otoone-dev/docs/afuue_project/pictures/printing.png

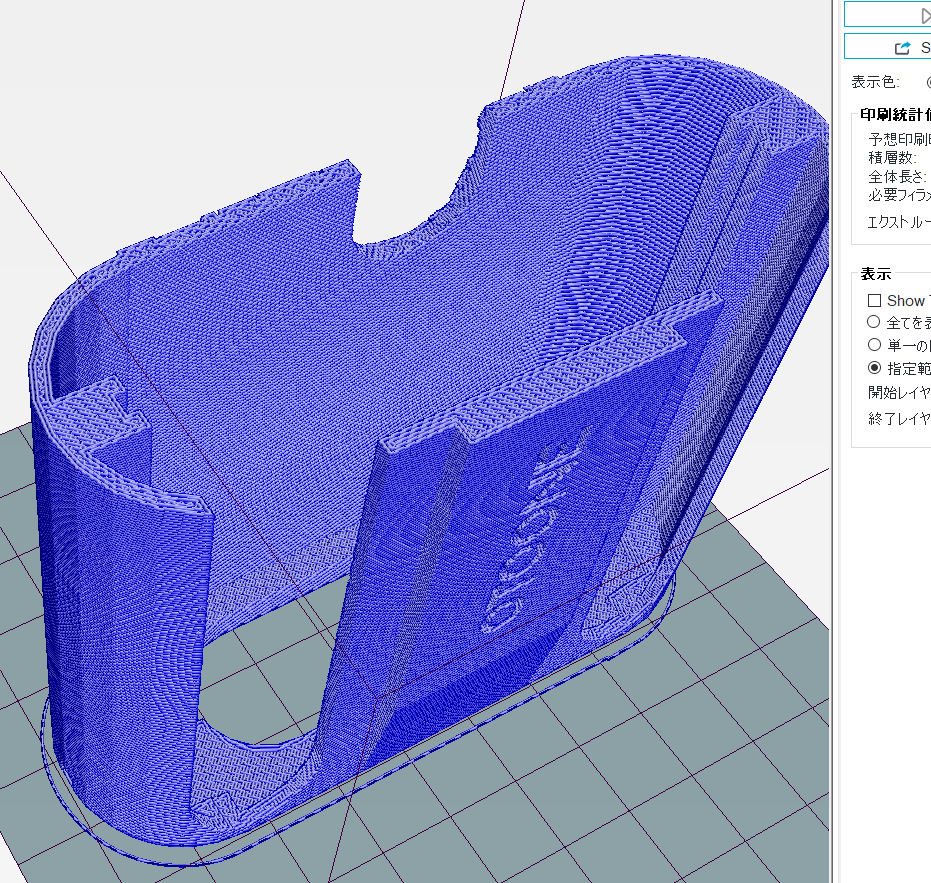
afuue_project/pictures/printing.png
