otoone-dev/docs/afuue_project/pictures/soldering.jpg

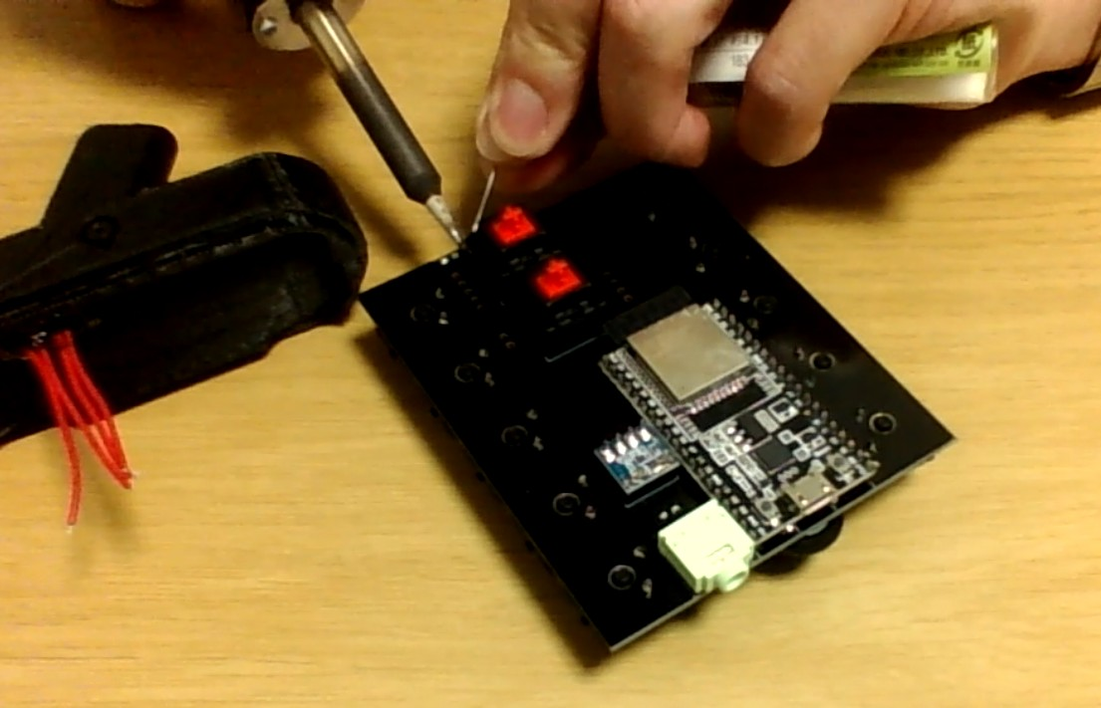
afuue_project/pictures/soldering.jpg
