otoone-dev/docs/afuue_project/pictures/afuue2.jpg

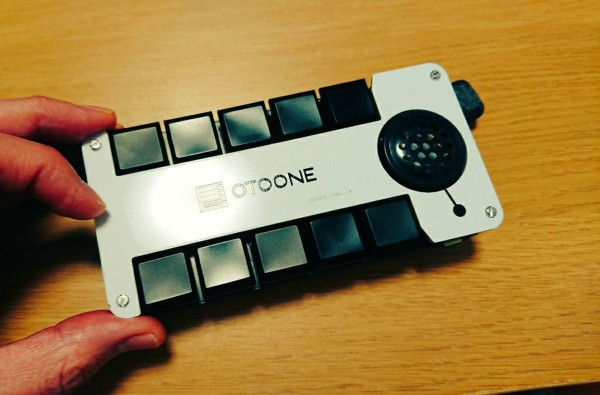
afuue_project/pictures/afuue2.jpg
