otoone-dev/docs/afuue_project/pictures/afuue2_back.jpg

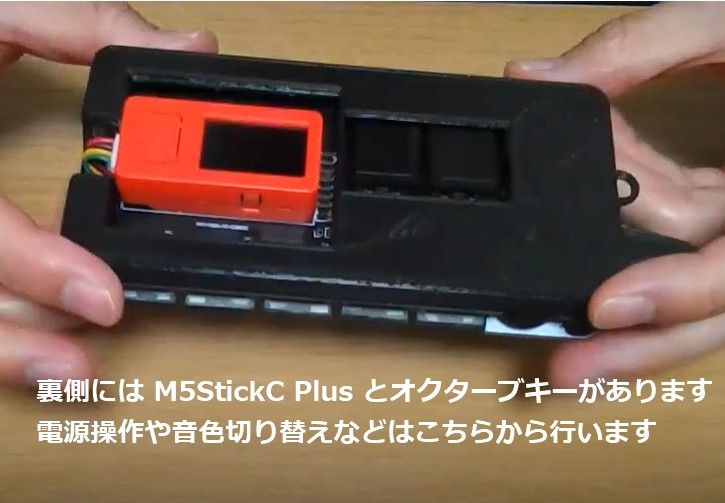
afuue_project/pictures/afuue2_back.jpg
