otoone-dev/docs/afuue_project/pictures/AFUUE2_FootController.JPG

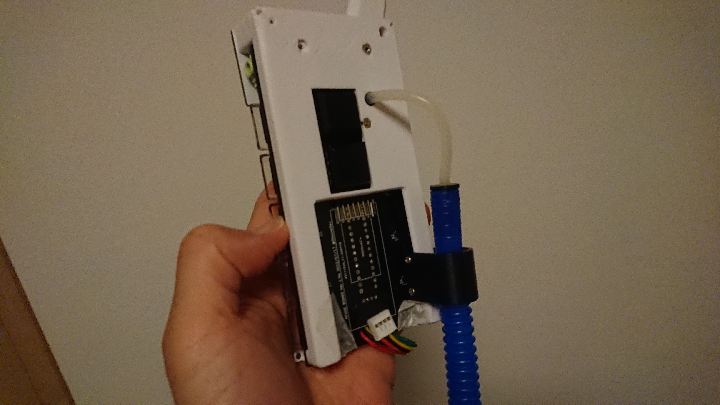
afuue_project/pictures/AFUUE2_FootController.JPG
