otoone-dev/docs/afuue_project/pictures/AFUUE2_PCB.JPG

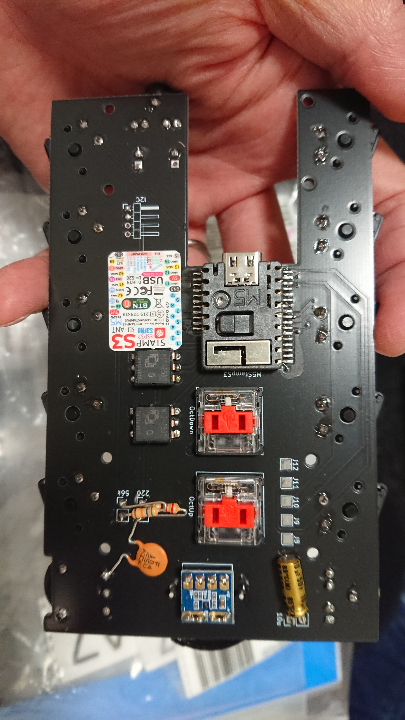
afuue_project/pictures/AFUUE2_PCB.JPG
