otoone-dev/docs/afuue_project/pictures/afuue2r.jpg

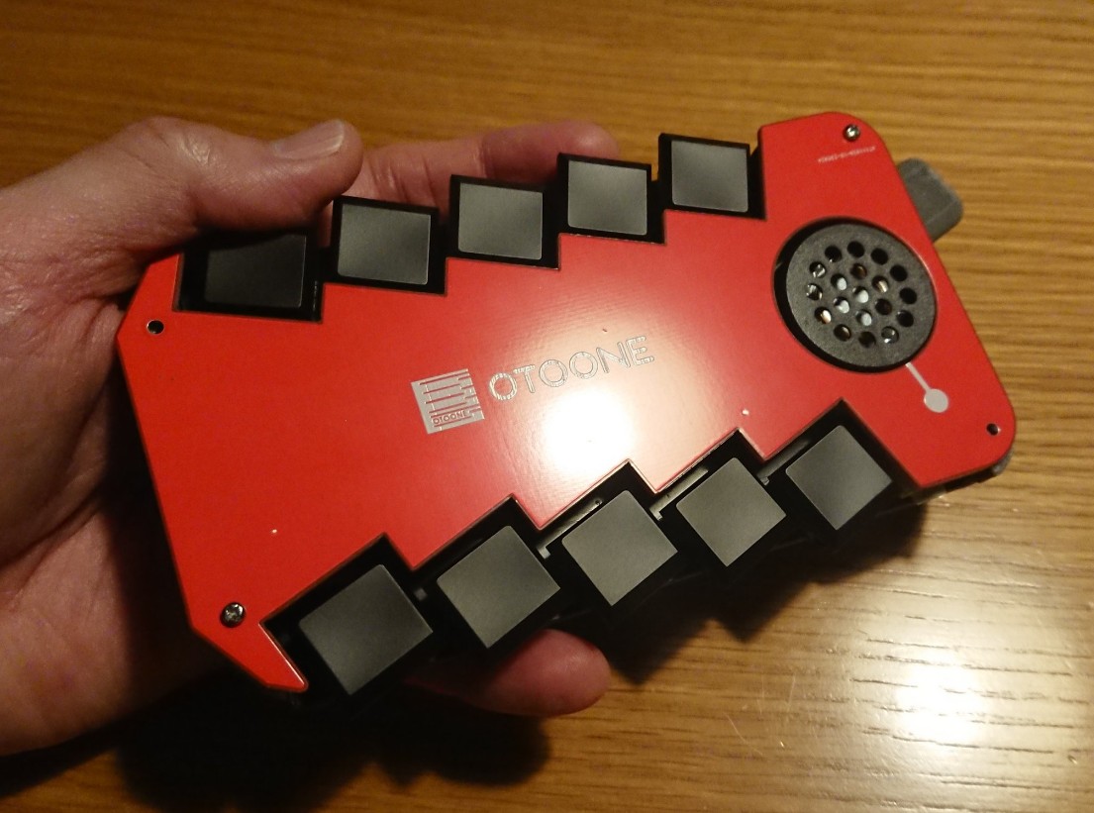
afuue_project/pictures/afuue2r.jpg
