otoone-dev/docs/afuue_project/pictures/afuue2r_cad.jpg

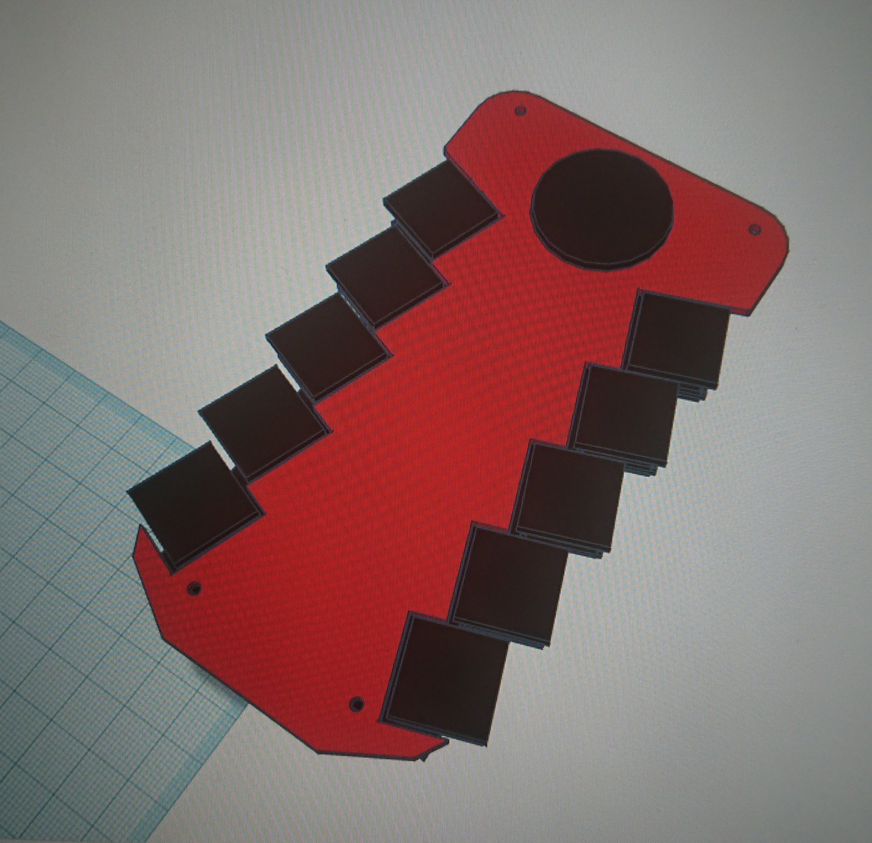
afuue_project/pictures/afuue2r_cad.jpg
