otoone-dev/docs/afuue_project/pictures/AFUUE2R_pict.jpg

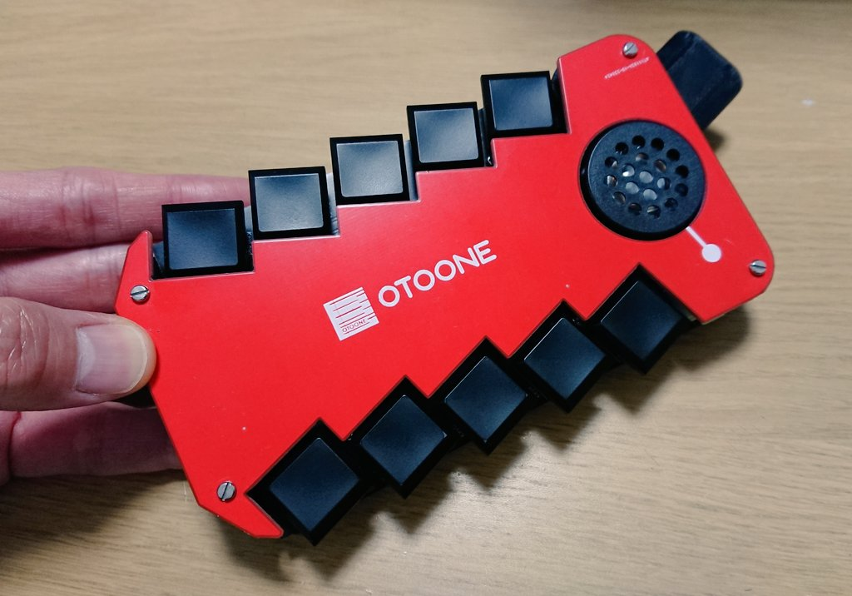
afuue_project/pictures/AFUUE2R_pict.jpg
