otoone-dev/docs/afuue_project/pictures/afuue9.jpg

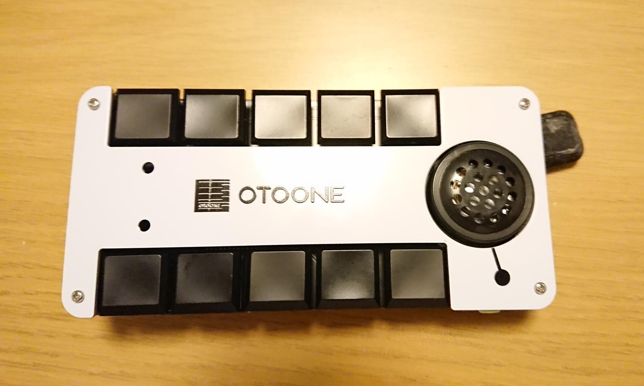
afuue_project/pictures/afuue9.jpg
