otoone-dev/docs/afuue_project/pictures/afuue9_overview.png

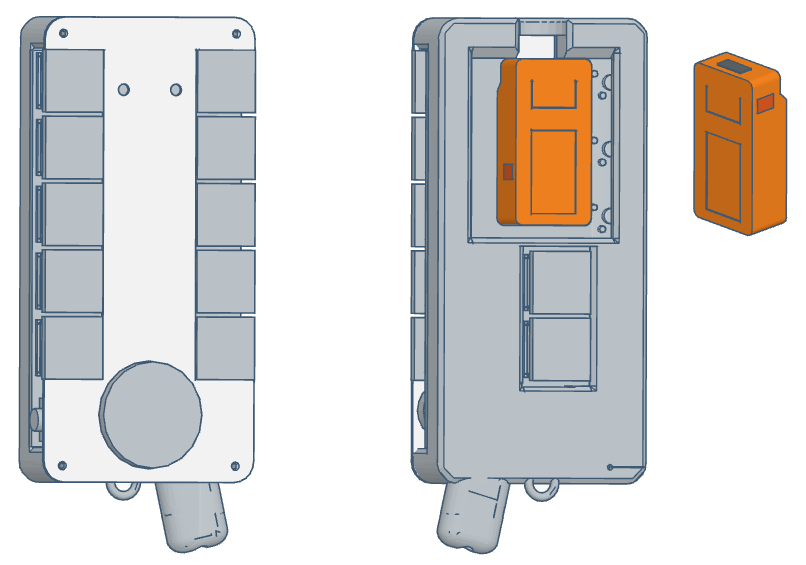
afuue_project/pictures/afuue9_overview.png
