otoone-dev/docs/afuue_project/pictures/afuue10.jpg

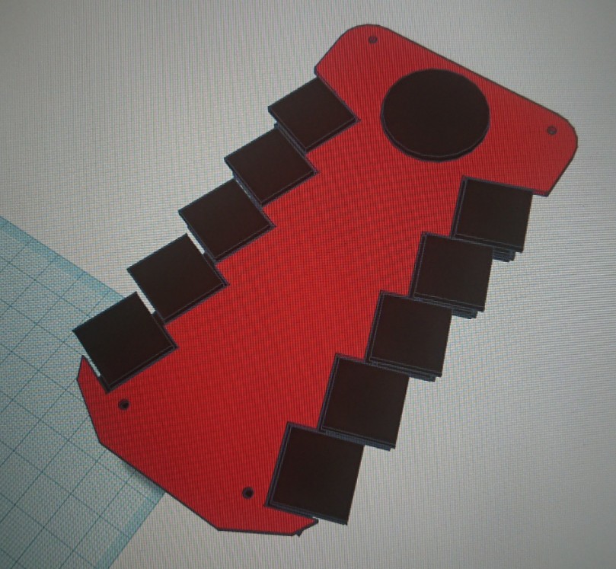
afuue_project/pictures/afuue10.jpg
