otoone-dev/docs/afuue_project/pictures/afuue.jpg

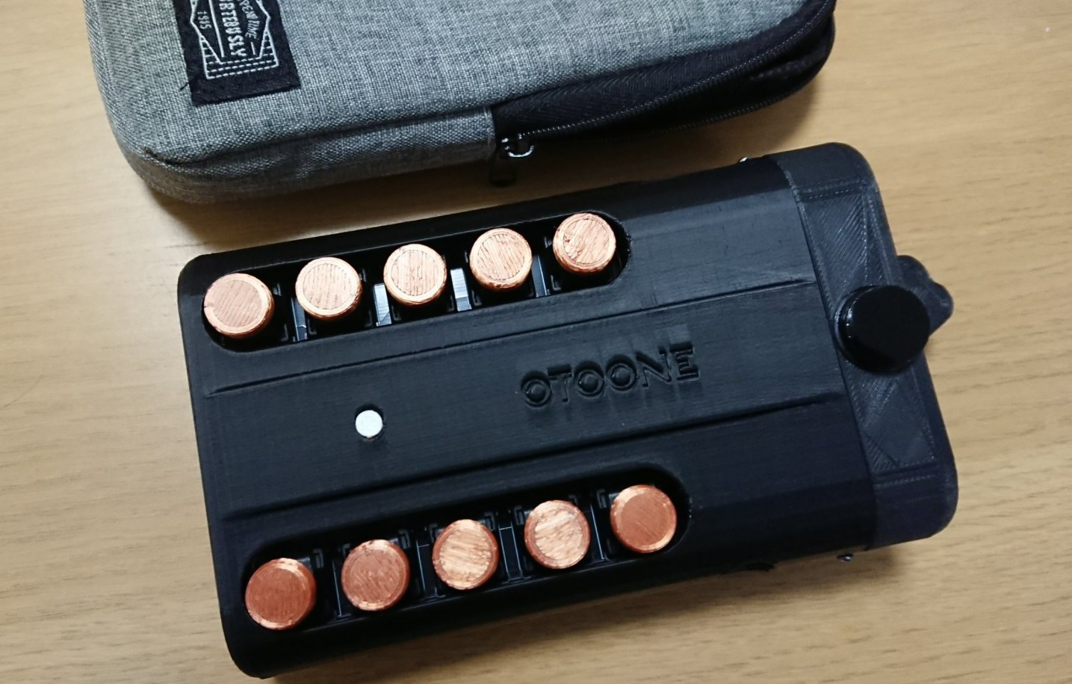
afuue_project/pictures/afuue.jpg
