otoone-dev/docs/afuue_project/pictures/arduino_ide.png

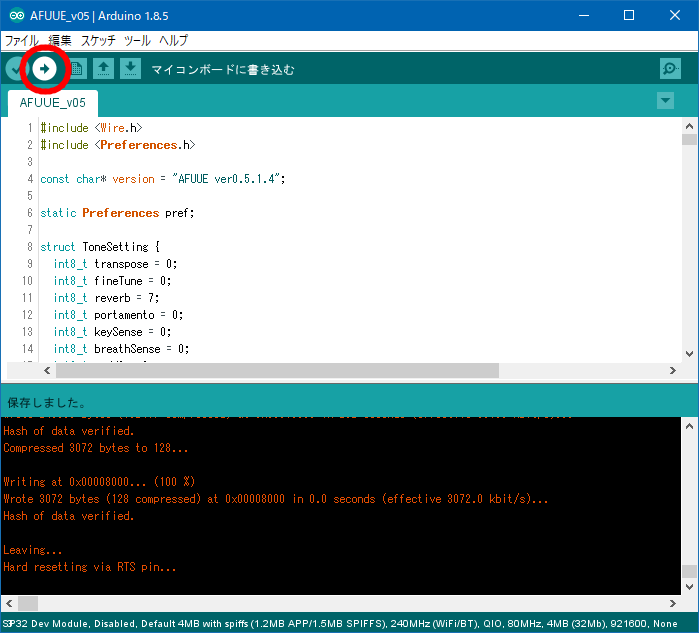
afuue_project/pictures/arduino_ide.png
