otoone-dev/docs/afuue_project/pictures/electrical_circuit.png

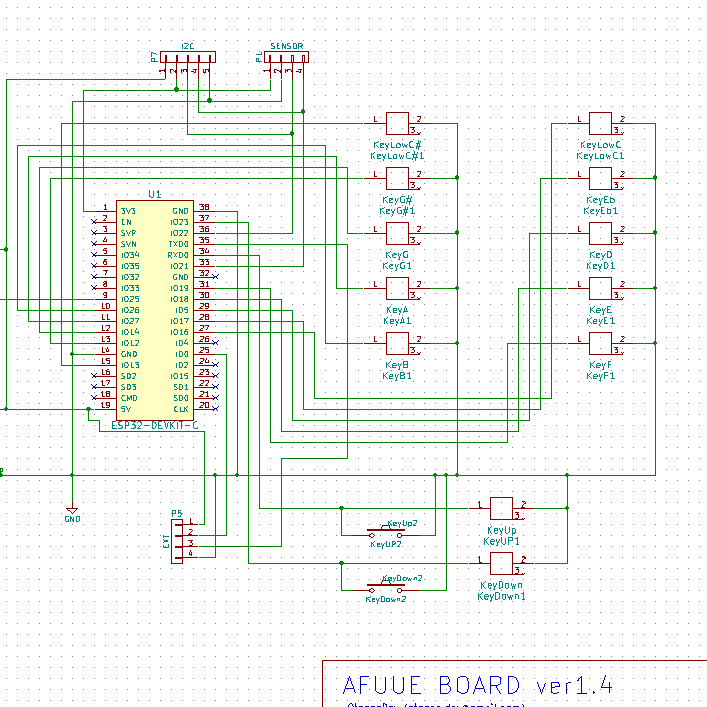
afuue_project/pictures/electrical_circuit.png
