otoone-dev/docs/afuue_project/pictures/modeling.png

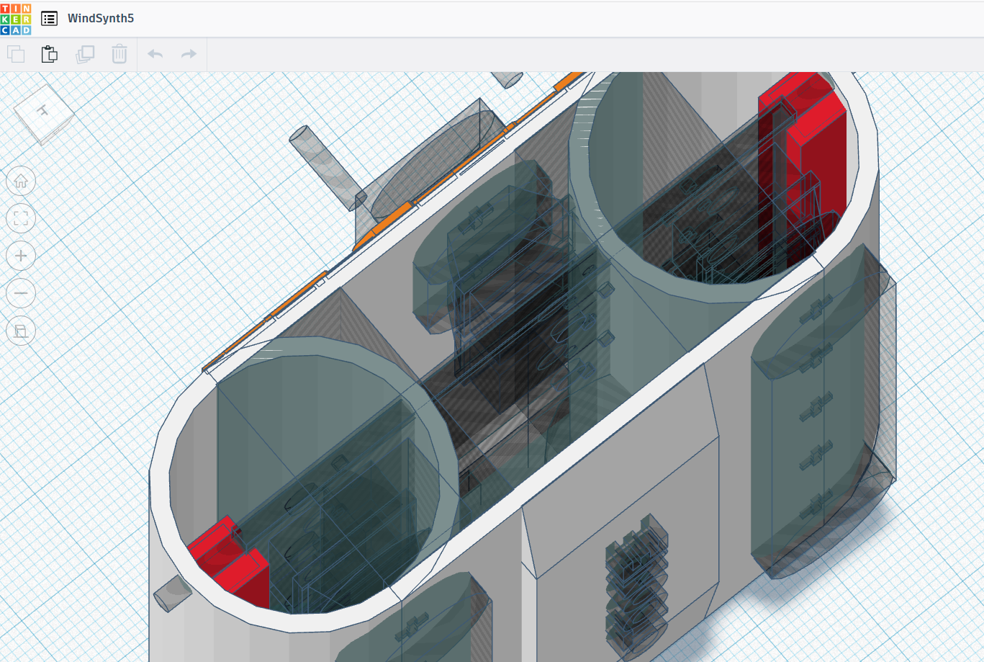
afuue_project/pictures/modeling.png
