otoone-dev/docs/afuue_project/pictures/my_afuue_creator.png

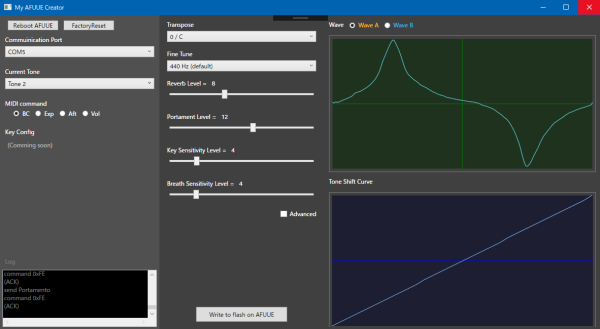
afuue_project/pictures/my_afuue_creator.png
