otoone-dev/docs/afuue_project/pictures/namecard/background2.png

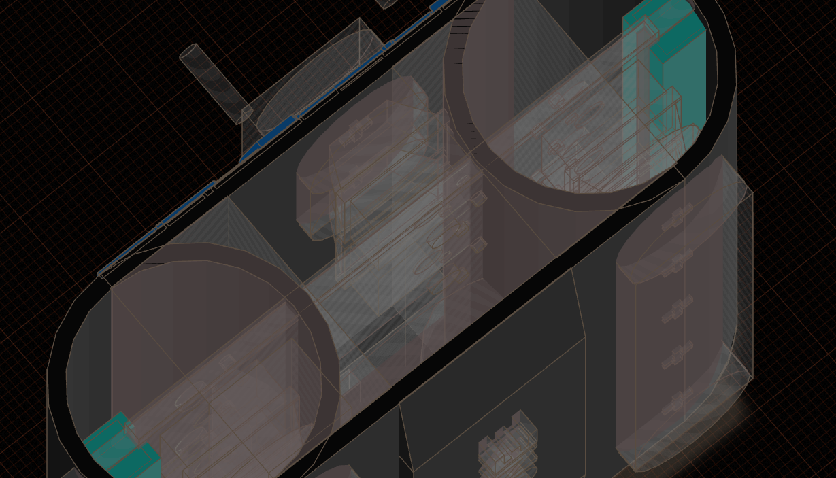
afuue_project/pictures/namecard/background2.png
