otoone-dev/docs/afuue_project/pictures/namecard/background.png

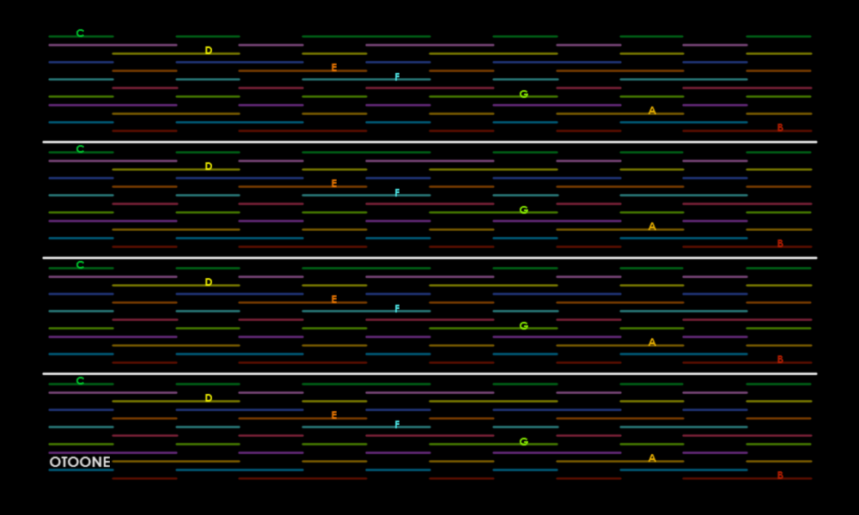
afuue_project/pictures/namecard/background.png
