otoone-dev/docs/afuue_project/pictures/programming_arduino.png

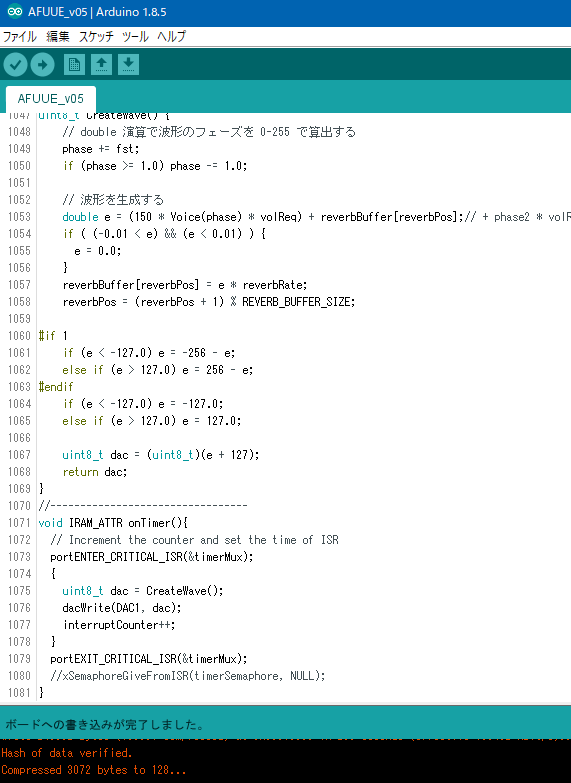
afuue_project/pictures/programming_arduino.png
