otoone-dev/docs/afuue_project/pictures/programming_windows.png

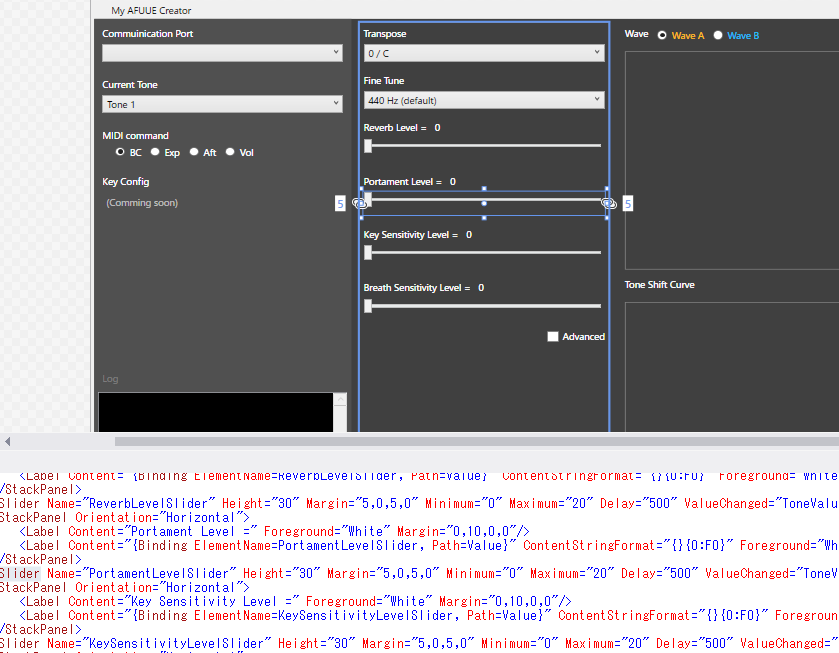
afuue_project/pictures/programming_windows.png
