otoone-dev/docs/afuue_project/pictures/shield_machine.jpg

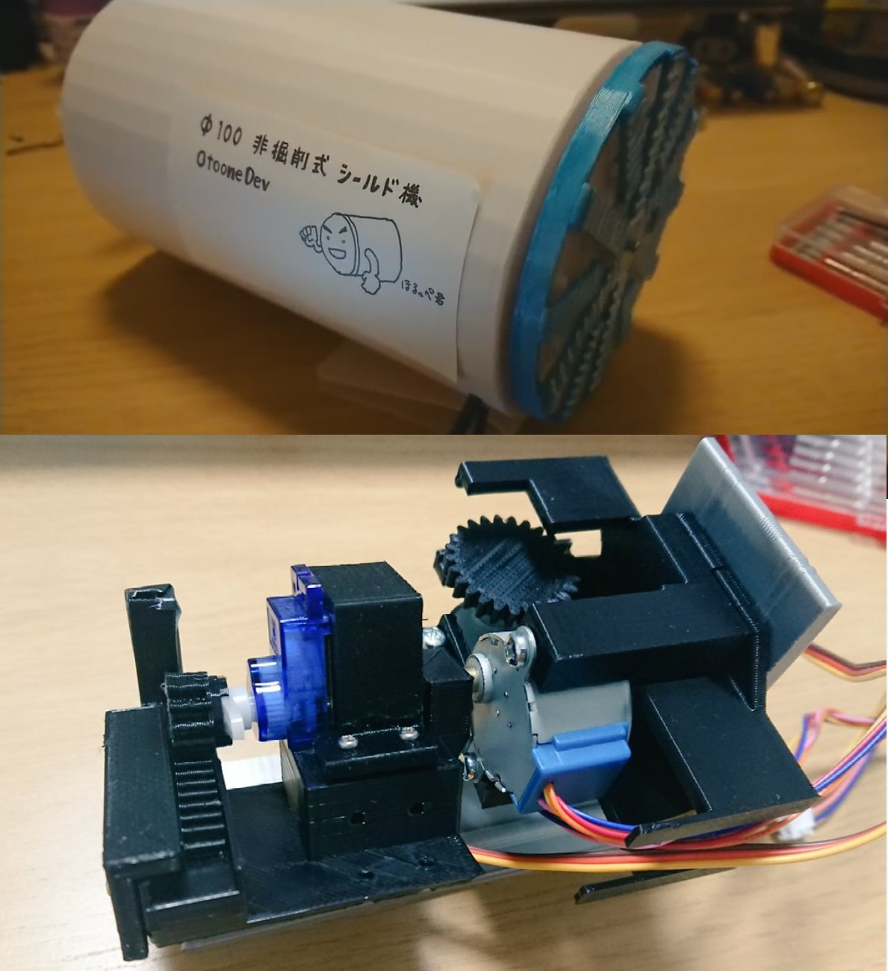
afuue_project/pictures/shield_machine.jpg
