otoone-dev/docs/afuue_project/pictures/twitter.png

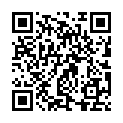
afuue_project/pictures/twitter.png
