otoone-dev/docs/afuue_project/pictures/webpage.png

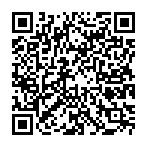
afuue_project/pictures/webpage.png
