otoone-dev/docs/afuue_project/pictures/white.png

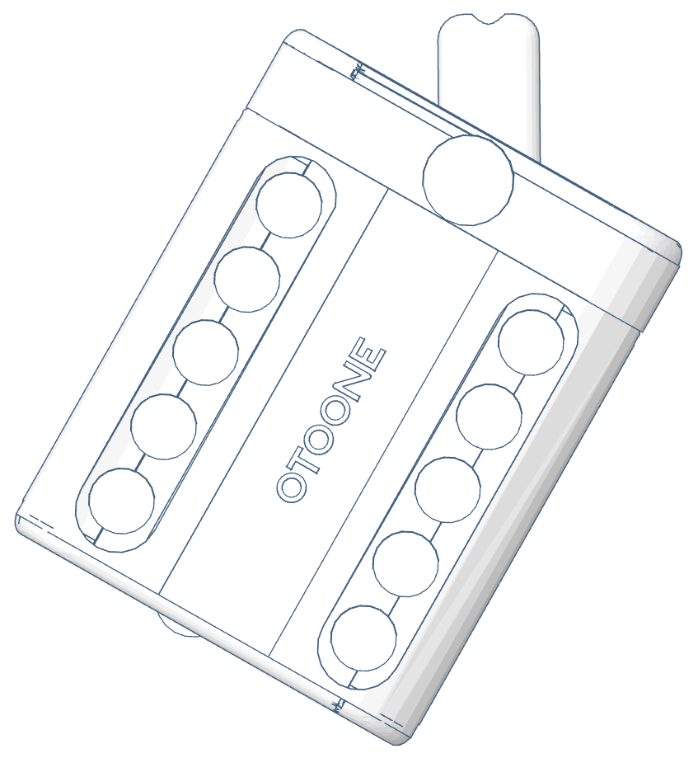
afuue_project/pictures/white.png
