otoone-dev/docs/afuue_project/Tool/MyAfuueCreator/MyAfuueCreator/Resources/FingeringChart.png

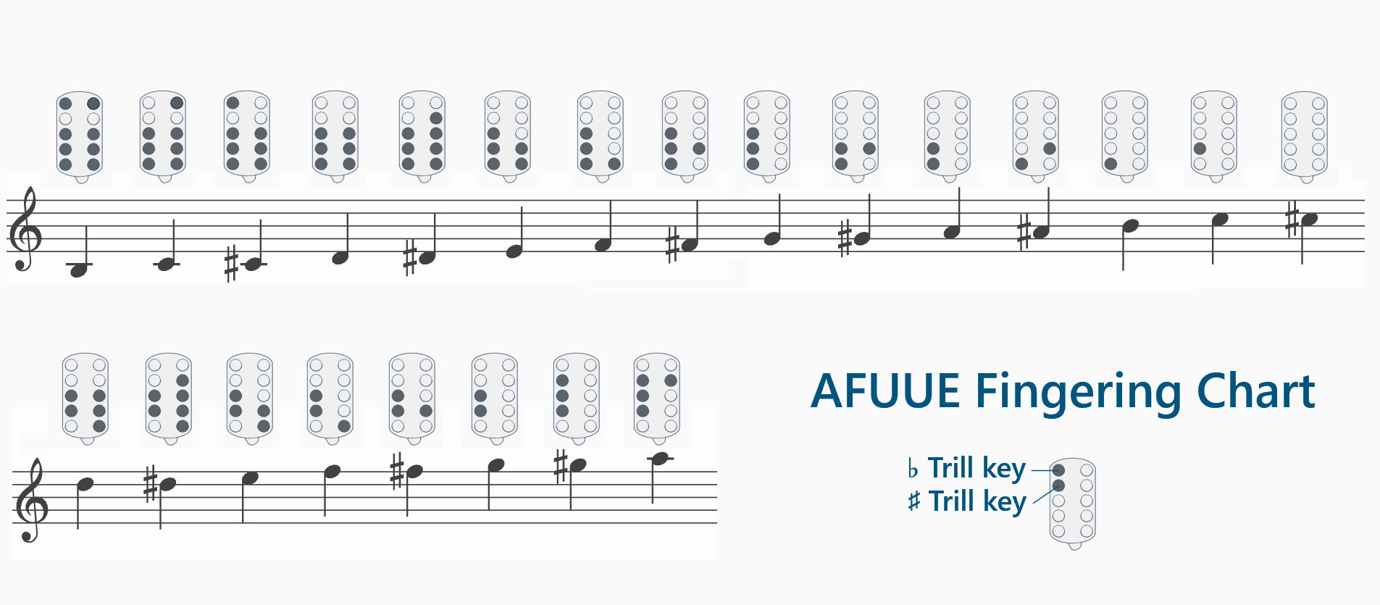
afuue_project/Tool/MyAfuueCreator/MyAfuueCreator/Resources/FingeringChart.png
