otoone-dev/docs/arduino/M5Stamp/PC1245/E500_font.png

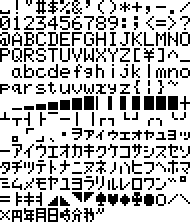
arduino/M5Stamp/PC1245/E500_font.png
