otoone-dev/docs/arduino/M5Stamp/PC1245/pc1245Revived.png

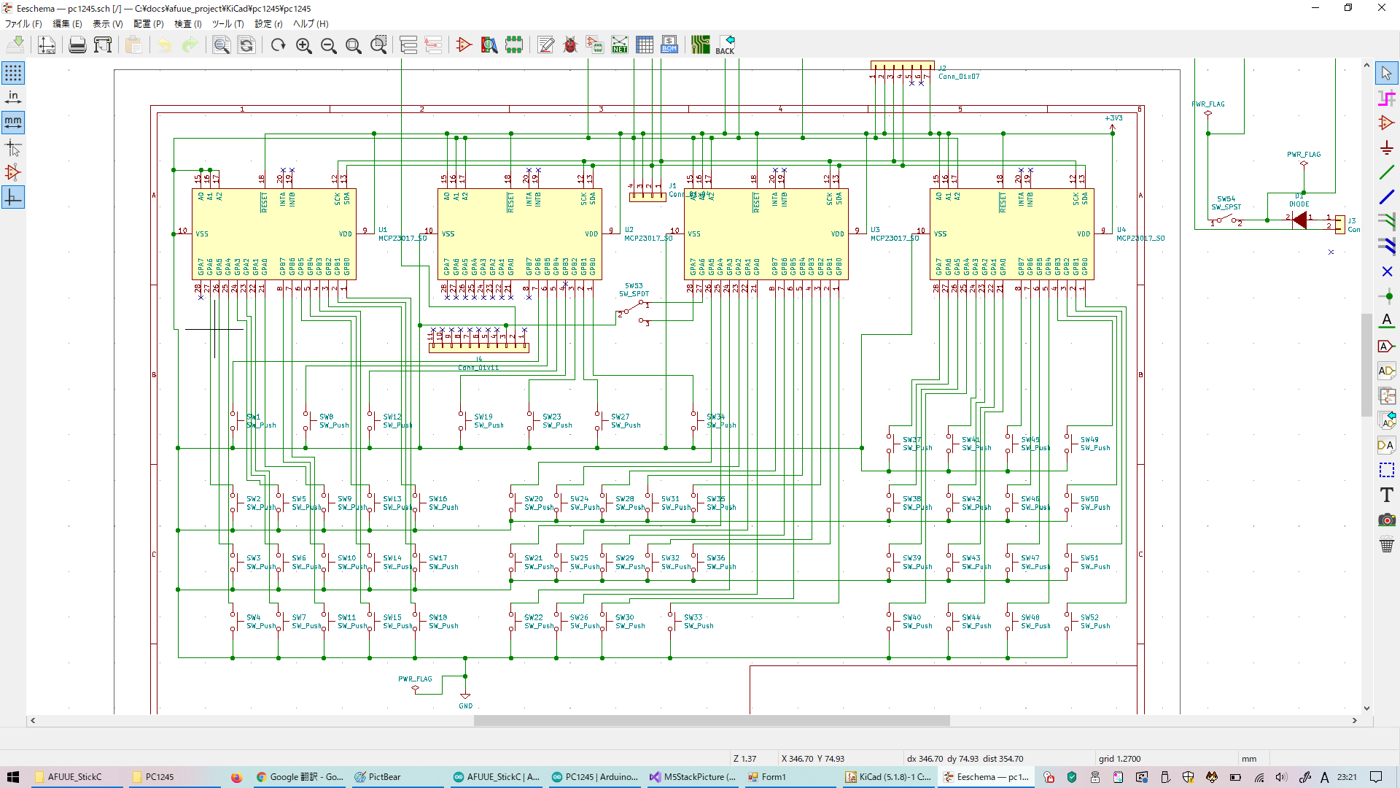
arduino/M5Stamp/PC1245/pc1245Revived.png
