otoone-dev/docs/images/afuue6.jpg

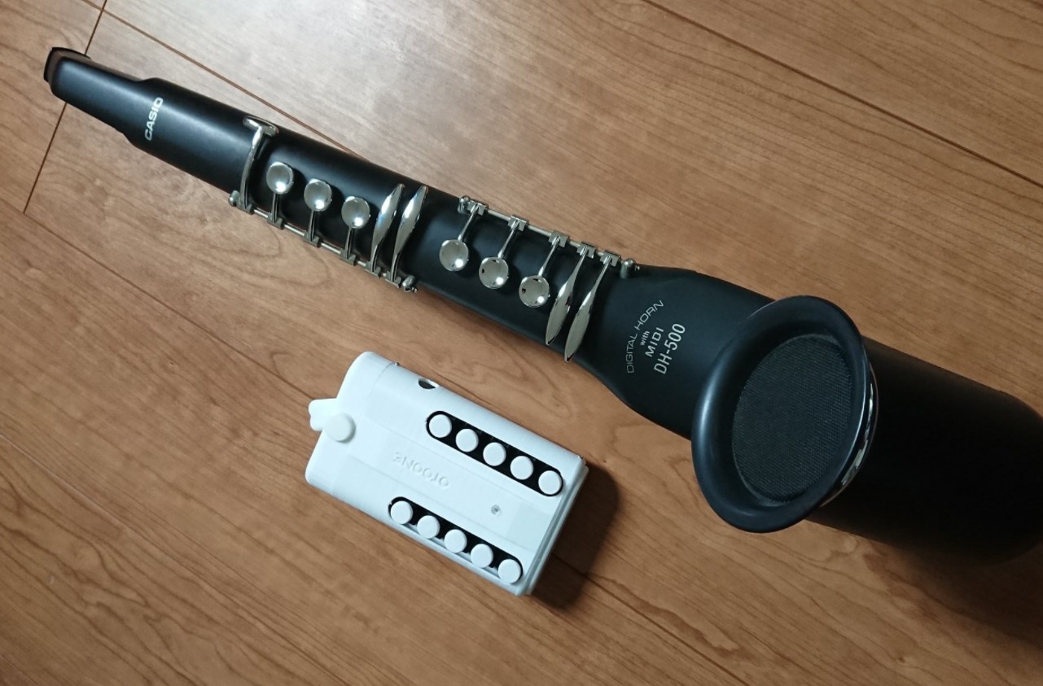
images/afuue6.jpg
