otoone-dev/docs/images/afuue_family.jpg

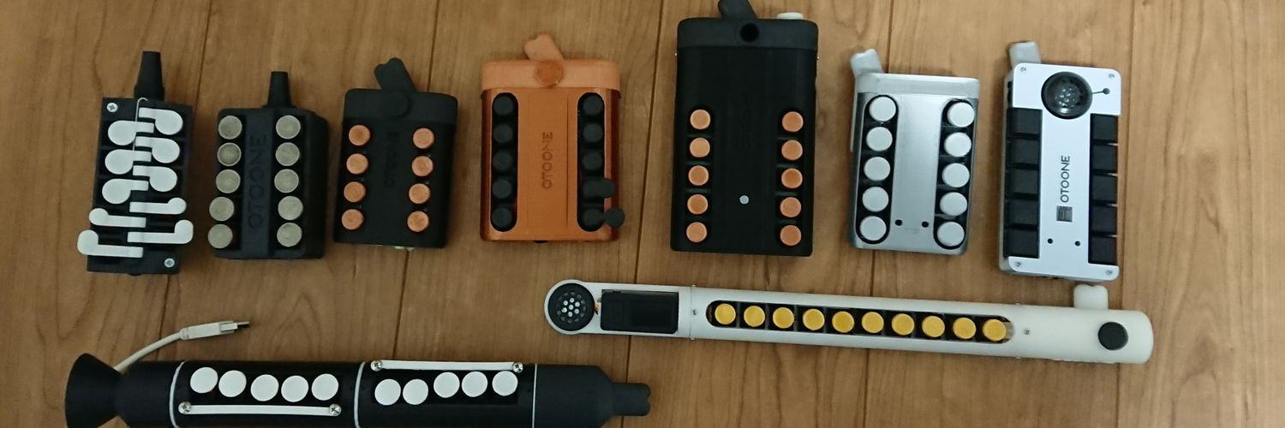
images/afuue_family.jpg
