otoone-dev/docs/images/afuue_prototypes.jpg

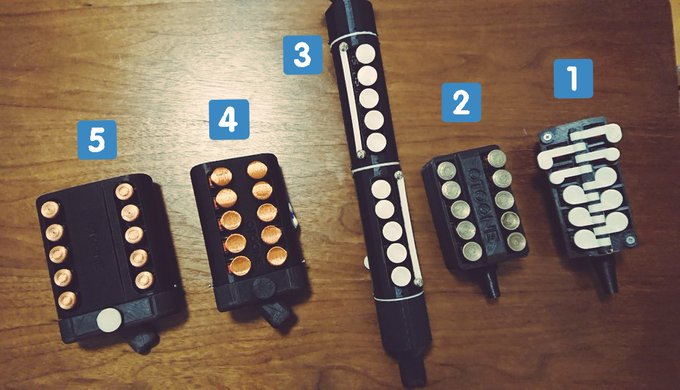
images/afuue_prototypes.jpg
