otoone-dev/docs/images/afuue_size.jpg

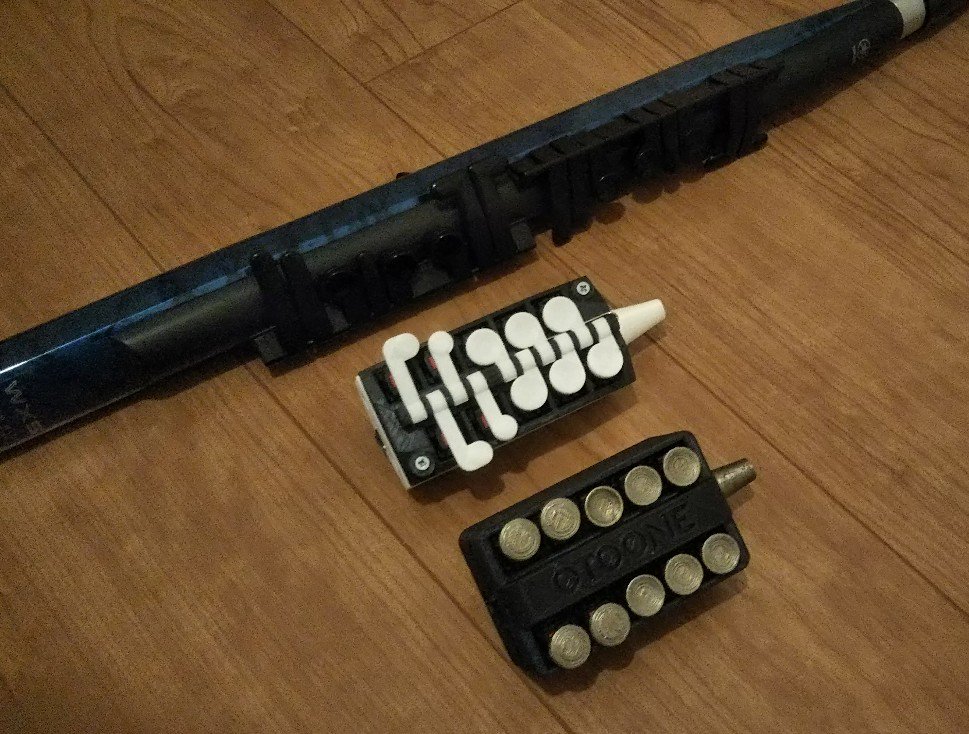
images/afuue_size.jpg
