otoone-dev/docs/images/inst_01.jpg

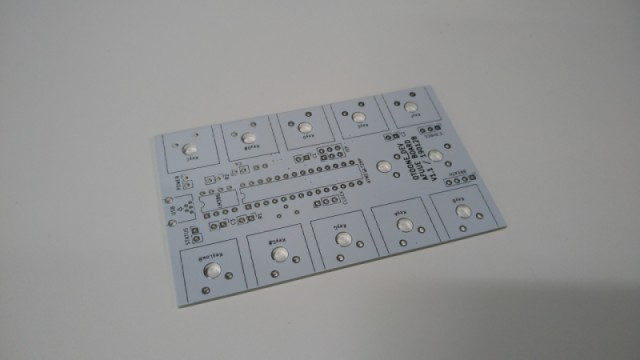
images/inst_01.jpg
