otoone-dev/docs/images/inst_02.jpg

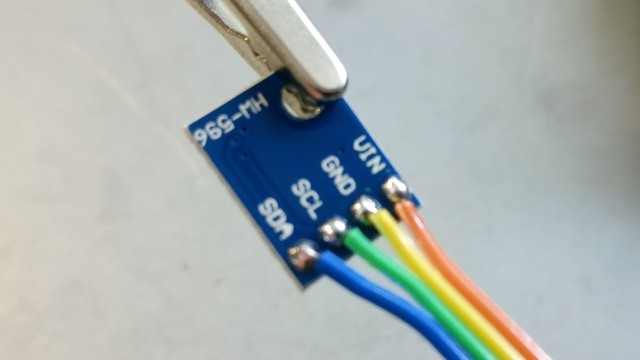
images/inst_02.jpg
