otoone-dev/docs/images/inst_03.jpg

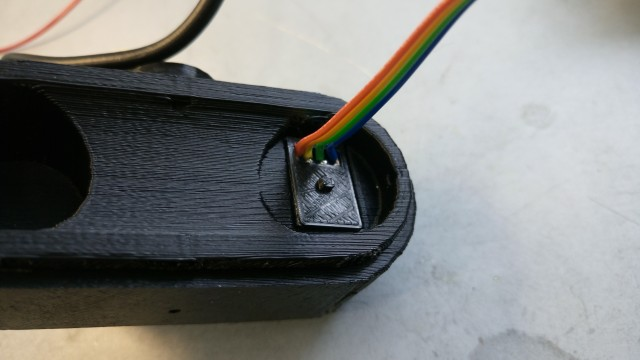
images/inst_03.jpg
