otoone-dev/docs/images/inst_04.jpg

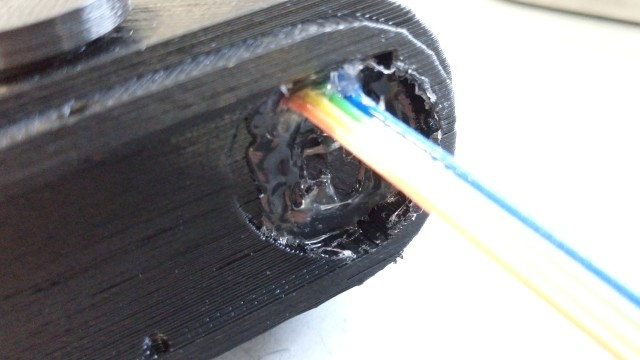
images/inst_04.jpg
