otoone-dev/docs/images/inst_06.jpg

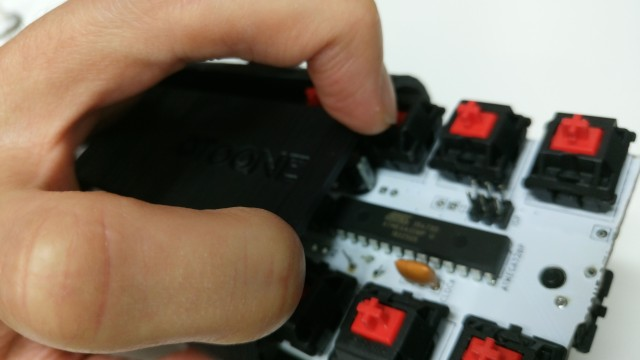
images/inst_06.jpg
