otoone-dev/docs/images/inst_07.jpg

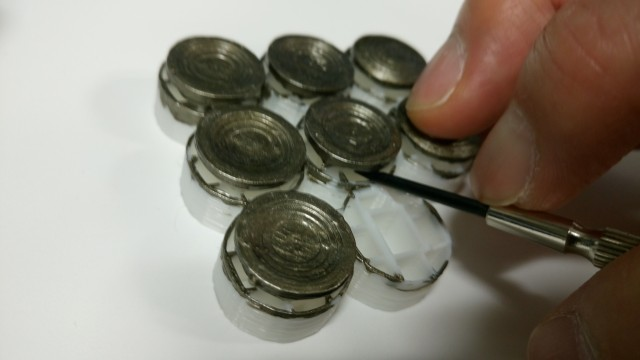
images/inst_07.jpg
