otoone-dev/docs/images/inst_08.jpg

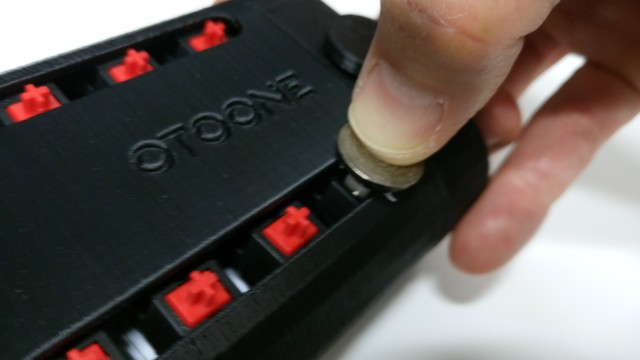
images/inst_08.jpg
