otoone-dev/docs/images/inst_09.jpg

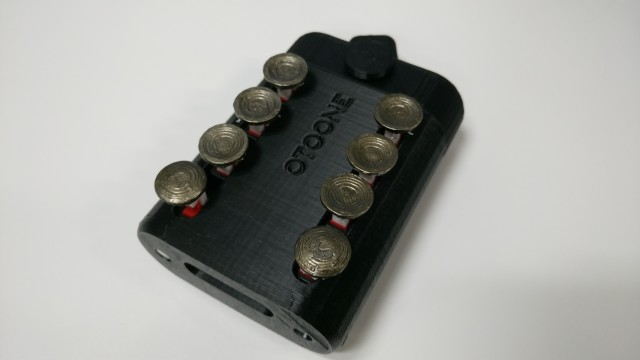
images/inst_09.jpg
