otoone-dev/docs/images/otoone_app.jpg

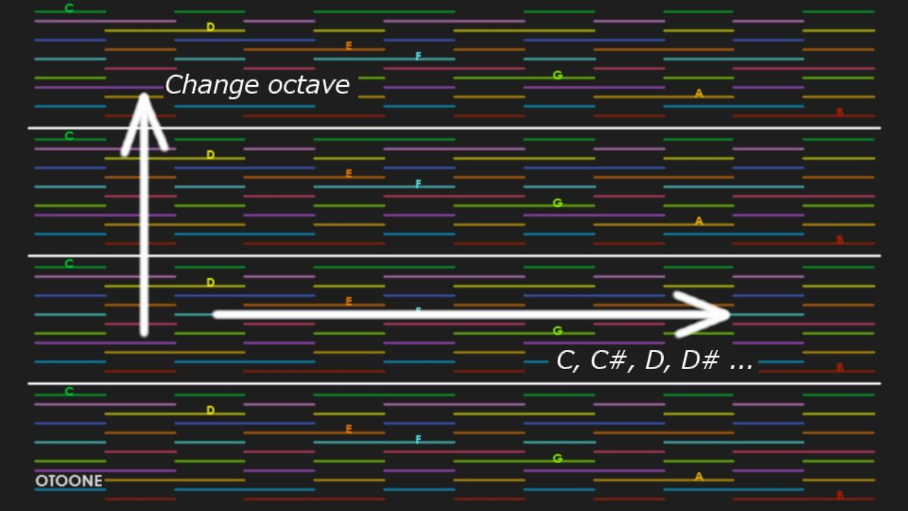
images/otoone_app.jpg
