otoone-dev/docs/images/pcb.jpg

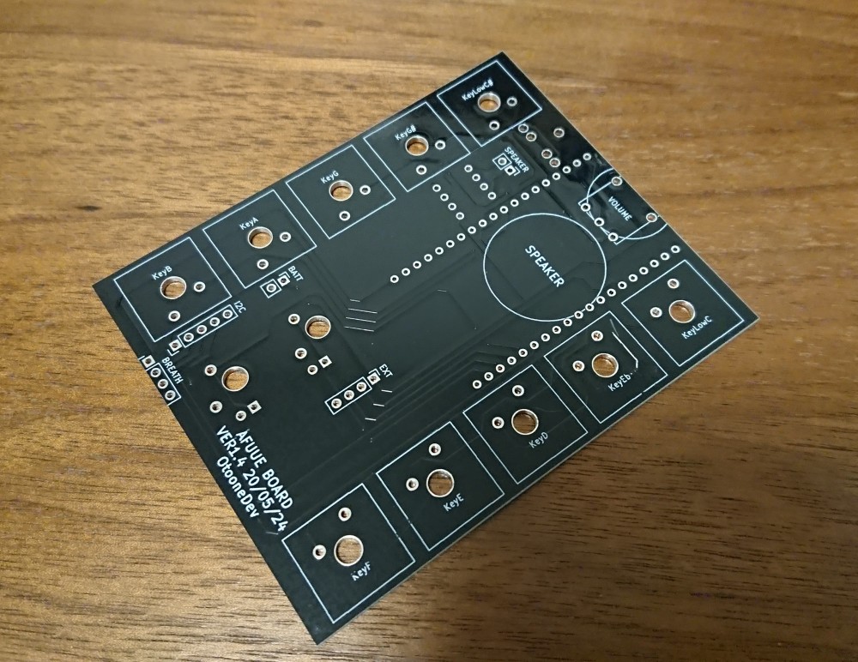
images/pcb.jpg
