otoone-dev/docs/watch_bg.png

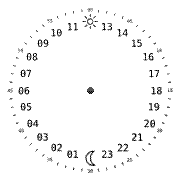
watch_bg.png
