otoone-dev/docs/afuue_project/KiCad/test/order.txt

お支払いいただき、ありがとうございました

お客さまのご注文番号P178677

取引参照番号9GE45182GT647472R

金額￥2,469  JPY

YASUHIRO OTOWA様、お支払いが完了しました。ご注文内容についてご質問がございましたら、以下の番号まで電話でお問い合わせください。
ショッピングサイトに戻る:   

連絡先sales@switch-science.com
362653615

注文の明細

    小計￥ 2,469

    合計 (JPY)￥ 2,469

-----------------------------------

お客さまのご注文番号P191622

取引参照番号79R70965E8740543H

金額￥2,469  JPY

YASUHIRO OTOWA様、お支払いが完了しました。ご注文内容についてご質問がございましたら、以下の番号まで電話でお問い合わせください。
ショッピングサイトに戻る:   

連絡先sales@switch-science.com
362653615

注文の明細

    小計￥ 2,469

    合計 (JPY)￥ 2,469
