otoone-dev/docs/afuue_project/パーツリスト.xls

Sheet: Sheet1
AFUUE ver1.6 部品表
品名 | 単価 | 数量 | 購入価格 | 在庫 | 対応台数 | 購入先
プリント基板 | 680 | 1 | 680 | 0 | 0 | Seeed Fusion PCB | 上がるかもしれない
ボディ (3Dプリンタ) | 600 | 1 | 600 | 5 | 5 |  | ３万円 / 50台 = 600円 くらい？
マウスピース (3Dプリンタ) | 300 | 1 | 300 | 5 | 5
キー (3Dプリンタ、レジン加工済) | 50 | 12 | 600 | 108 | 9
メンテナンスホールキャップ (3Dプリンタ) | 50 | 1 | 50 | 13 | 13
LEDベース (3Dプリンタ) | 30 | 1 | 30 | 10 | 10
LEDディフューザ (3Dプリンタ) | 30 | 1 | 30 | 10 | 10
Cherry MX 赤軸 | 77 | 12 | 924 | 106 | 8.833333333 | JWシステム | https://www.jw-shop.com/P-keyboard-mswitch10/page40/detail.htm
ESP32-DEVKIT-C V4 | 1480 | 1 | 1480 | 10 | 10 | 秋月電子 | http://akizukidenshi.com/catalog/g/gM-11819/ | Amazon Waves製品なら 1,000円くらい
AE-PAM8012 | 300 | 1 | 300 | 9 | 9 | 秋月電子 | http://akizukidenshi.com/catalog/g/gK-08217/
連結ソケット | 54 | 1 | 54 | 9 | 9 | 秋月電子 | http://akizukidenshi.com/catalog/g/gP-00264/
基板実装型スピーカー UGSM30B-8-01 | 100 | 1 | 100 | 9 | 9 | 秋月電子 | https://akizukidenshi.com/catalog/g/gP-09271/
006P バッテリーホルダー | 50 | 1 | 50 | 9 | 9 | 秋月電子 | https://akizukidenshi.com/catalog/g/gP-08160/
定電流発光ダイオード (φ3 白) OSM5DK5A31A? | 20 | 1 | 20 | 9 | 9 | 秋月電子 | https://akizukidenshi.com/catalog/g/gI-10739/
78L05 | 30 | 1 | 30 | 12 | 12 | aitendo | https://www.aitendo.com/product/3288
3.5 オーディオジャック PJ-307 (緑) | 30 | 1 | 30 | 11 | 11 | aitendo | https://www.aitendo.com/product/11073 (PJ-325)
3.5 オーディオジャック PJ-307 (黒) | 30 | 1 | 30 | 10 | 10 | aitendo | https://www.aitendo.com/product/4432 (PJ-307)
気圧センサ BMP180 モジュール | 495 | 1 | 495 | 11 | 11 | aitendo | https://www.aitendo.com/product/10760 | ディスコン？Amazon HiLetgo製品なら 200円
ダイヤル可変抵抗 (R1001-N16 B10KΩ-T1) | 50 | 1 | 50 | 11 | 11 | aitendo | https://www.aitendo.com/product/5202
抵抗 (47 Ω) | 5 | 2 | 10 | 多数 |  | aitendo | https://www.aitendo.com/product/14366
抵抗 (510 Ω) | 5 | 1 | 5 | 多数 |  | aitendo | https://www.aitendo.com/product/14366
HYコネクタ４ピンアングル | 10 | 1 | 10 | 17 | 17 | aitendo | https://www.aitendo.com/product/19473
HYコネクタ付ケーブル (CB-HY-200S) | 70 | 1 | 70 | 12 | 12 | aitendo | https://www.aitendo.com/product/18805
M2 ネジ | 5 | 2 | 10 | 多数
梱包用の小袋 |  |  | 0
発送用の緩衝材 |  |  | 0
発送用の箱？ |  |  | 0
手数料 |  |  | 500
合計 (送料、消費税除く) |  |  | 6458
送料 (秋月電子) | 500 |  | 100 |  |  |  | ５台まとめて買ったとして。
送料 (aitendo) | 490 |  | 100
送料 (JWシステム) | 800 |  | 160
合計 (消費税除く) |  |  | 6818
 |  |  | 11363

Sheet: Sheet2
AFUUE 組み立て手順（簡易版） 詳しい組み立て方は https://otoonedev.wixsite.com/afuue から「組み立て手順」を参照してください。 右下の QR コードからでも組み立て手順ページにジャンプできます。
キーを接着剤で接合します | LEDはLEDベースに差し、 黒いコネクタ側が長い足に なるような向きで取付けます | 最初に表面でキースイッチを除く (*) のついてない部品のみを実装 します。Ver1.6B 基板では回路にミスがあるため、右下写真のように 47Ω抵抗を、クロスして取り付けてください。 | つづいて裏面を実装します。 | 表面の残りの部品を実装します。
マウスピースに BMP180 センサーを写真の向きで 挿入します。 | グルーガンなどで隙間を 埋めます。 | 基板をボディに挿入します。 | 途中でマウスピースのコネクタを 接続します。余ったケーブルは曲げたり 巻いたりして、うまく収めます。 | M2ネジでボディとマウスピースを 固定します。
 |  |  |  | 詳しい組み立て手順は↓から
LEDカバーをボディに入れ ます。固い場合は削って ください。緩い場合は接着剤 などを使ってください。 | キー（厚みのない方）を 10 個 表面側にはめ込みます。 やや固いですが、グッと押し 込んでください。 | キー（厚みのある方）を 2 個、 裏面側にはめ込みます。 | マウスピースのホールキャップを 写真の位置に取り付ければ完成です。 電池を入れて電源スイッチを ON に して吹いてください。

Sheet: Sheet4
詳しい取り扱い説明は https://otoonedev.wixsite.com/afuue の取扱説明書のページを参照ください。
下の QR コードからもジャンプできます。

Sheet: Sheet3
基板 | ボディ | マウスピース(黒) ホールキャップ(白) | キー組み立てセット x12 | キースイッチ x 12 | ESP32-DevKit-C | スピーカー
□梱包時 □お客様 | □梱包時 □お客様 | □梱包時 □お客様 | □梱包時 □お客様 | □梱包時 □お客様 | □梱包時 □お客様 | □梱包時 □お客様
バッテリーホルダー | BMP180 ケーブル付 | PAM8012 | L7805 | オーディオジャック x 2 | 定電流発光ダイオード | 連結ソケット
□梱包時 □お客様 | □梱包時 □お客様 | □梱包時 □お客様 | □梱包時 □お客様 | □梱包時 □お客様 | □梱包時 □お客様 | □梱包時 □お客様
ダイヤル可変抵抗 | 抵抗 (47Ω) x 2 | 抵抗 (510Ω) | HYコネクタ4pアングル | LEDベース(左) LEDカバー(右) | スイッチ | M2ネジ x 2
□梱包時 □お客様 | □梱包時 □お客様 | □梱包時 □お客様 | □梱包時 □お客様 | □梱包時 □お客様 | □梱包時 □お客様 | □梱包時 □お客様
梱包時にチェックマークを入れながら漏れがない事を確認しておりますが、お客様にて部品を再度確認いただき、チェックマークをつけてくださると幸いです。
不足している部品がありましたら otoone.dev@gmail.com までご連絡ください。
キースイッチの足は曲がりやすいものなので、そっと伸ばして使用してください。
ESP32-DevKit-C はソフトウェア書き込みのために開封しております。ご了承ください。
ESP32-DevKit-C の足は傾いてハンダ付けされているものがあります。入りにくい場合はペンチ等で足の傾きを矯正して使用ください。
部品が壊れている、取付けできない、等ありましたら otoone.dev@gmail.com まで連絡ください。見てわかる不具合の場合は写真を添えていただけると助かります。
