otoone-dev/docs/afuue_project/Manual/Parts_of_AFUUE.png

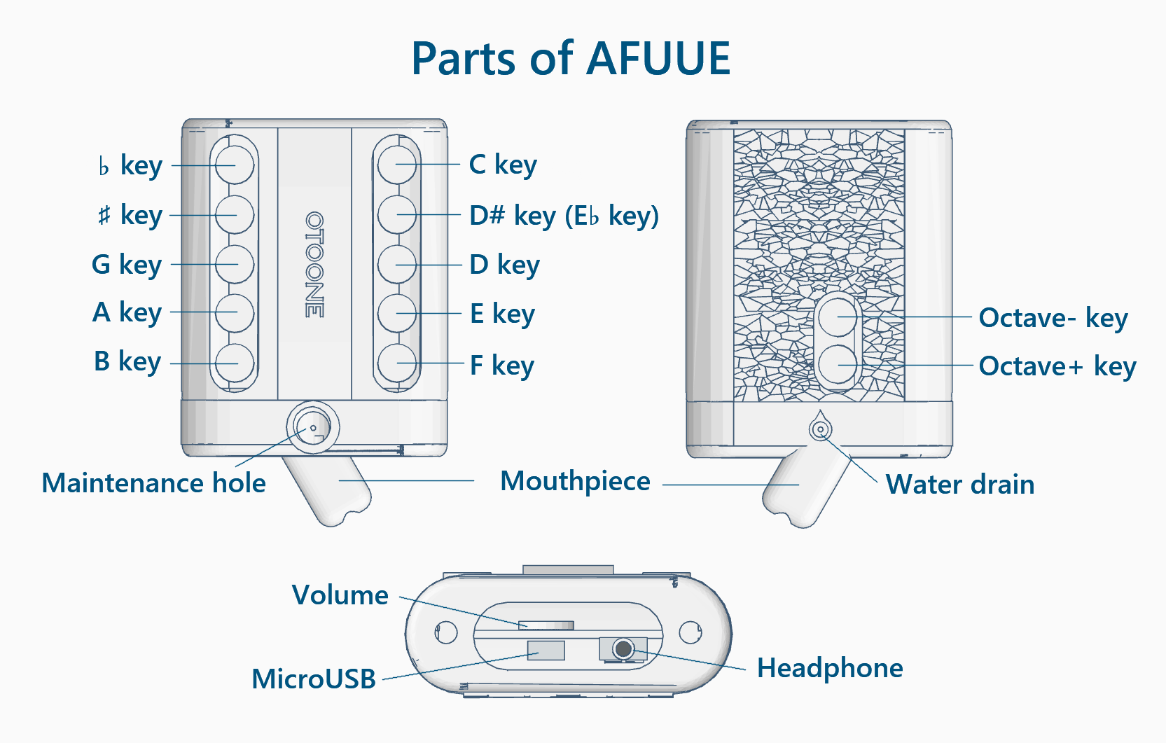
afuue_project/Manual/Parts_of_AFUUE.png
