otoone-dev/docs/afuue_project/KiCad/windsynth10/face/face/face.step

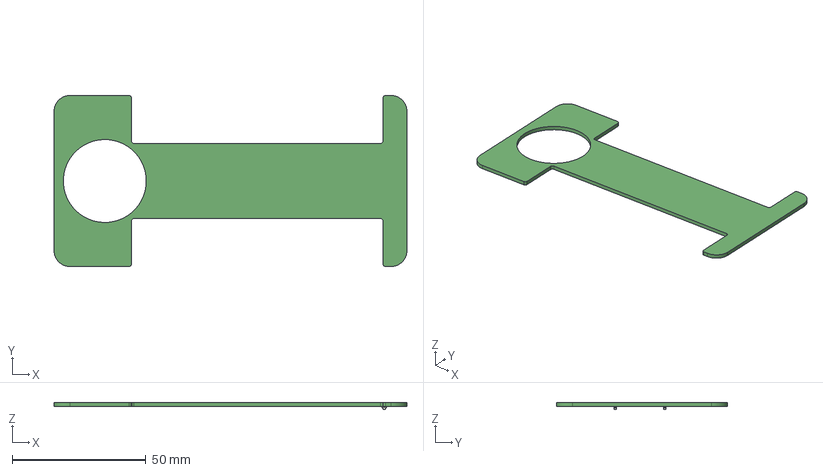
[picture p45: CAD file, 2022-12-07]
afuue_project/KiCad/windsynth10/face/face/face.step
132.0 x 64.0 x 2.75 mm
