otoone-dev/docs/afuue_project/Model3D/Logo.stl

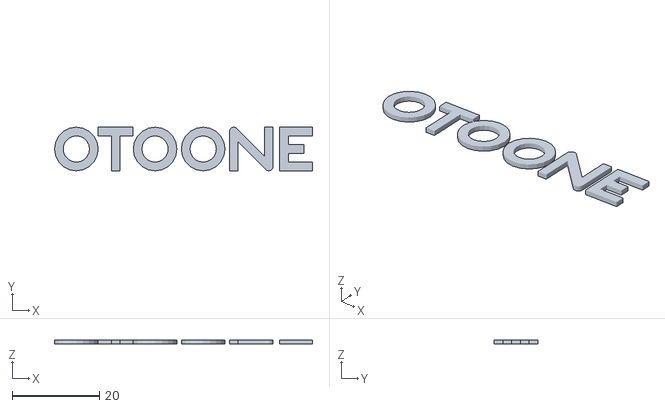
[picture p46: CAD file, 2021-12-04]
afuue_project/Model3D/Logo.stl
59.0 x 10.0 x 1.00
