otoone-dev/docs/afuue_project/Model3D/WindSynth4/WindSynth4Mini.stl

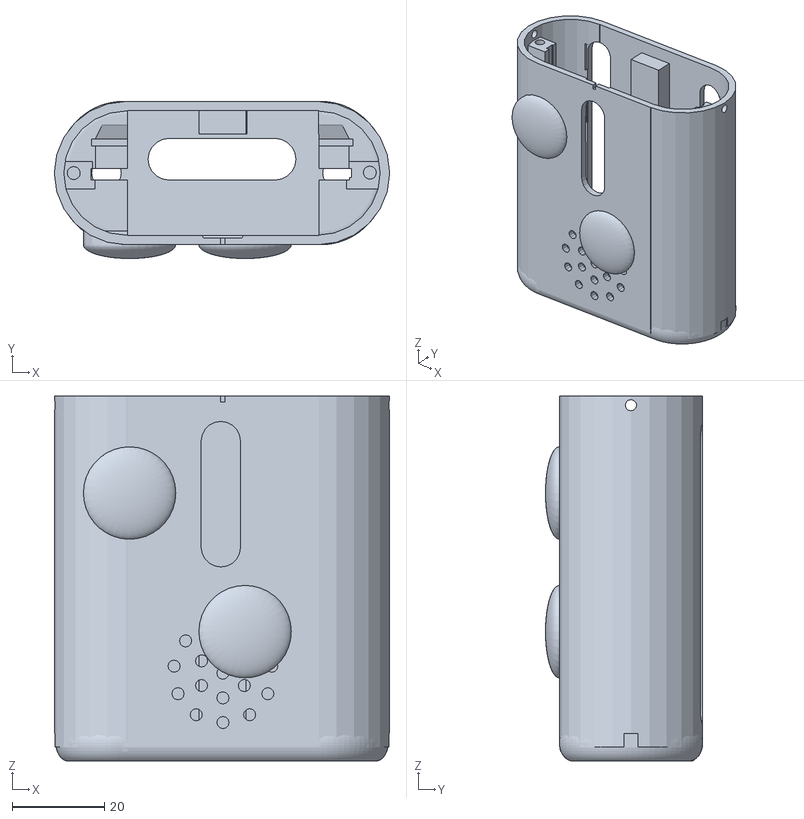
[picture p47: CAD file, 2019-05-09]
afuue_project/Model3D/WindSynth4/WindSynth4Mini.stl
72.6 x 34.0 x 79.0
