otoone-dev/docs/afuue_project/Model3D/WindSynth5/mouthpiece.stl

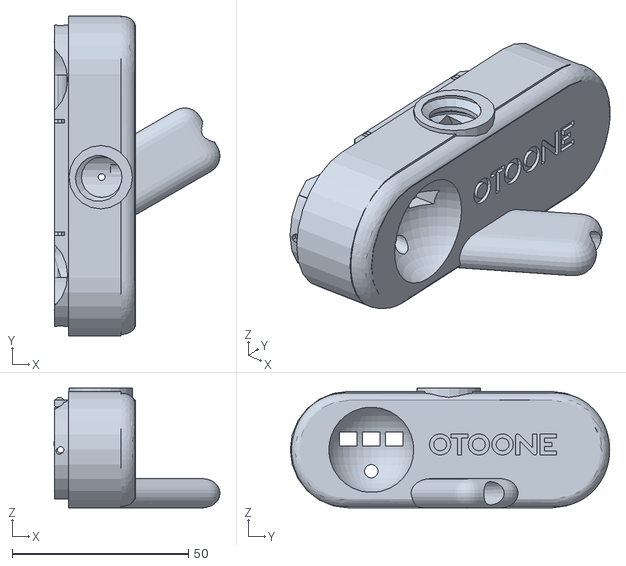
[picture p48: CAD file, 2021-03-27]
afuue_project/Model3D/WindSynth5/mouthpiece.stl
47.1 x 90.7 x 34.0
