otoone-dev/docs/afuue_project/Model3D/windsynth5_ver1.3/WindSynth5_bd.stl

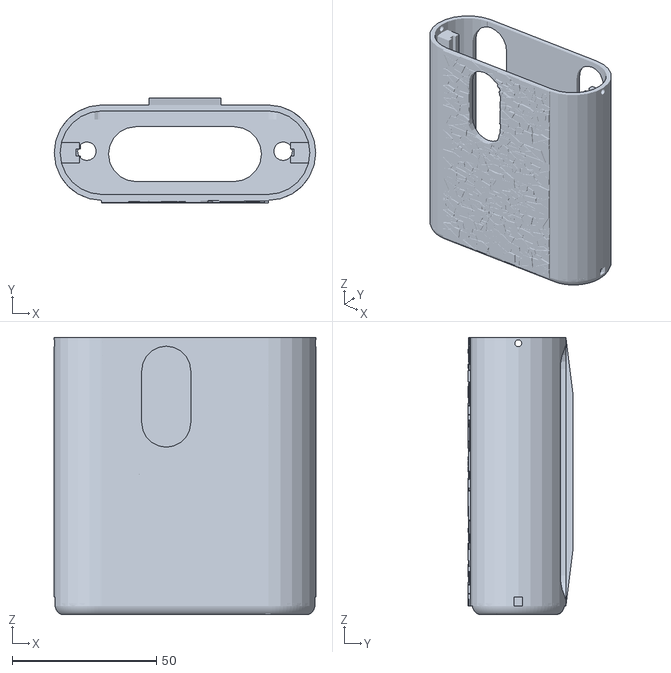
[picture p49: CAD file, 2021-03-27]
afuue_project/Model3D/windsynth5_ver1.3/WindSynth5_bd.stl
90.7 x 36.5 x 96.0
