otoone-dev/docs/afuue_project/Model3D/WindSynth6/front_face.stl

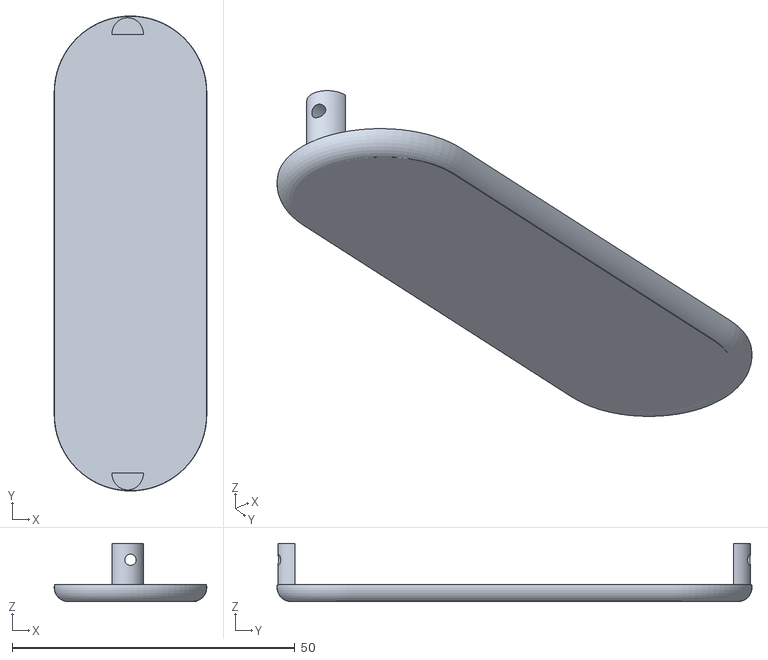
[picture p50: CAD file, 2021-05-11]
afuue_project/Model3D/WindSynth6/front_face.stl
27.0 x 84.0 x 10.3
