otoone-dev/docs/afuue_project/Model3D/WindSynth9/Afuue9_face.stl

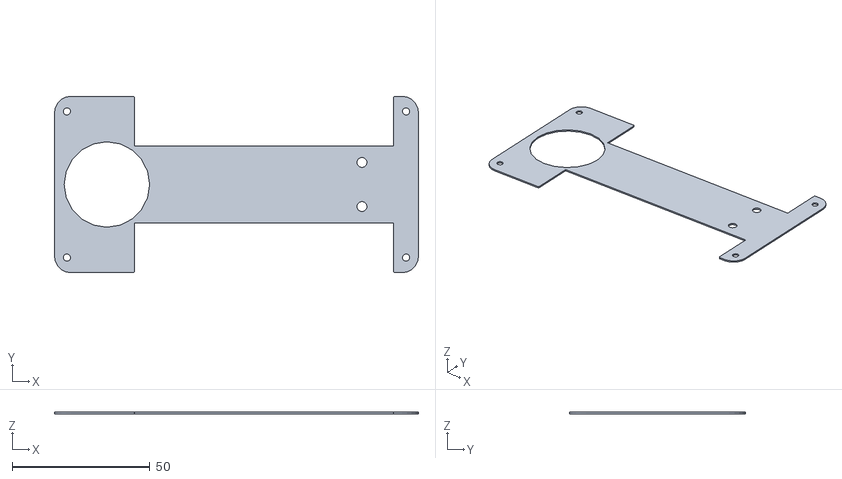
[picture p51: CAD file, 2022-12-07]
afuue_project/Model3D/WindSynth9/Afuue9_face.stl
132.0 x 64.0 x 0.597
