otoone-dev/docs/afuue_project/Model3D/WindSynth4/WindSynth4_Opt1.stl

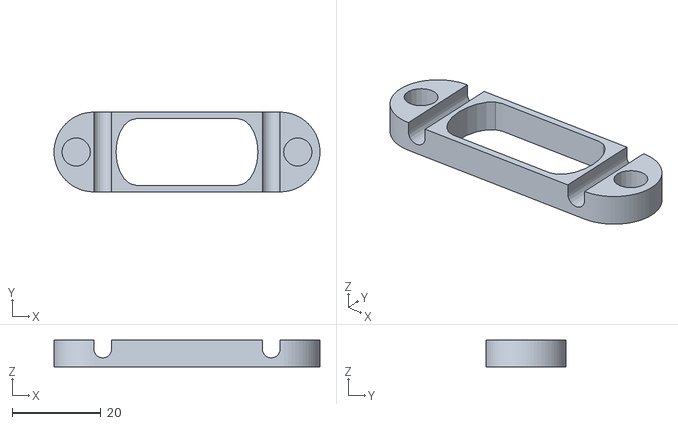
[picture p52: CAD file, 2019-05-09]
afuue_project/Model3D/WindSynth4/WindSynth4_Opt1.stl
60.0 x 18.0 x 6.00
