otoone-dev/docs/afuue_project/Model3D/WindSynth4Body.stl

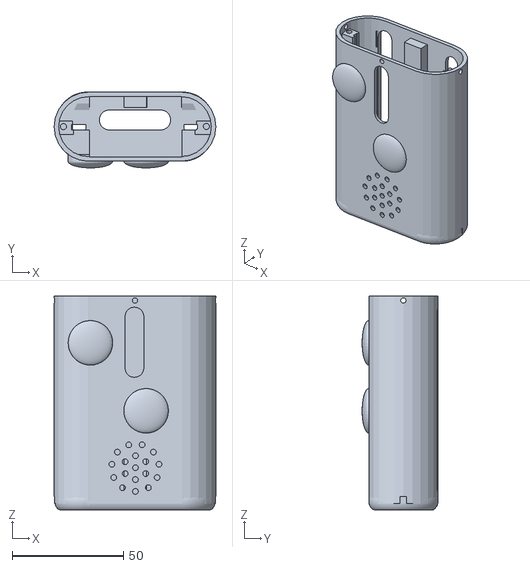
[picture p53: CAD file, 2019-05-09]
afuue_project/Model3D/WindSynth4Body.stl
72.6 x 34.0 x 96.0
