otoone-dev/docs/afuue_project/Model3D/WindSynth5/keys_silencer.stl

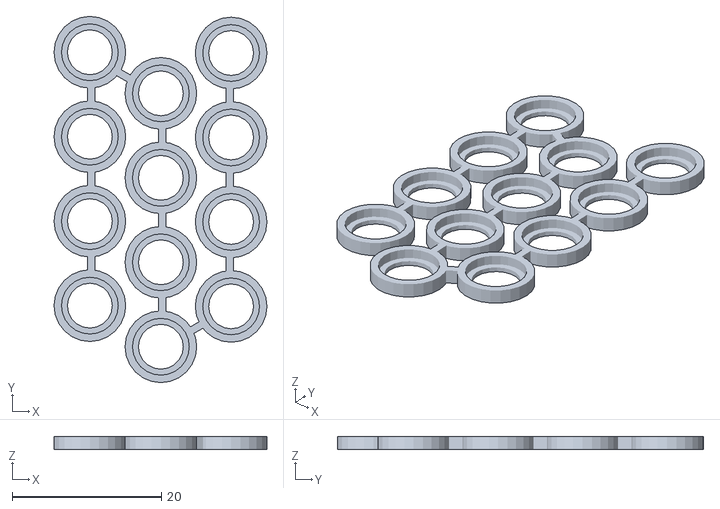
[picture p54: CAD file, 2020-10-23]
afuue_project/Model3D/WindSynth5/keys_silencer.stl
28.5 x 49.0 x 1.80
