otoone-dev/docs/afuue_project/Model3D/windsynth5_ver1.3/WindSynth5Keys.stl

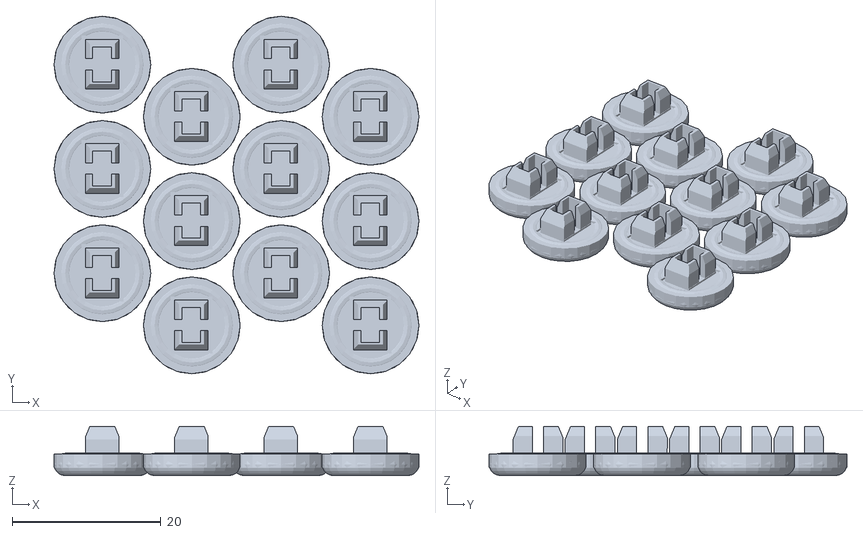
[picture p55: CAD file, 2021-03-27]
afuue_project/Model3D/windsynth5_ver1.3/WindSynth5Keys.stl
49.0 x 48.0 x 6.60
