otoone-dev/docs/afuue_project/Model3D/WindSynth6/board.stl

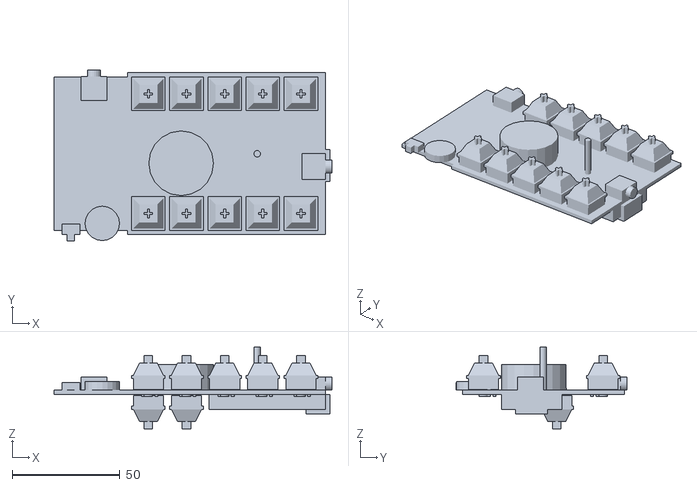
[picture p56: CAD file, 2021-03-27]
afuue_project/Model3D/WindSynth6/board.stl
129.0 x 79.2 x 38.0
