otoone-dev/docs/afuue_project/Model3D/WindSynth9/Afuue9_tubecover.stl

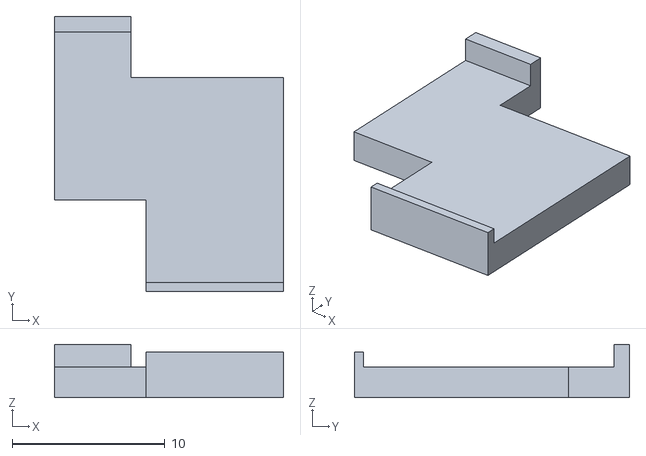
[picture p57: CAD file, 2022-12-07]
afuue_project/Model3D/WindSynth9/Afuue9_tubecover.stl
15.0 x 18.0 x 3.50
