otoone-dev/docs/afuue_project/Model3D/WindSynth4/WindSynth4Mouth.stl

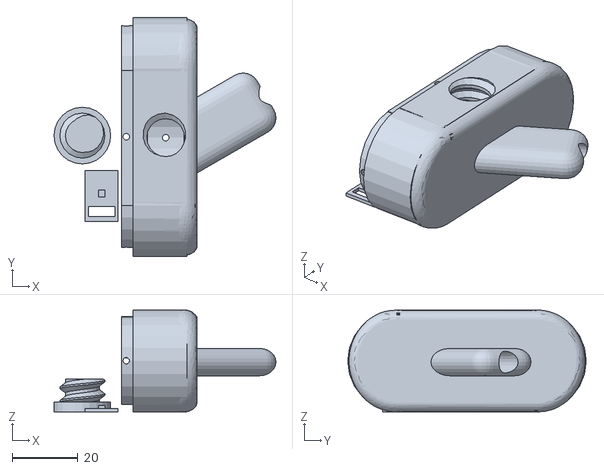
[picture p58: CAD file, 2019-05-09]
afuue_project/Model3D/WindSynth4/WindSynth4Mouth.stl
67.6 x 72.6 x 31.0
