otoone-dev/docs/afuue_project/Model3D/WindSynth4Keys.stl

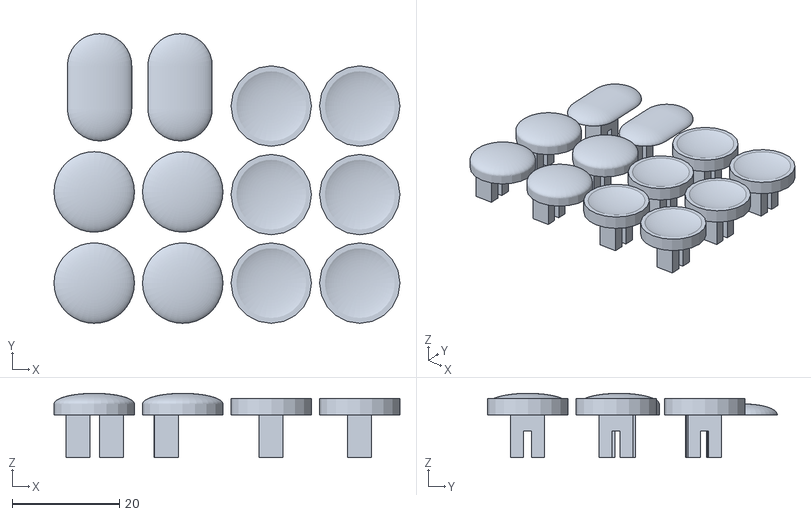
[picture p59: CAD file, 2019-05-09]
afuue_project/Model3D/WindSynth4Keys.stl
64.5 x 54.0 x 12.0
