otoone-dev/docs/afuue_project/Model3D/WindSynth5/mouthpiece_w.stl

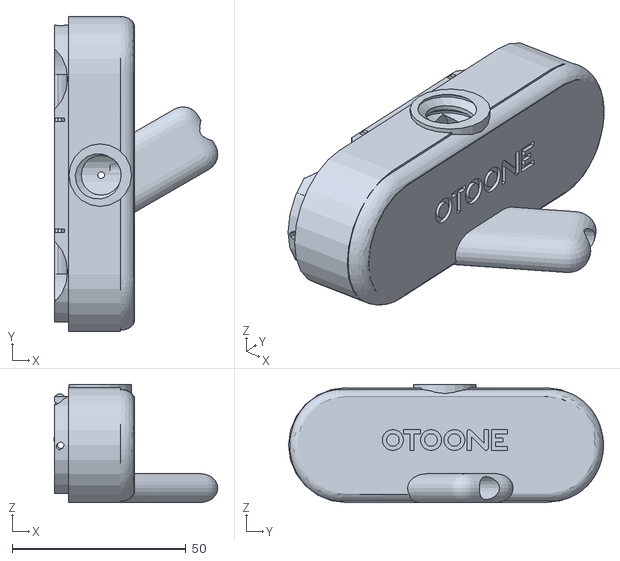
[picture p60: CAD file, 2020-10-08]
afuue_project/Model3D/WindSynth5/mouthpiece_w.stl
47.1 x 90.7 x 34.0
