otoone-dev/docs/afuue_project/Model3D/windsynth5_ver1.3/WindSynth5_mp.stl

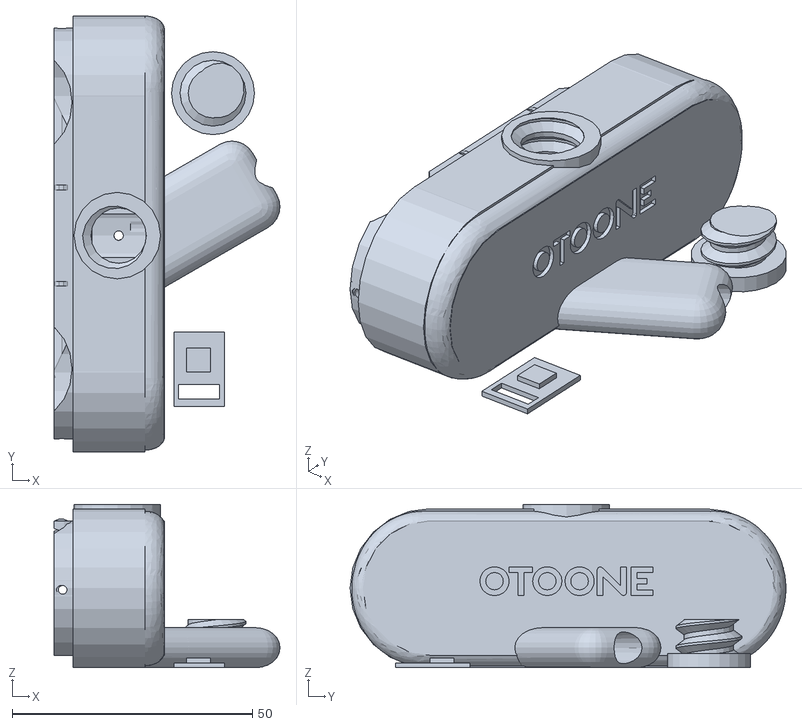
[picture p61: CAD file, 2021-03-27]
afuue_project/Model3D/windsynth5_ver1.3/WindSynth5_mp.stl
47.0 x 90.7 x 34.0
