otoone-dev/docs/afuue_project/Model3D/WindSynth6/body.stl

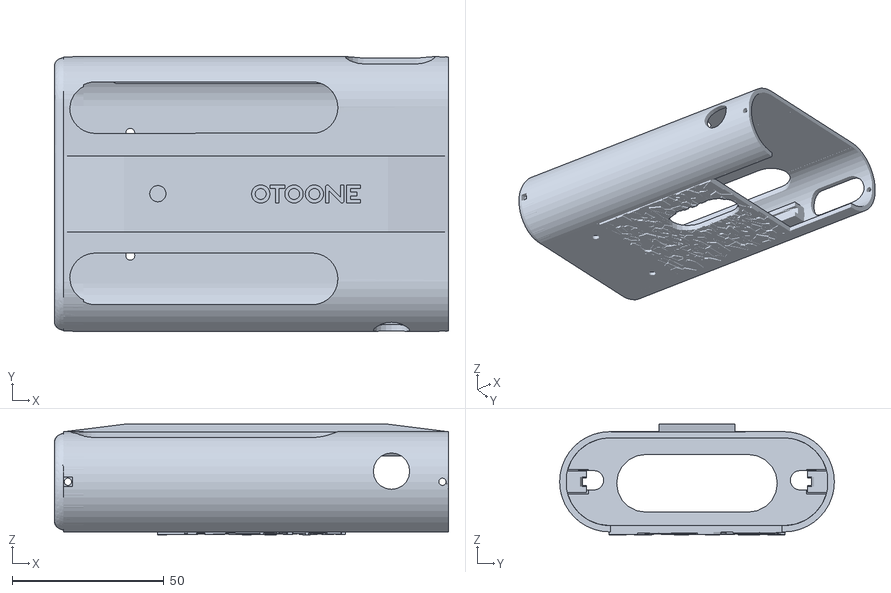
[picture p62: CAD file, 2021-03-27]
afuue_project/Model3D/WindSynth6/body.stl
130.0 x 90.7 x 36.5
