otoone-dev/docs/afuue_project/Model3D/WindSynth9/Afuue9_body.stl

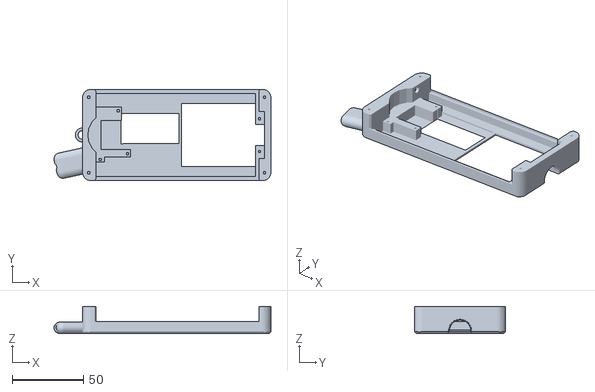
[picture p63: CAD file, 2022-12-07]
afuue_project/Model3D/WindSynth9/Afuue9_body.stl
151.9 x 64.0 x 19.0
