otoone-dev/docs/afuue_project/Model3D/WindSynth5/DisplayBase.stl

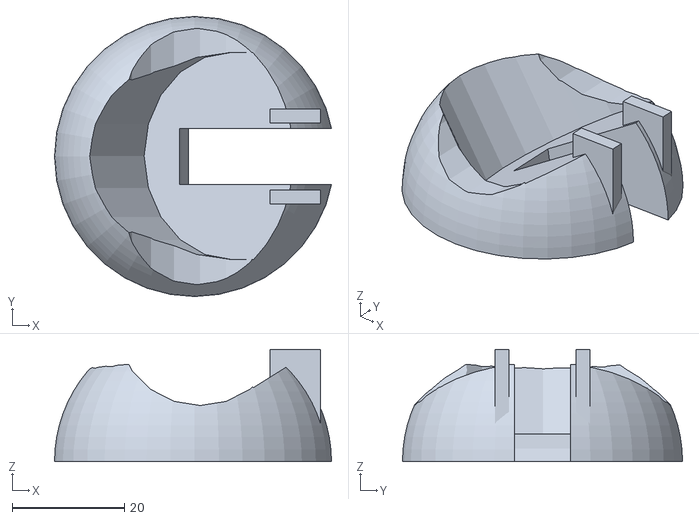
[picture p64: CAD file, 2020-10-08]
afuue_project/Model3D/WindSynth5/DisplayBase.stl
49.4 x 50.0 x 20.0
