otoone-dev/docs/afuue_project/Model3D/windsynth5_ver1.3/WindSynth5.stl

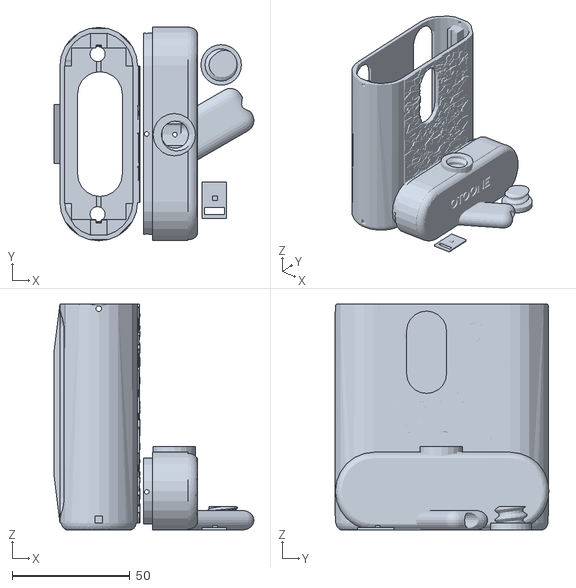
[picture p65: CAD file, 2020-06-01]
afuue_project/Model3D/windsynth5_ver1.3/WindSynth5.stl
84.9 x 90.8 x 96.0
