otoone-dev/docs/afuue_project/Model3D/WindSynth6/led_base.stl

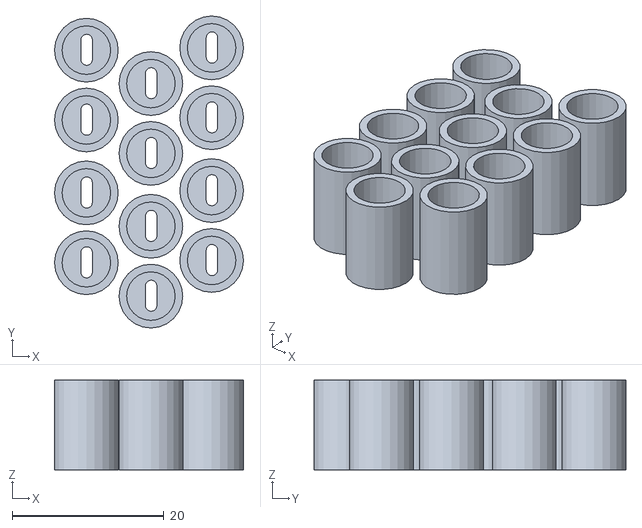
[picture p66: CAD file, 2021-03-27]
afuue_project/Model3D/WindSynth6/led_base.stl
24.9 x 41.1 x 11.8
