otoone-dev/docs/afuue_project/Model3D/WindSynth5/key_tpu_1.stl

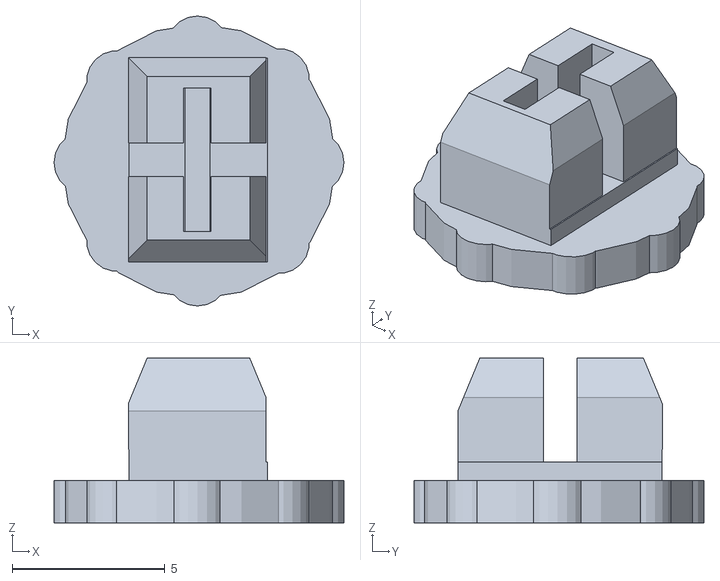
[picture p67: CAD file, 2020-09-05]
afuue_project/Model3D/WindSynth5/key_tpu_1.stl
9.50 x 9.50 x 5.40
