otoone-dev/docs/afuue_project/Model3D/WindSynth6/led_cover.stl

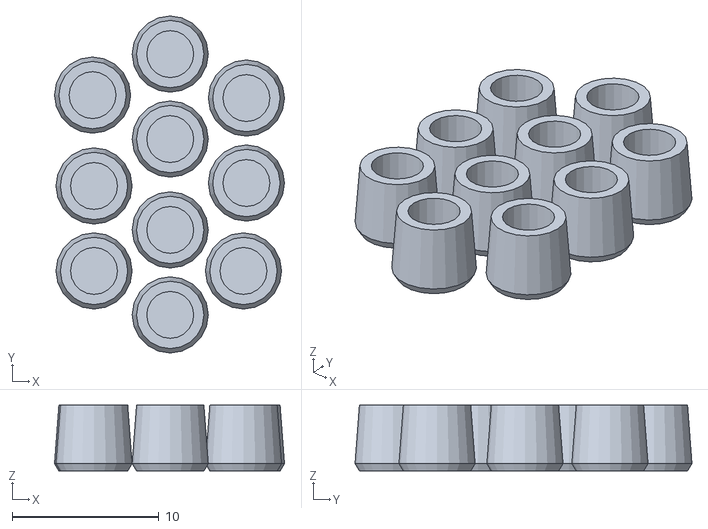
[picture p68: CAD file, 2021-03-27]
afuue_project/Model3D/WindSynth6/led_cover.stl
15.7 x 23.0 x 4.50
