otoone-dev/docs/afuue_project/Model3D/WindSynth5/mp_holecap_h4.stl

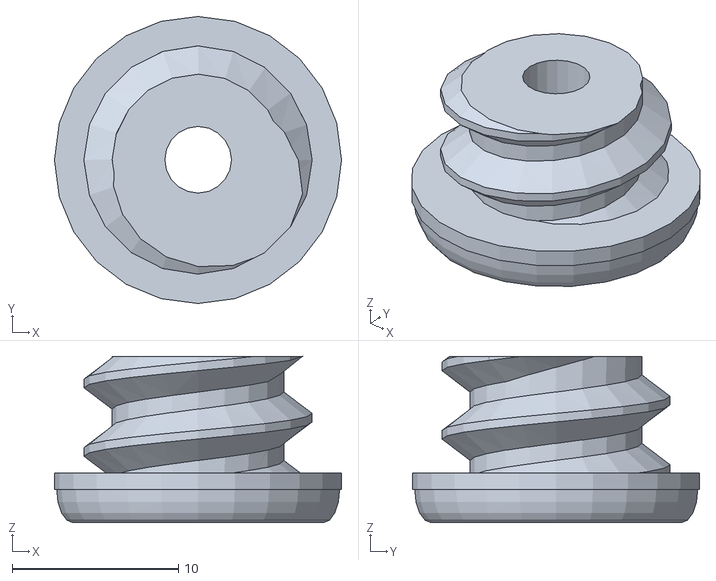
[picture p69: CAD file, 2020-08-12]
afuue_project/Model3D/WindSynth5/mp_holecap_h4.stl
17.3 x 17.2 x 10.00
