otoone-dev/docs/afuue_project/Model3D/WindSynth6/mouthpiece.stl

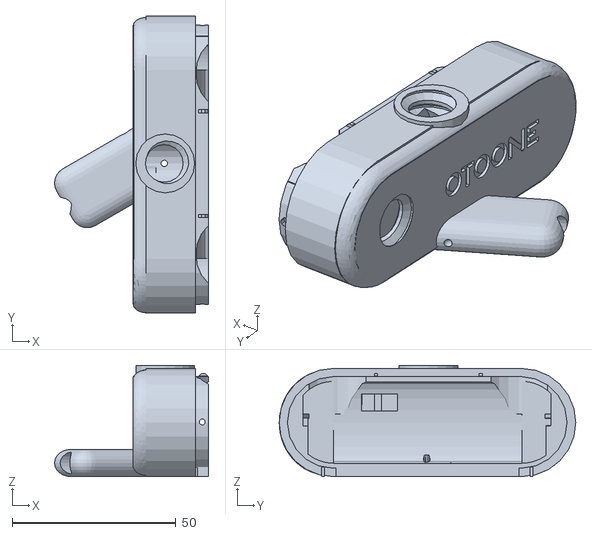
[picture p70: CAD file, 2021-03-27]
afuue_project/Model3D/WindSynth6/mouthpiece.stl
47.1 x 90.7 x 34.0
