otoone-dev/docs/afuue_project/Model3D/WindSynth6/keys_resin_base.stl

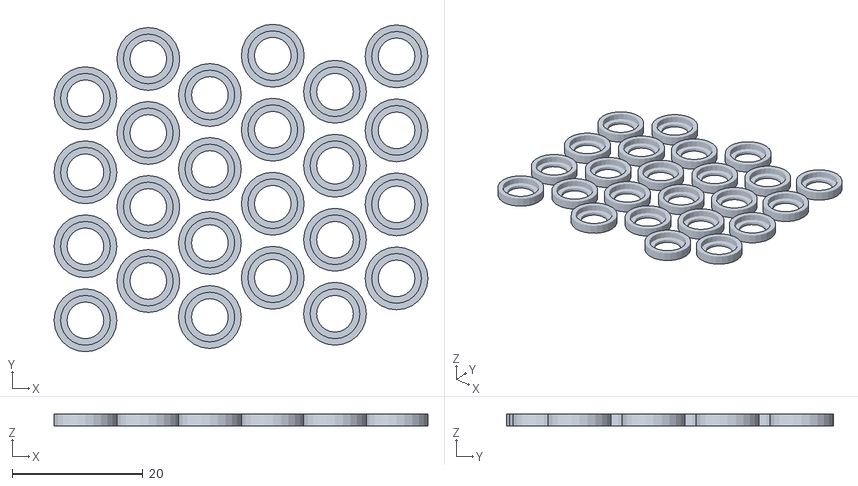
[picture p71: CAD file, 2020-10-23]
afuue_project/Model3D/WindSynth6/keys_resin_base.stl
57.1 x 50.0 x 1.80
