otoone-dev/docs/afuue_project/Model3D/WindSynth6/keys_resin_cover.stl

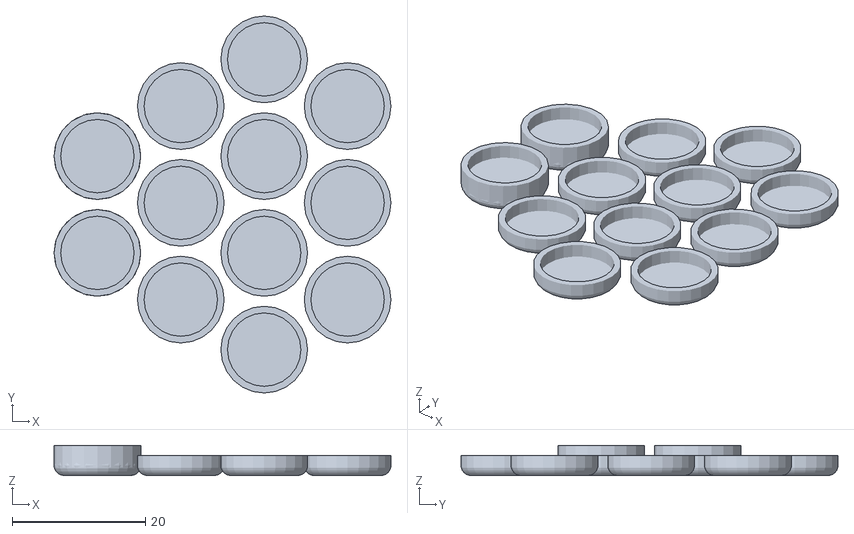
[picture p72: CAD file, 2020-10-23]
afuue_project/Model3D/WindSynth6/keys_resin_cover.stl
50.5 x 56.5 x 4.50
