otoone-dev/docs/afuue_project/Model3D/WindSynth5/keys_tpu.stl

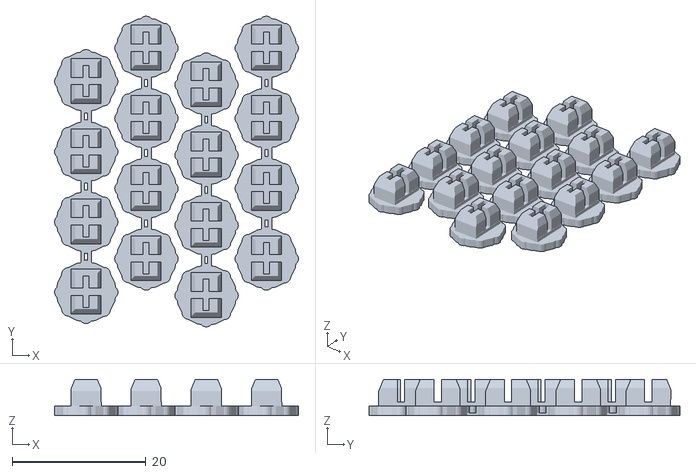
[picture p73: CAD file, 2020-08-05]
afuue_project/Model3D/WindSynth5/keys_tpu.stl
36.5 x 46.5 x 5.40
