otoone-dev/docs/afuue_project/Model3D/WindSynth6/keys_resin.stl

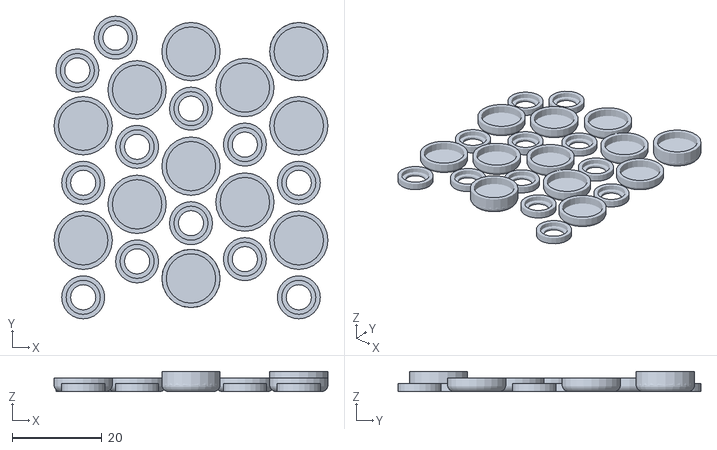
[picture p74: CAD file, 2020-10-08]
afuue_project/Model3D/WindSynth6/keys_resin.stl
61.0 x 67.4 x 4.50
