otoone-dev/docs/afuue_project/Model3D/WindSynth5/mp_cover.stl

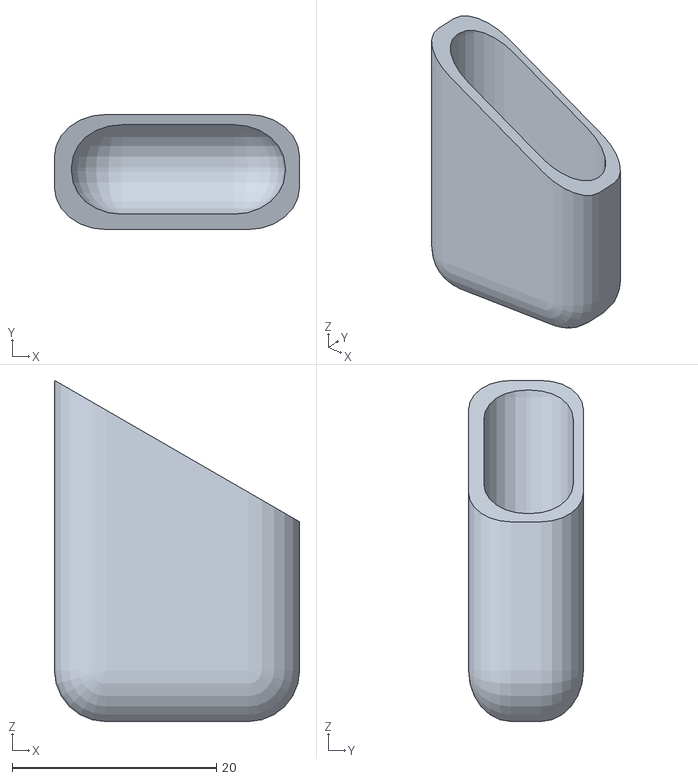
[picture p75: CAD file, 2020-08-05]
afuue_project/Model3D/WindSynth5/mp_cover.stl
24.0 x 11.2 x 33.4
