otoone-dev/docs/afuue_project/Model3D/WindSynth6/mp_holecap.stl

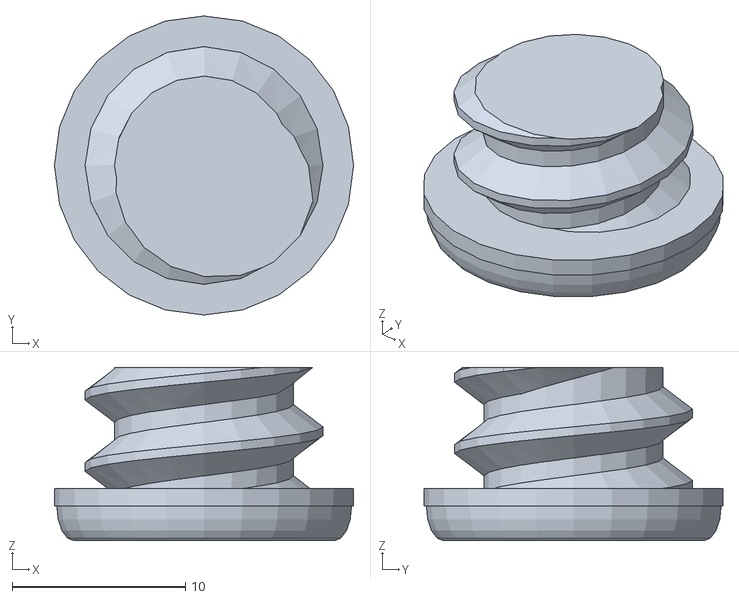
[picture p76: CAD file, 2020-08-18]
afuue_project/Model3D/WindSynth6/mp_holecap.stl
17.3 x 17.2 x 10.00
