otoone-dev/docs/afuue_project/Model3D/WindSynth5/keys.stl

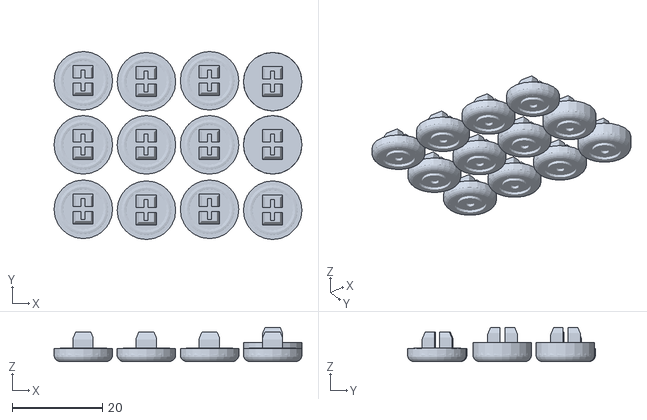
[picture p77: CAD file, 2020-08-05]
afuue_project/Model3D/WindSynth5/keys.stl
55.0 x 41.7 x 7.60
