otoone-dev/docs/afuue_project/Model3D/WindSynth5/keys_pla.stl

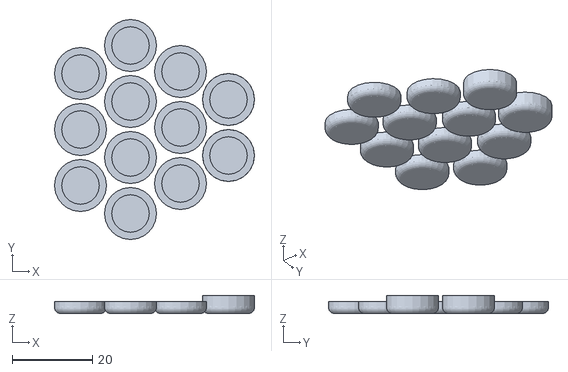
[picture p78: CAD file, 2020-08-05]
afuue_project/Model3D/WindSynth5/keys_pla.stl
50.0 x 55.0 x 4.50
