otoone-dev/docs/afuue_project/Model3D/WindSynth5/WindSynth5_mpcv.stl

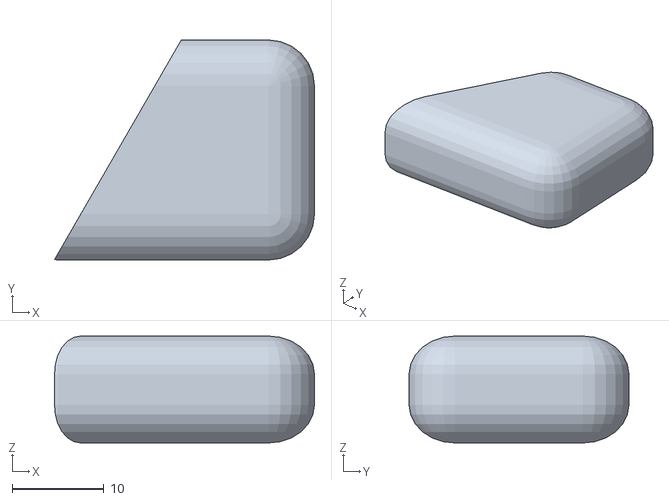
[picture p79: CAD file, 2020-06-01]
afuue_project/Model3D/WindSynth5/WindSynth5_mpcv.stl
28.4 x 24.0 x 11.7
