otoone-dev/docs/afuue_project/Model3D/WindSynth5/WindSynth5Keys.stl

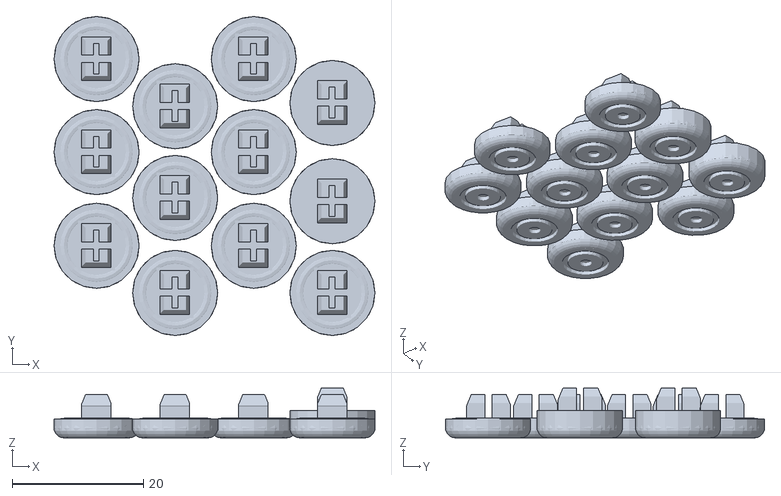
[picture p80: CAD file, 2020-06-01]
afuue_project/Model3D/WindSynth5/WindSynth5Keys.stl
49.0 x 48.7 x 7.60
