otoone-dev/docs/(list of files, cad)

Other CAD files:
afuue_project/Model3D/WindSynth5/mp_holecap_h2.stl
afuue_project/Model3D/WindSynth5/mp_holecap_h3.stl
afuue_project/Model3D/WindSynth5/body.stl
afuue_project/Model3D/WindSynth5/WindSynth5_mp.stl
afuue_project/Model3D/WindSynth5/WindSynth5_bd.stl
