otoone-dev/docs/afuue_project/Manual/Instructions.odt

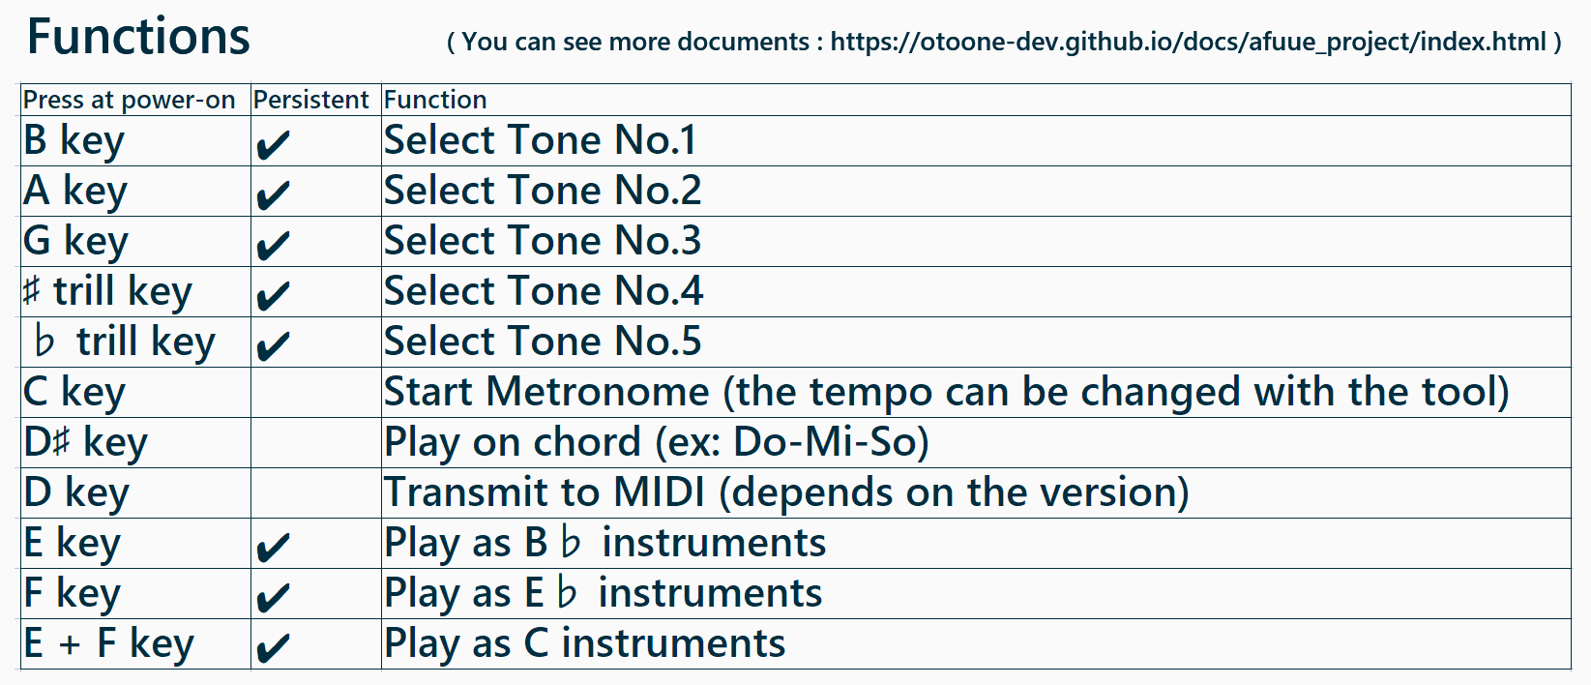
[picture p81: figure]

OctDown: minor, OctUp:dim, Up+Down:sus4
