otoone-dev/docs/afuue_project/Manual/Functions.ods

Press at power-on | Persistent | Function
B key | ✔ | Select Tone No.1
A key | ✔ | Select Tone No.2
G key | ✔ | Select Tone No.3
♯ trill key | ✔ | Select Tone No.4
♭ trill key | ✔ | Select Tone No.5
C key |  | Start Metronome (the tempo can be changed with the tool)
D♯ key |  | Play on chord (ex: Do-Mi-So)
D key |  | Transmit to MIDI (depends on the version)
E key | ✔ | Play as B♭ instruments
F key | ✔ | Play as E♭ instruments
E + F key | ✔ | Play as C instruments
