otoone-dev/docs/afuue_project/Manual/v6/afuue_assemble.pdf

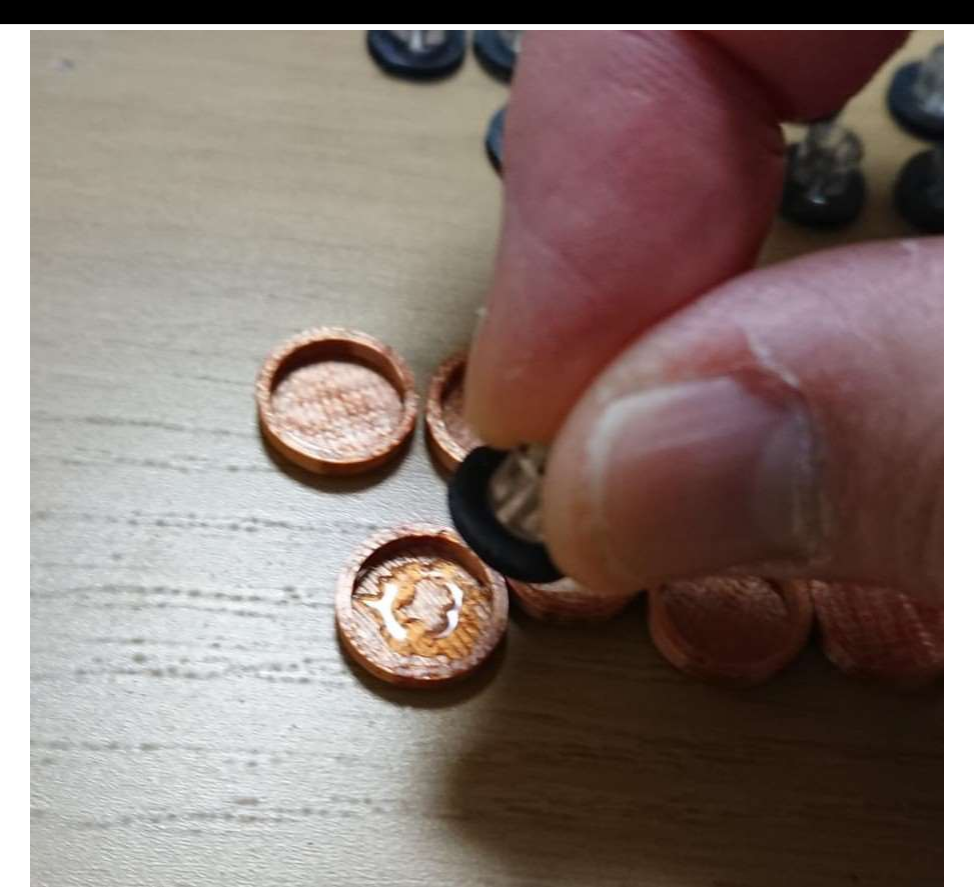
[picture p83: figure]
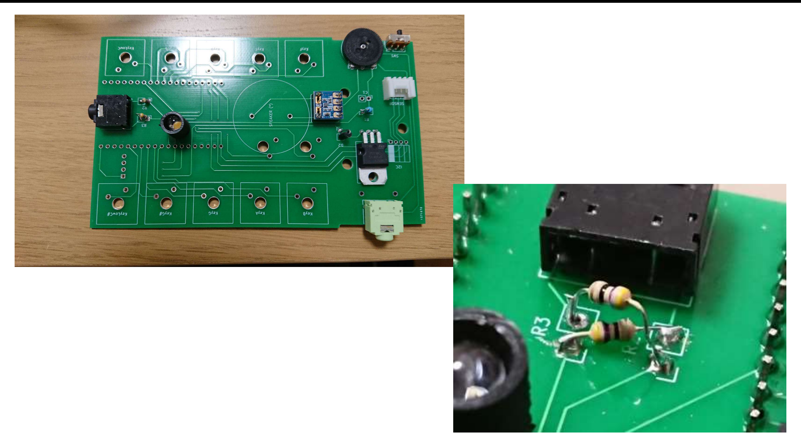
[picture p84: figure]
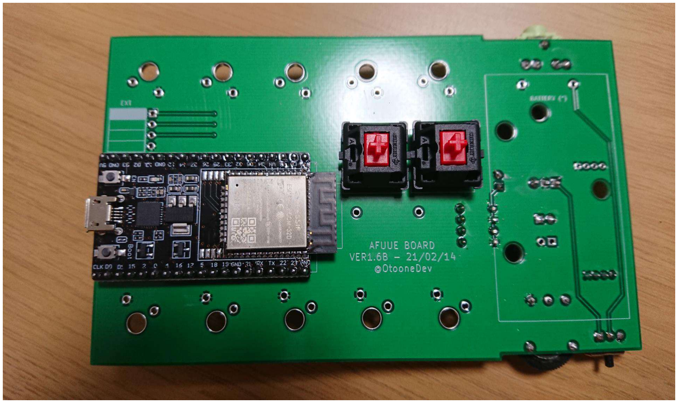
[picture p85: figure]
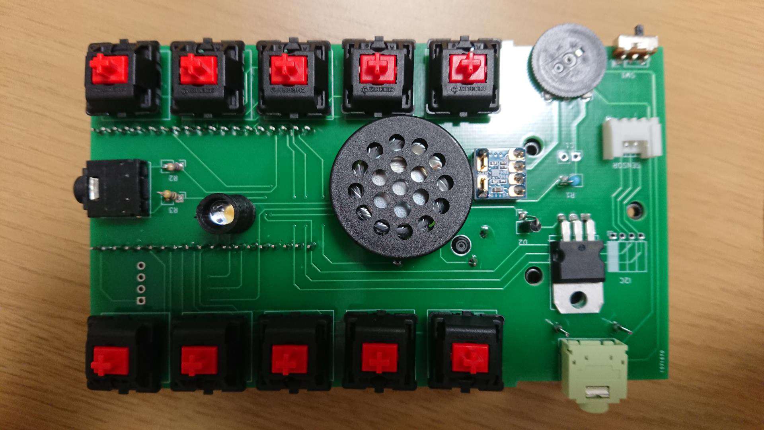
[picture p86: figure]

キーを接着剤で接合します | つづいて裏面を実装します。 | 表面の残りの部品を実装します。
マウスピースに BMP180 センサーを写真の向きで 挿入します。 | グルーガンなどで隙間を 埋めます。 | 基板をボディに挿入します。 | 途中でマウスピースのコネクタを 接続します。余ったケーブルは曲げたり 巻いたりして、うまく収めます。 | M2ネジでボディとマウスピースを 固定します。

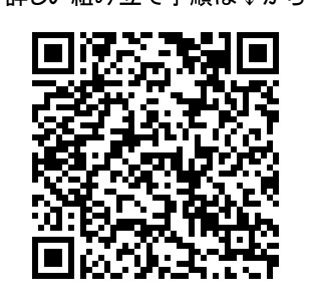
[picture p87: figure]

| | | | 詳しい組み立て手順は↓から

AFUUE 組み立て手順（簡易版）
詳しい組み立て方は https://otoonedev.wixsite.com/afuue　から「組み立て手順」を参照してください。 右下の QR コードからでも組み立て手順ページにジャンプできます。

LEDはLEDベースに差し、
黒いコネクタ側が長い足に
なるような向きで取付けます

最初に表面でキースイッチを除く
(*) のついてない部品のみを実装
します。Ver1.6B 基板では回路にミスがあ
るため、右下写真のように 47Ω抵抗を、クロ
スして取り付けてください。
LEDカバーをボディに入れ ます。固い場合は削って ください。緩い場合は接着剤 などを使ってください。 | キー（厚みのない方）を 10 個 表面側にはめ込みます。 やや固いですが、グッと押し 込んでください。 | キー（厚みのある方）を 2 個、 裏面側にはめ込みます。 | マウスピースのホールキャップを 写真の位置に取り付ければ完成です。 電池を入れて電源スイッチを ON に して吹いてください。
