otoone-dev/docs/afuue_project/Manual/v6/afuue_manual.pdf

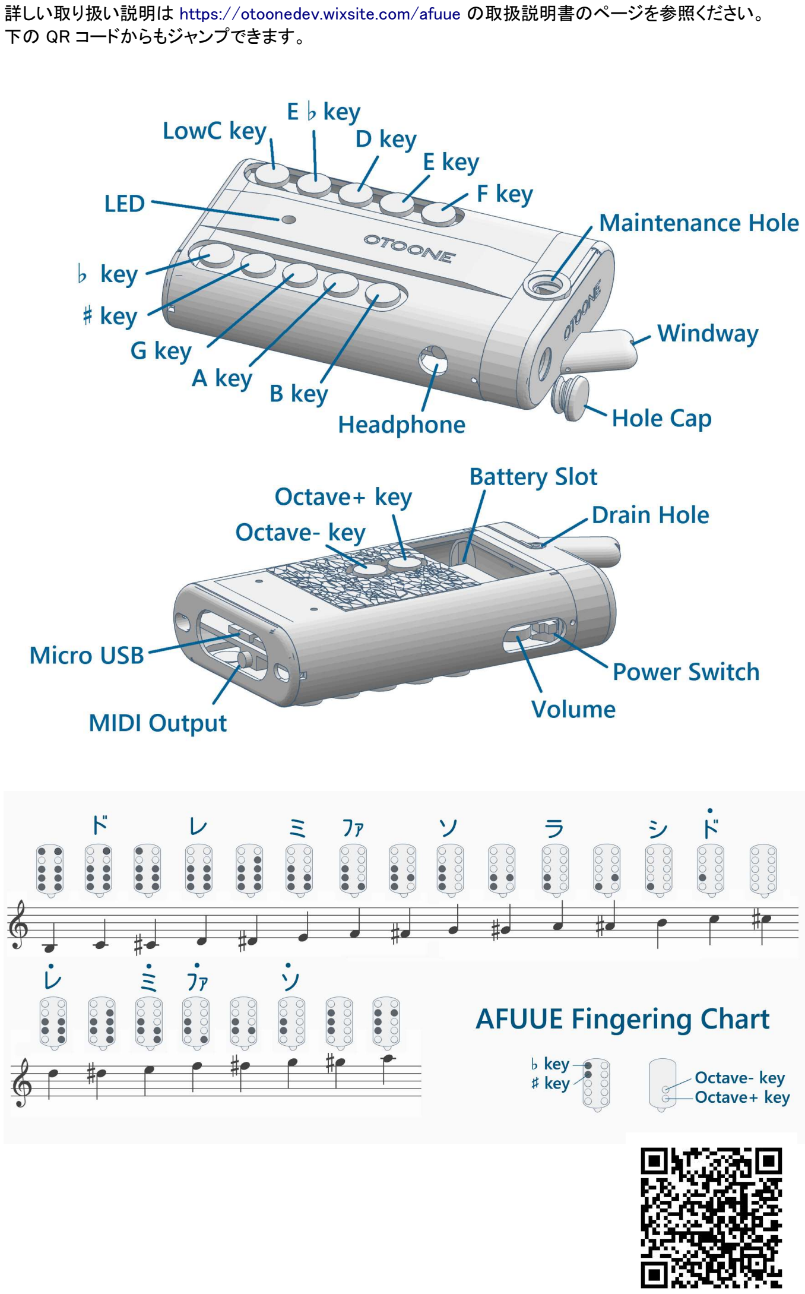
[picture p92: page 1]

詳しい取り扱い説明は https://otoonedev.wixsite.com/afuue の取扱説明書のページを参照ください。 下の QR コードからもジャンプできます。
