otoone-dev/docs/afuue_project/Manual/fingering_jp.png

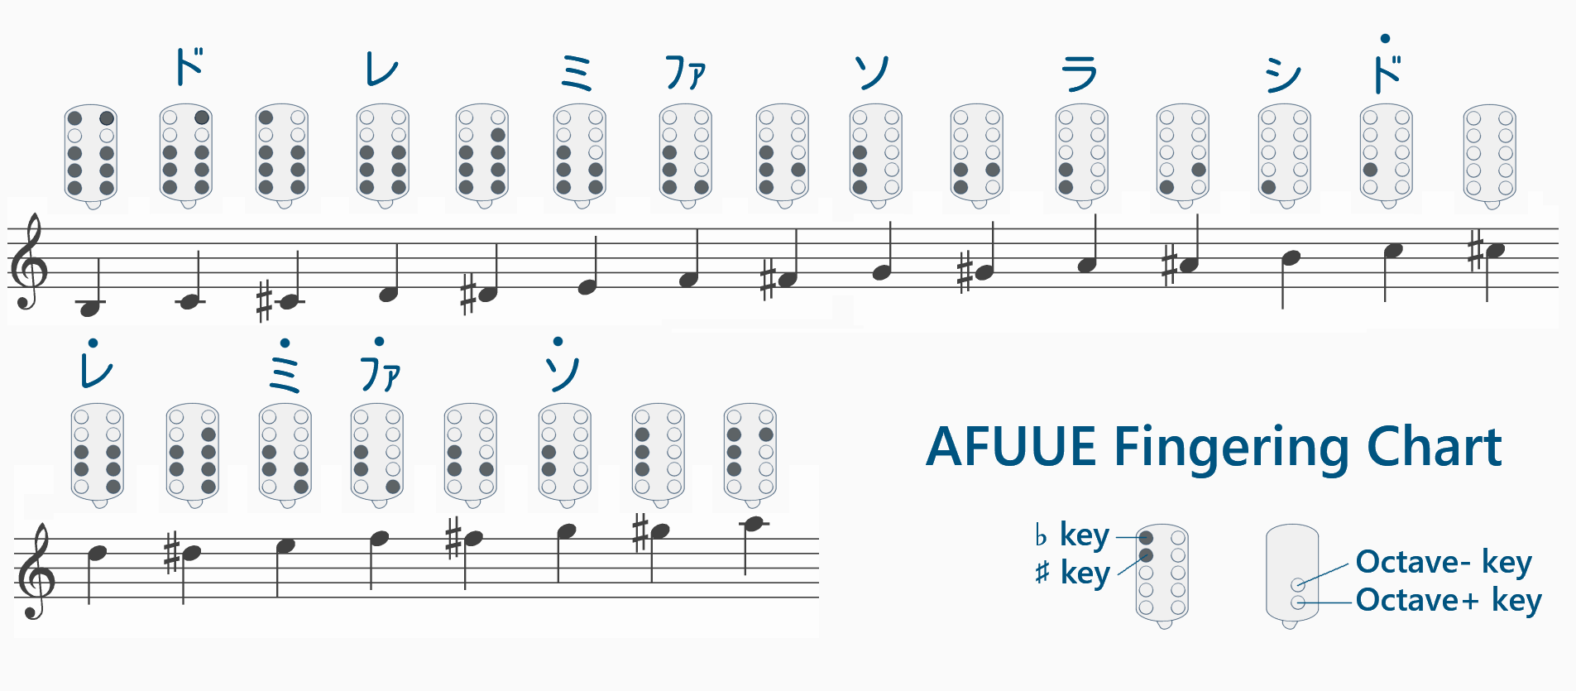
afuue_project/Manual/fingering_jp.png
