otoone-dev/docs/afuue_project/Manual/HowToHold1.png

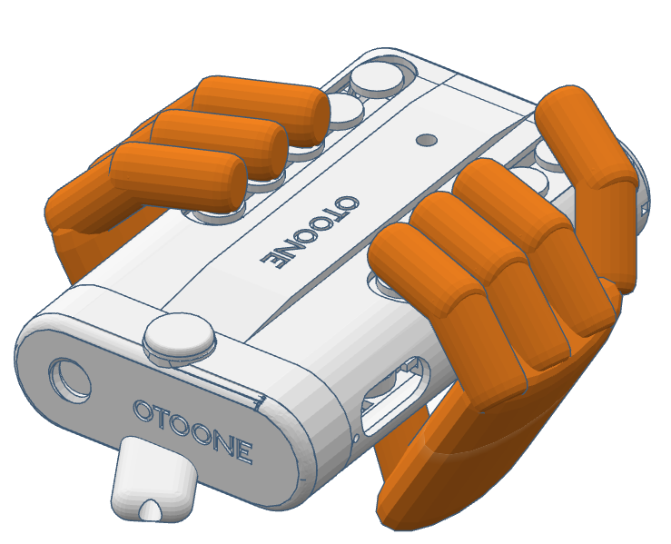
afuue_project/Manual/HowToHold1.png
