otoone-dev/docs/afuue_project/Manual/HowToHold2.png

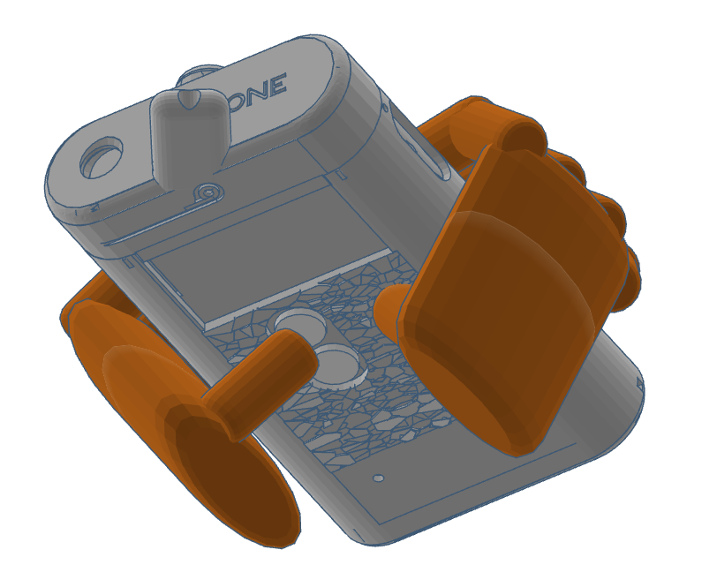
afuue_project/Manual/HowToHold2.png
