otoone-dev/docs/afuue_project/Manual/Pop1.png

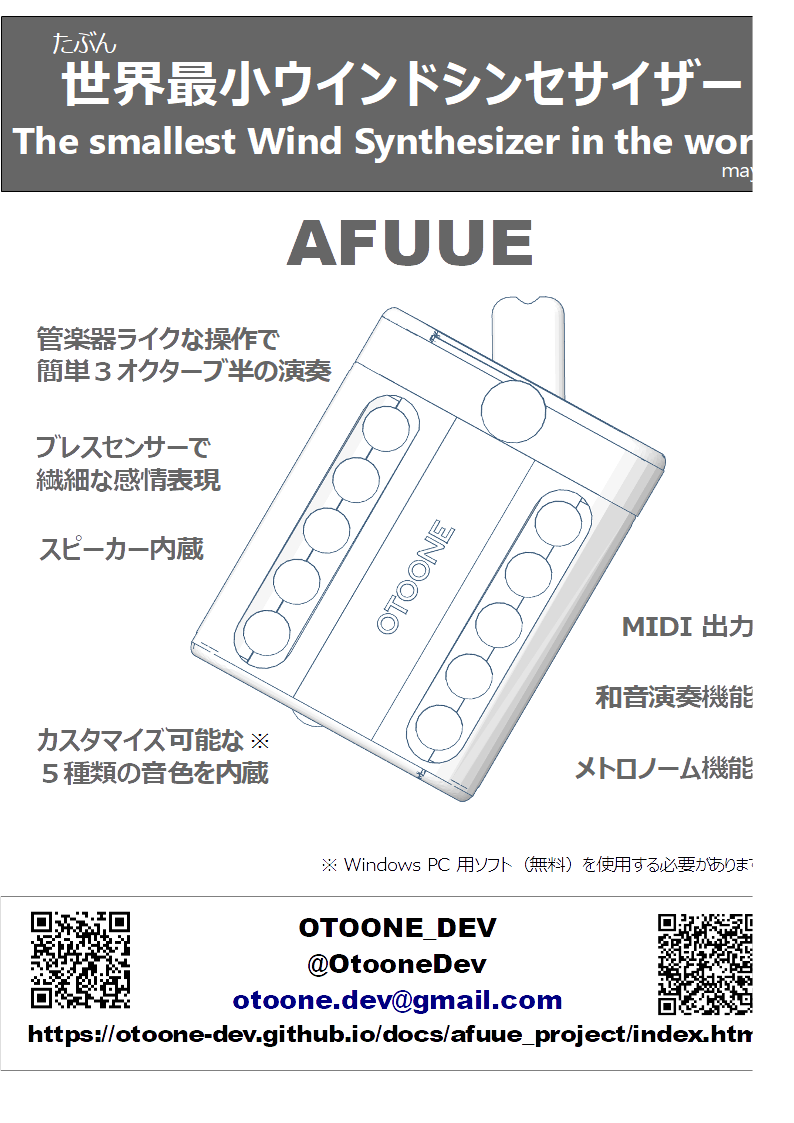
afuue_project/Manual/Pop1.png
