otoone-dev/docs/afuue_project/Manual/Pop2.png

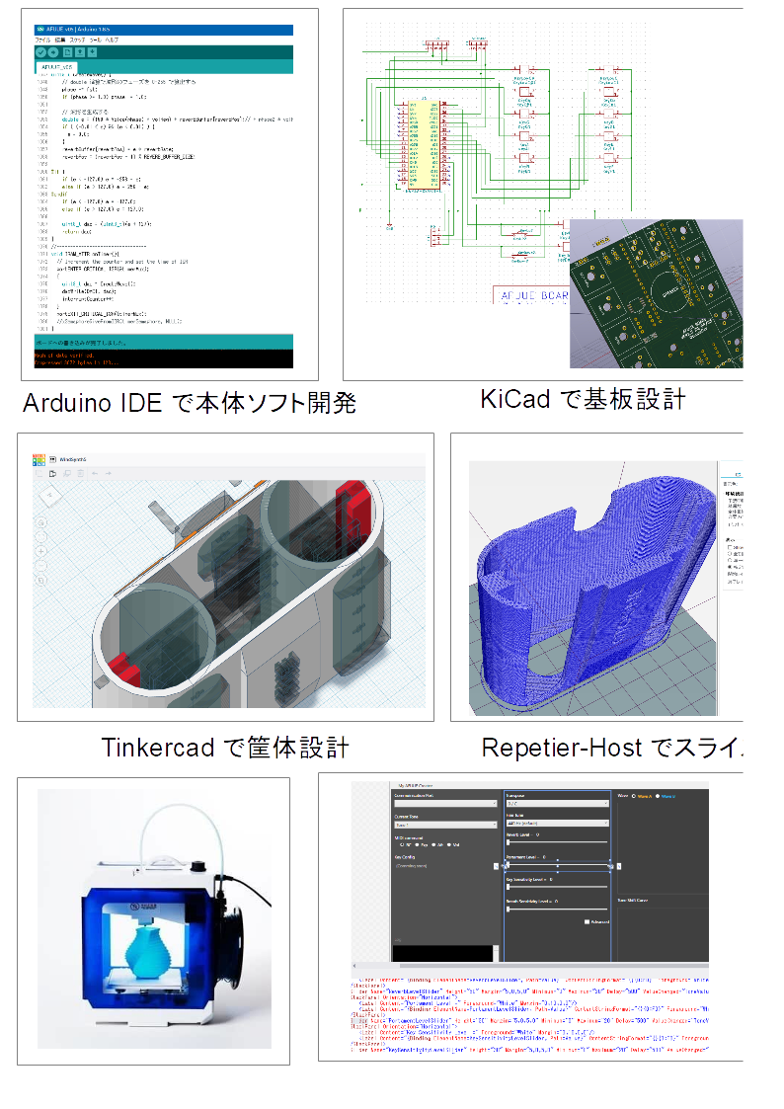
afuue_project/Manual/Pop2.png
