otoone-dev/docs/afuue_project/Manual/topview.png

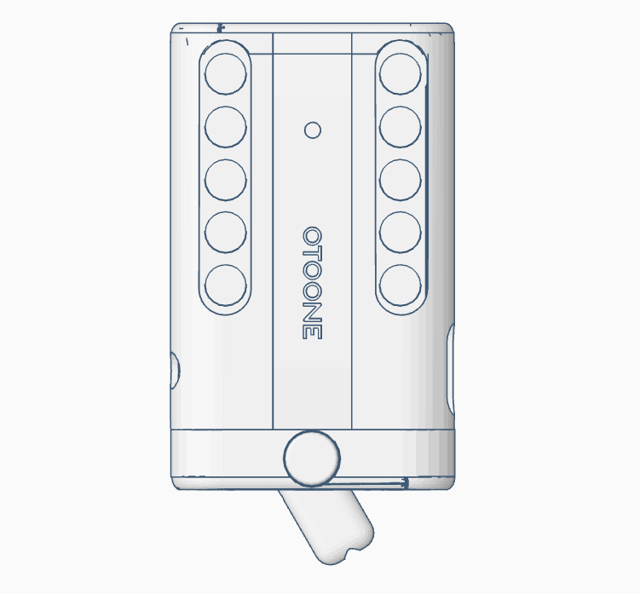
afuue_project/Manual/topview.png
