otoone-dev/docs/afuue_project/Manual/v10 gen2/afuue2r_lite.png

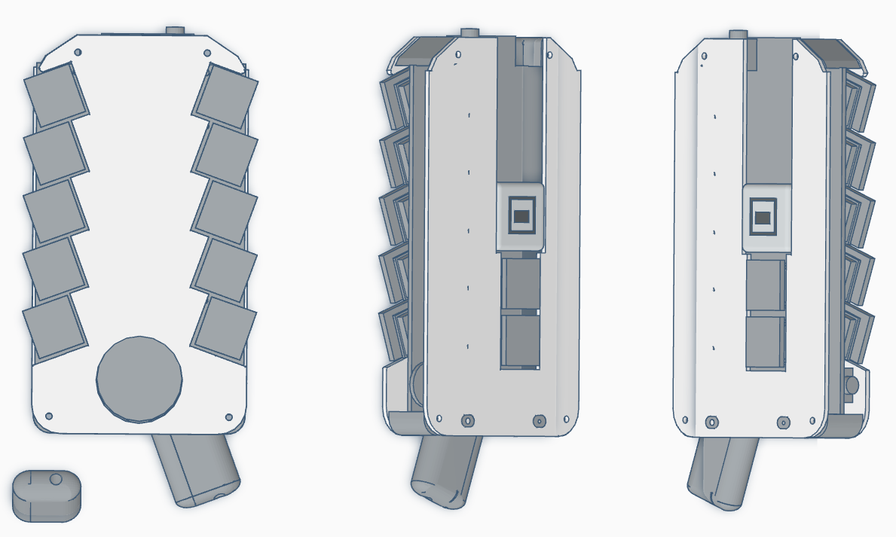
afuue_project/Manual/v10 gen2/afuue2r_lite.png
