otoone-dev/docs/afuue_project/Manual/v10 gen2/fingering.png

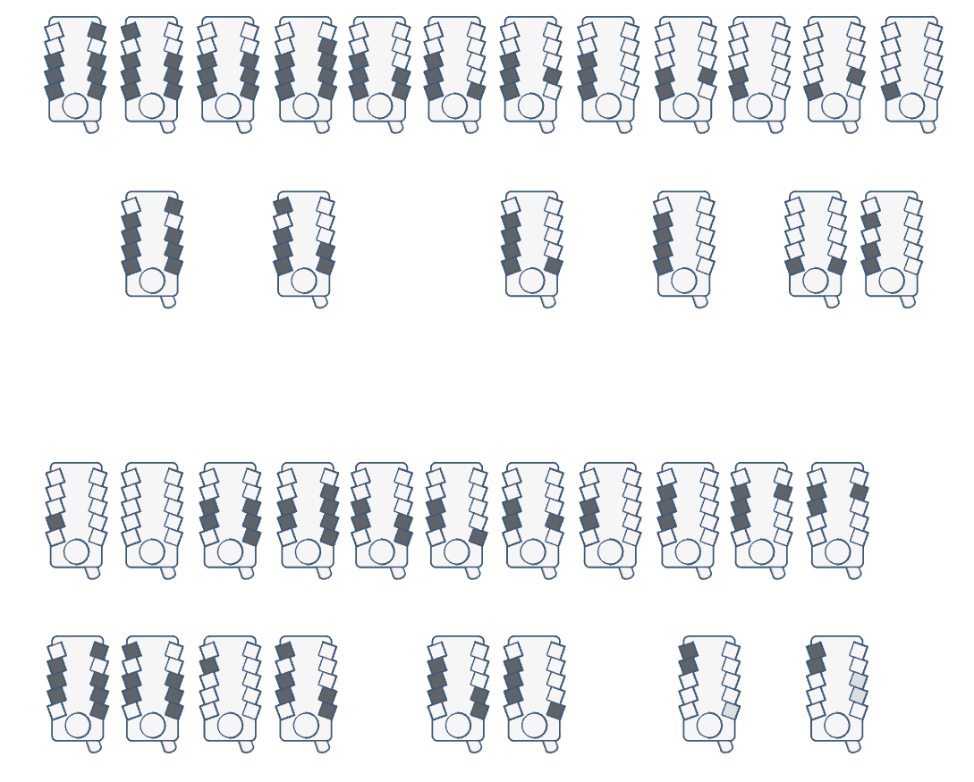
afuue_project/Manual/v10 gen2/fingering.png
