otoone-dev/docs/afuue_project/KiCad/windsynth9/windsynth/windsynth.kicad_pcb

## KiCad design afuue_project/KiCad/windsynth9/windsynth/windsynth.kicad_pcb (2023-07-13)

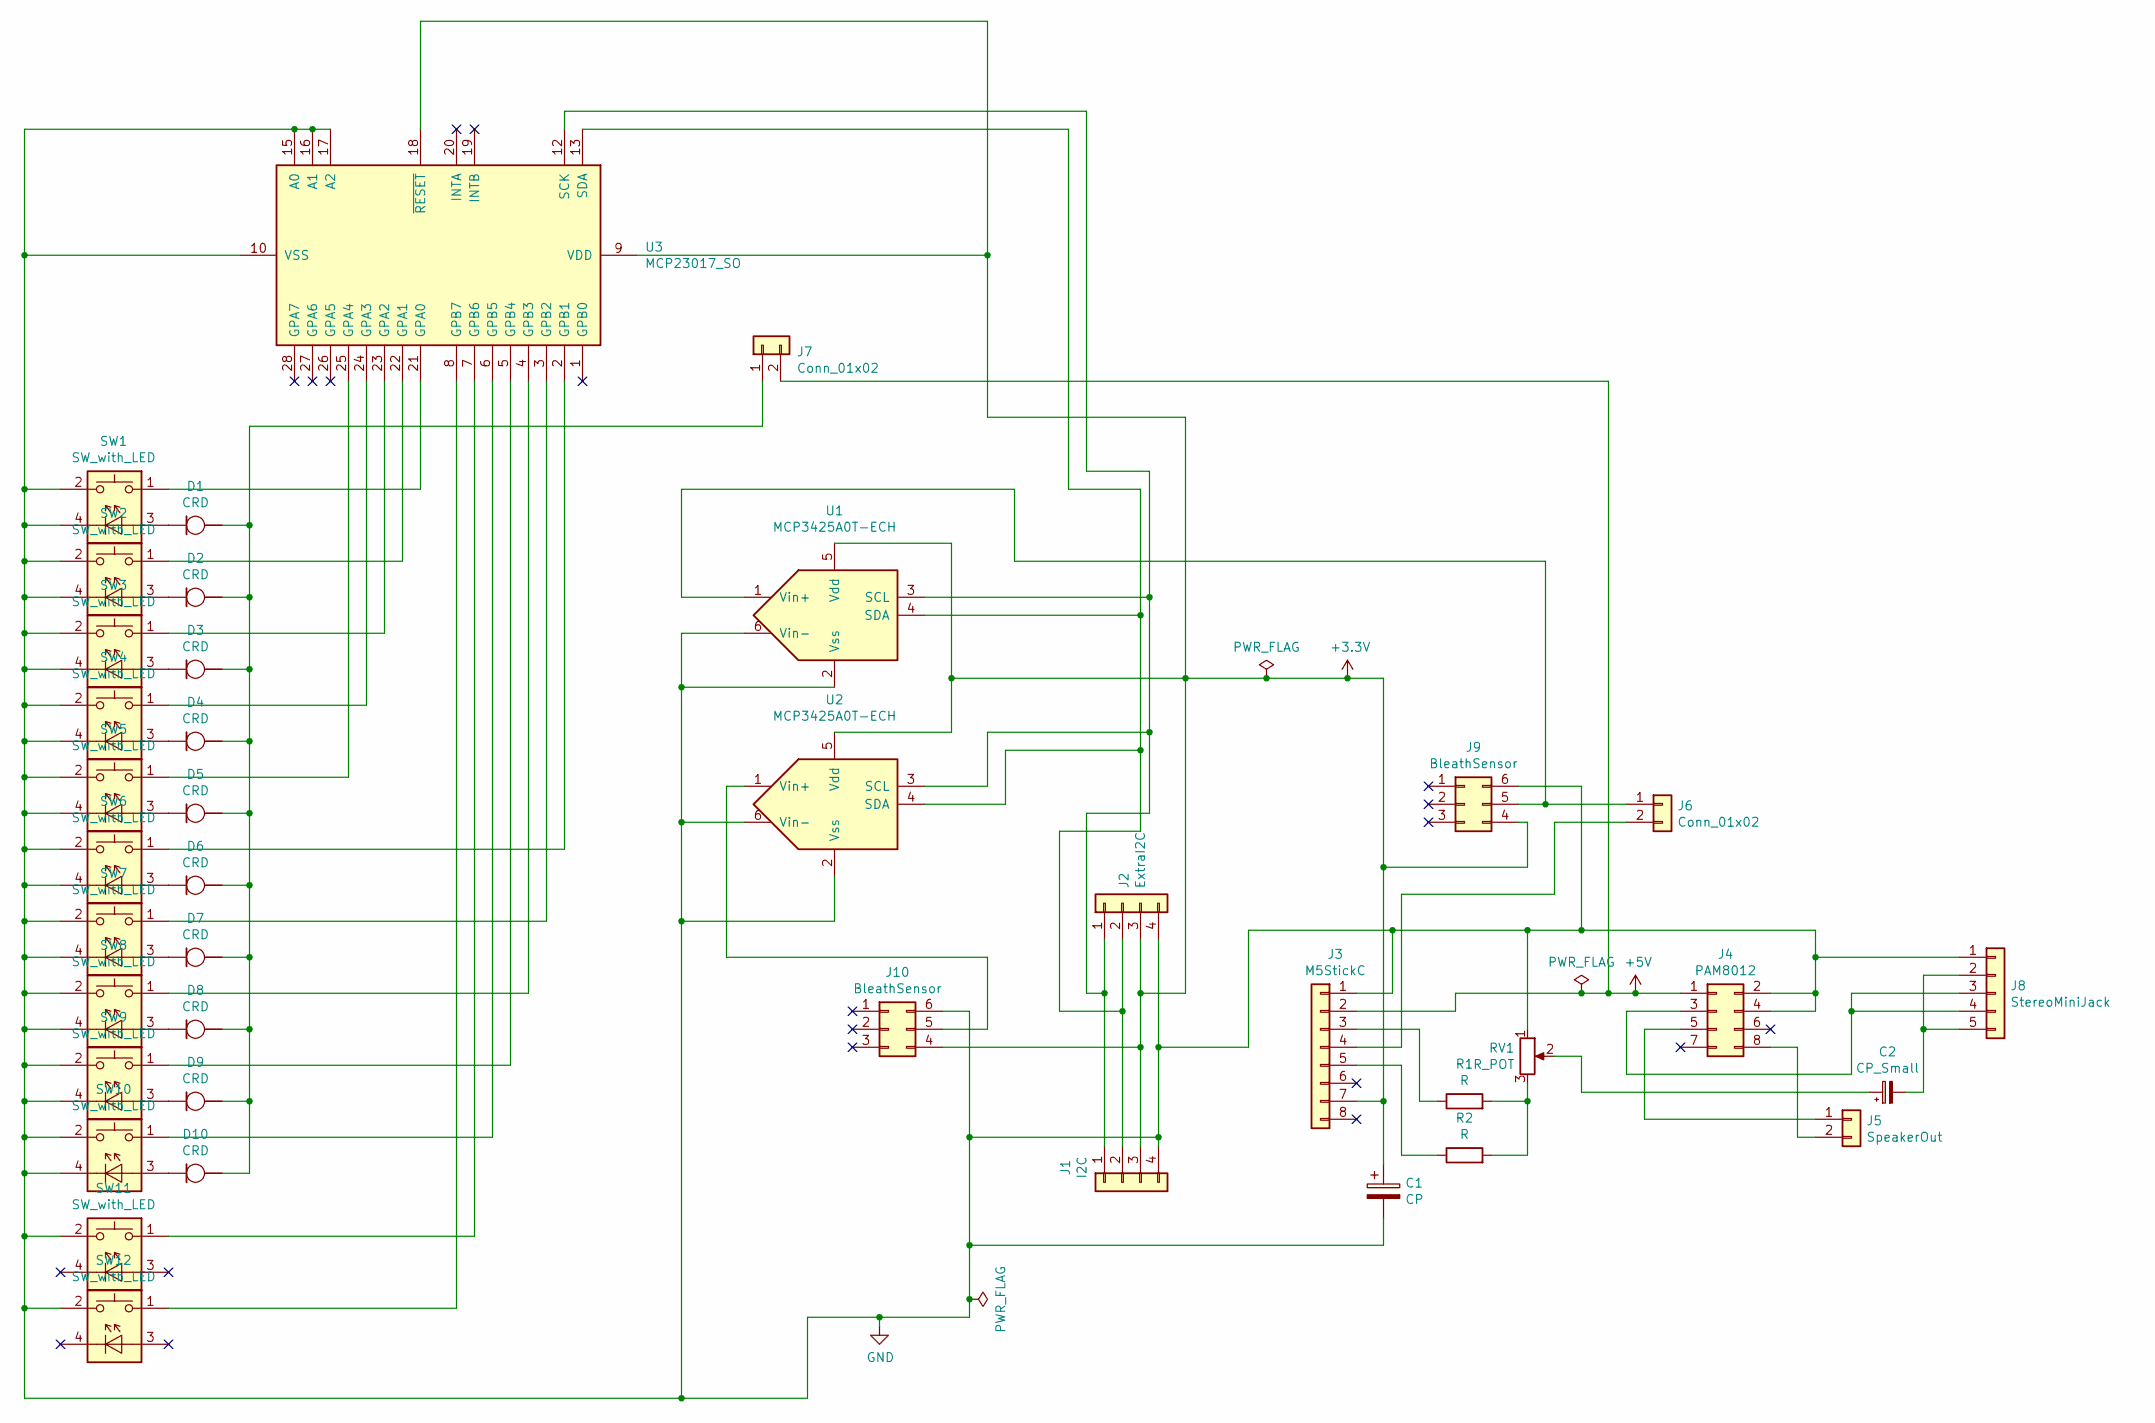
[picture p101: schematic windsynth.sch, AFUUE ver1.9 Main Board]

Parts:
C1: CP; PinHeader_1x02_P2.54mm_Vertical
C2: CP_Small; PinHeader_1x02_P2.54mm_Vertical
D1, D2, D3, D4, D5, D6, D7, D8, D9, D10: CRD; LED_0805_2012Metric
J1: I2C; JST_PH_B4B-PH-SM4-TB_1x04-1MP_P2.00mm_Vertical
J2: ExtraI2C; PinHeader_1x04_P2.00mm_Vertical
J3: M5StickC; PinHeader_1x08_P2.54mm_Horizontal
J4: PAM8012; AE-PAM8012
J5: SpeakerOut; USGM30
J6, J7: Conn_01x02; SolderJumper-2_P1.3mm_Open_RoundedPad1.0x1.5mm
J8: StereoMiniJack; PJ-307 AudioJack
J9, J10: BleathSensor; DIP-6_W7.62mm_Reverse
R1, R2: R; PinHeader_1x02_P2.54mm_Vertical
RV1: R_POT; R1001-N16
SW1, SW2, SW3, SW4, SW5, SW6, SW7, SW8, SW9, SW10, SW11, SW12: SW_with_LED; KailhLowProfileSW
U1, U2: MCP3425A0T-ECH; SOT-23-6_Handsoldering
U3: MCP23017_SO; SOIC-28W_7.5x17.9mm_P1.27mm

Connections:
GND: C1.2, J1.4, J2.4, J3.1, J4.2, J4.4, J8.1, J9.6, J10.6, RV1.1, SW1.2, SW1.4, SW2.2, SW2.4, SW3.2, SW3.4, SW4.2, SW4.4, SW5.2, SW5.4, SW6.2, SW6.4, SW7.2, SW7.4, SW8.2, SW8.4, SW9.2, SW9.4, SW10.2, SW10.4, SW11.2, SW12.2, U1.2 (Vss), U1.6 (Vin-), U2.2 (Vss), U2.6 (Vin-), U3.10 (VSS), U3.15 (A0), U3.16 (A1), U3.17 (A2)
unnamed: C2.1, RV1.2
unnamed: C2.2, J8.2, J8.5
unnamed: D1.1 (K), SW1.3
unnamed: D1.2 (A), D2.2 (A), D3.2 (A), D4.2 (A), D5.2 (A), D6.2 (A), D7.2 (A), D8.2 (A), D9.2 (A), D10.2 (A), J7.1
unnamed: D2.1 (K), SW2.3
unnamed: D3.1 (K), SW3.3
unnamed: D4.1 (K), SW4.3
unnamed: D5.1 (K), SW5.3
unnamed: D6.1 (K), SW6.3
unnamed: D7.1 (K), SW7.3
unnamed: D8.1 (K), SW8.3
unnamed: D9.1 (K), SW9.3
unnamed: D10.1 (K), SW10.3
unnamed: J1.1, J2.1, U1.3 (SCL), U2.3 (SCL), U3.12 (SCK)
unnamed: J1.2, J2.2, U1.4 (SDA), U2.4 (SDA), U3.13 (SDA)
unnamed: J3.3, R1.1
unnamed 17: J3.4, J6.2; also elsewhere on the board
unnamed: J3.5, R2.1
unnamed: J4.3, J8.3, J8.4
unnamed: J4.5, J5.1
unnamed: J4.8, J5.2
unnamed 22: J6.1, J9.5, U1.1 (Vin+); also elsewhere on the board
unnamed: J10.5, U2.1 (Vin+)
unnamed: R1.2, R2.2, RV1.3
unnamed: SW1.1, U3.21 (GPA0)
unnamed: SW2.1, U3.22 (GPA1)
unnamed: SW3.1, U3.23 (GPA2)
unnamed: SW4.1, U3.24 (GPA3)
unnamed: SW5.1, U3.25 (GPA4)
unnamed: SW6.1, U3.2 (GPB1)
unnamed: SW7.1, U3.3 (GPB2)
unnamed: SW8.1, U3.4 (GPB3)
unnamed: SW9.1, U3.5 (GPB4)
unnamed: SW10.1, U3.6 (GPB5)
unnamed: SW11.1, U3.7 (GPB6)
unnamed: SW12.1, U3.8 (GPB7)

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
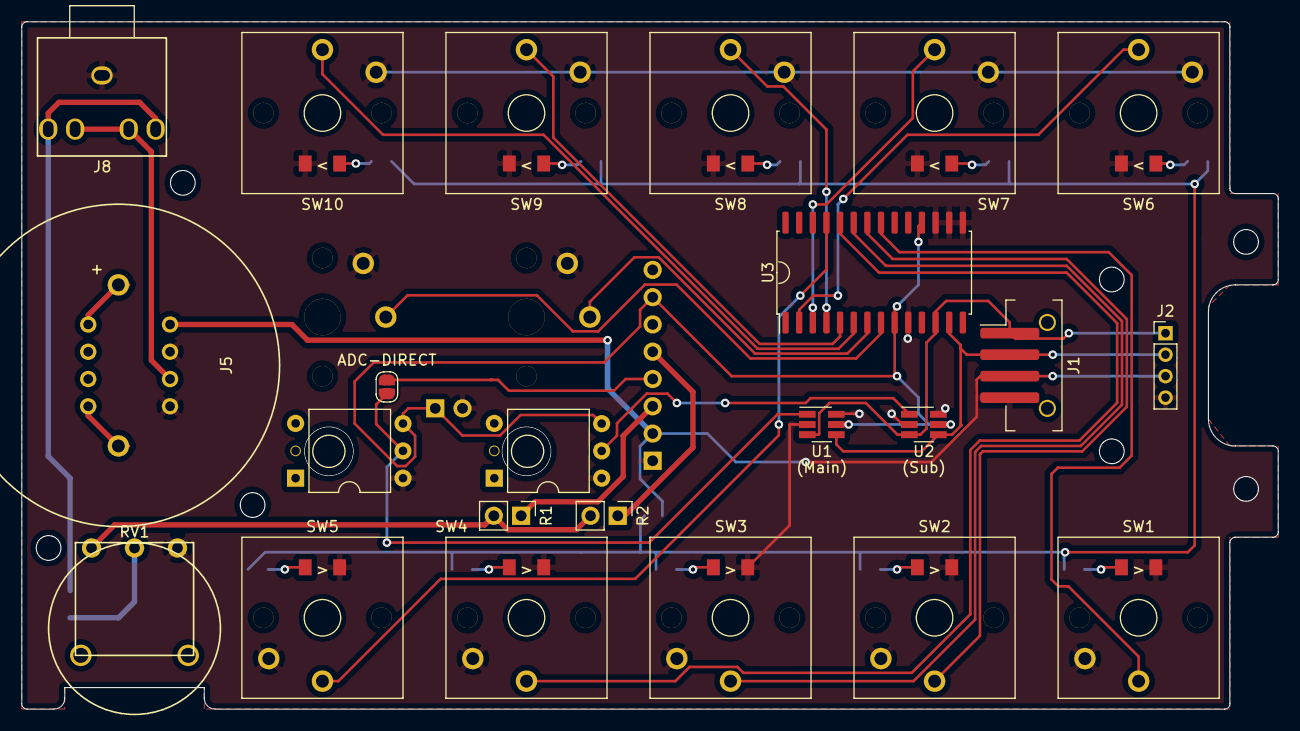
[picture p102: board afuue_project/KiCad/windsynth9/windsynth/windsynth.kicad_pcb from above]

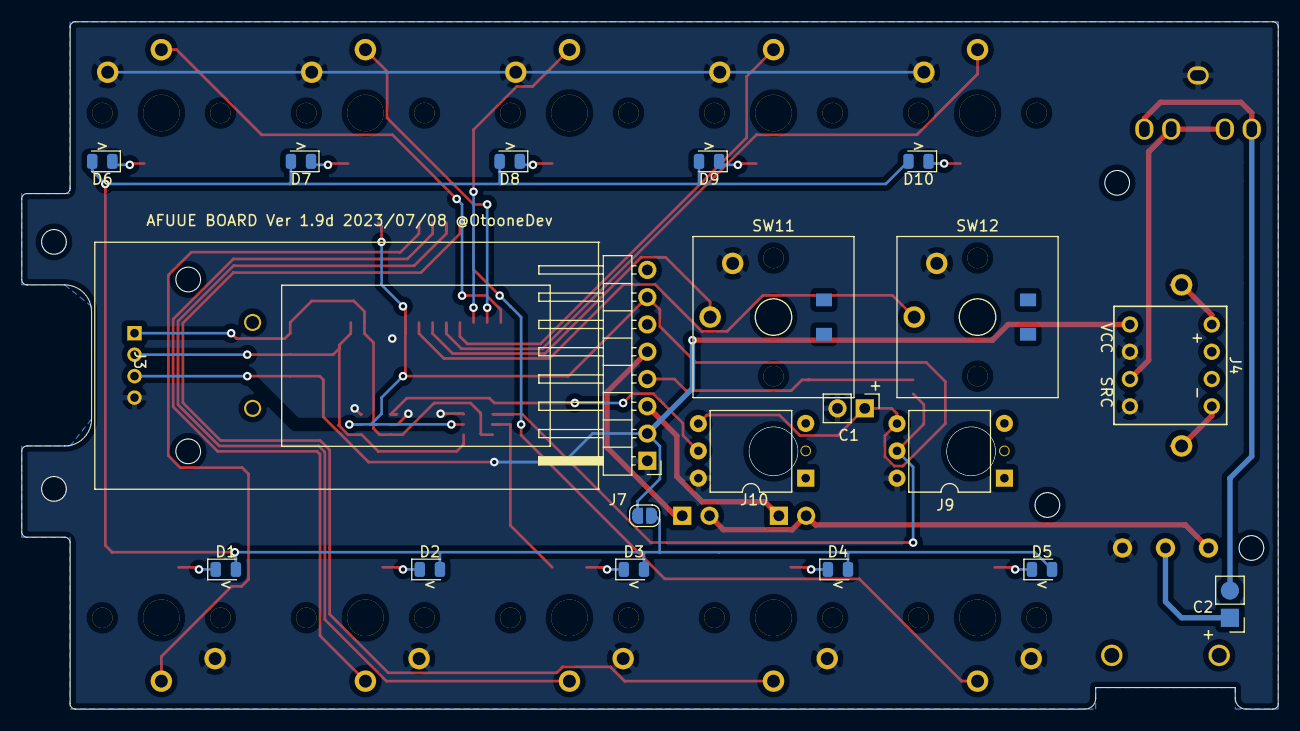
[picture p103: board afuue_project/KiCad/windsynth9/windsynth/windsynth.kicad_pcb from below]

Board: 2 copper layers, 117.0 x 64.0 mm, 40 parts (17 on the bottom side), 39 nets.

Other parts of the board:
ADC-DIRECT: Conn_01x02; SolderJumper-2_P1.3mm_Open_RoundedPad1.0x1.5mm

Their connections:
unnamed 17: ADC-DIRECT.2; also elsewhere on the board
unnamed 22: ADC-DIRECT.1; also elsewhere on the board
