otoone-dev/docs/afuue_project/KiCad/windsynth10/face/face/face.kicad_pcb

## KiCad design afuue_project/KiCad/windsynth10/face/face/face.kicad_pcb (2023-05-05)

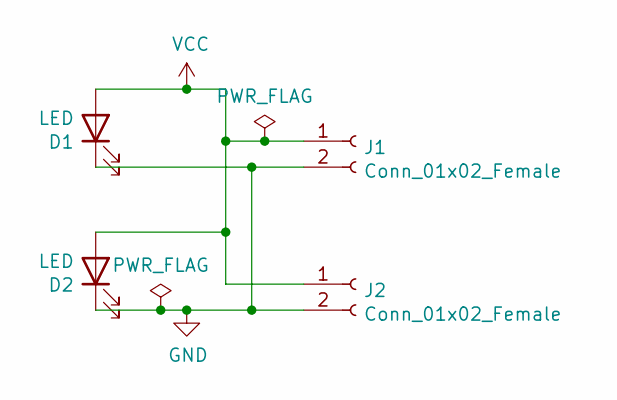
[picture p104: schematic face.sch]

Parts:
D1, D2: LED; LED_0603_1608Metric
J1, J2: Conn_01x02_Female; ContactPad_4mm

Connections:
GND: D1.1 (K), D2.1 (K), J1.2, J2.2
VCC: D1.2 (A), D2.2 (A), J1.1, J2.1

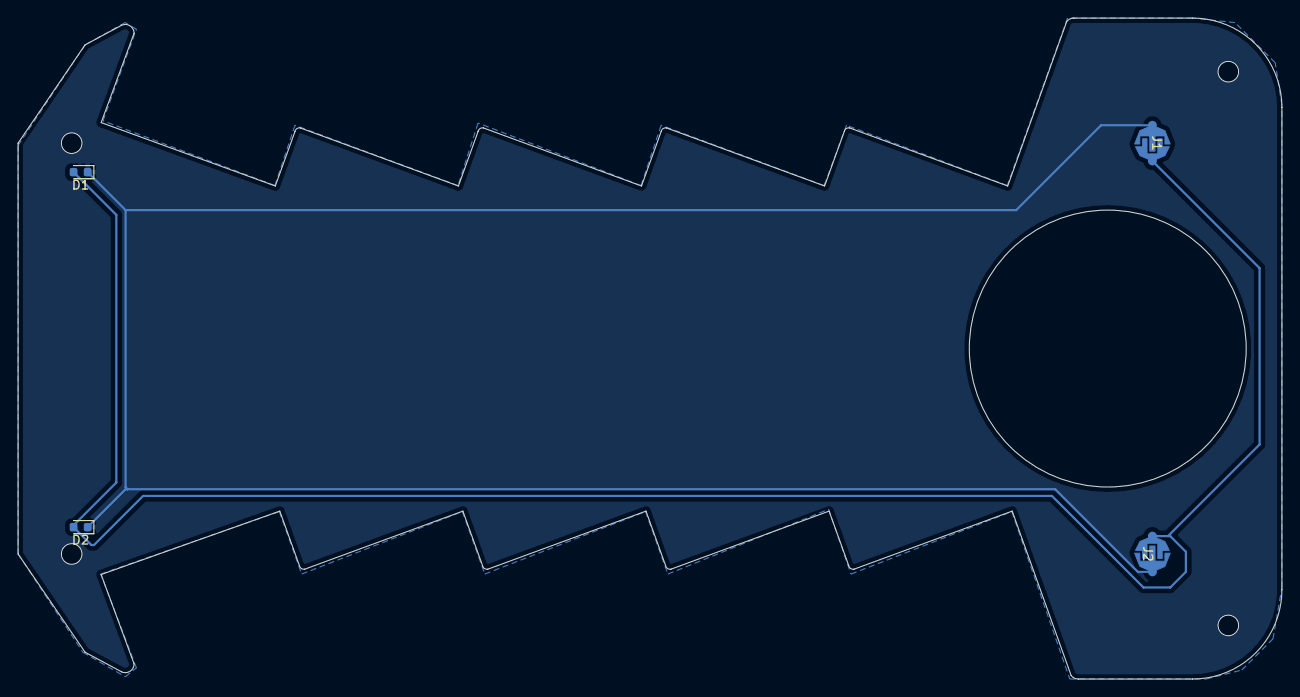
[picture p105: board face.kicad_pcb from below]

Board: 2 copper layers, 141.5 x 74.0 mm, 4 parts (4 on the bottom side), 2 nets.
