otoone-dev/docs/afuue_project/KiCad/windsynth10/windsynth/windsynth.kicad_pcb

## KiCad design afuue_project/KiCad/windsynth10/windsynth/windsynth.kicad_pcb (2023-05-05)

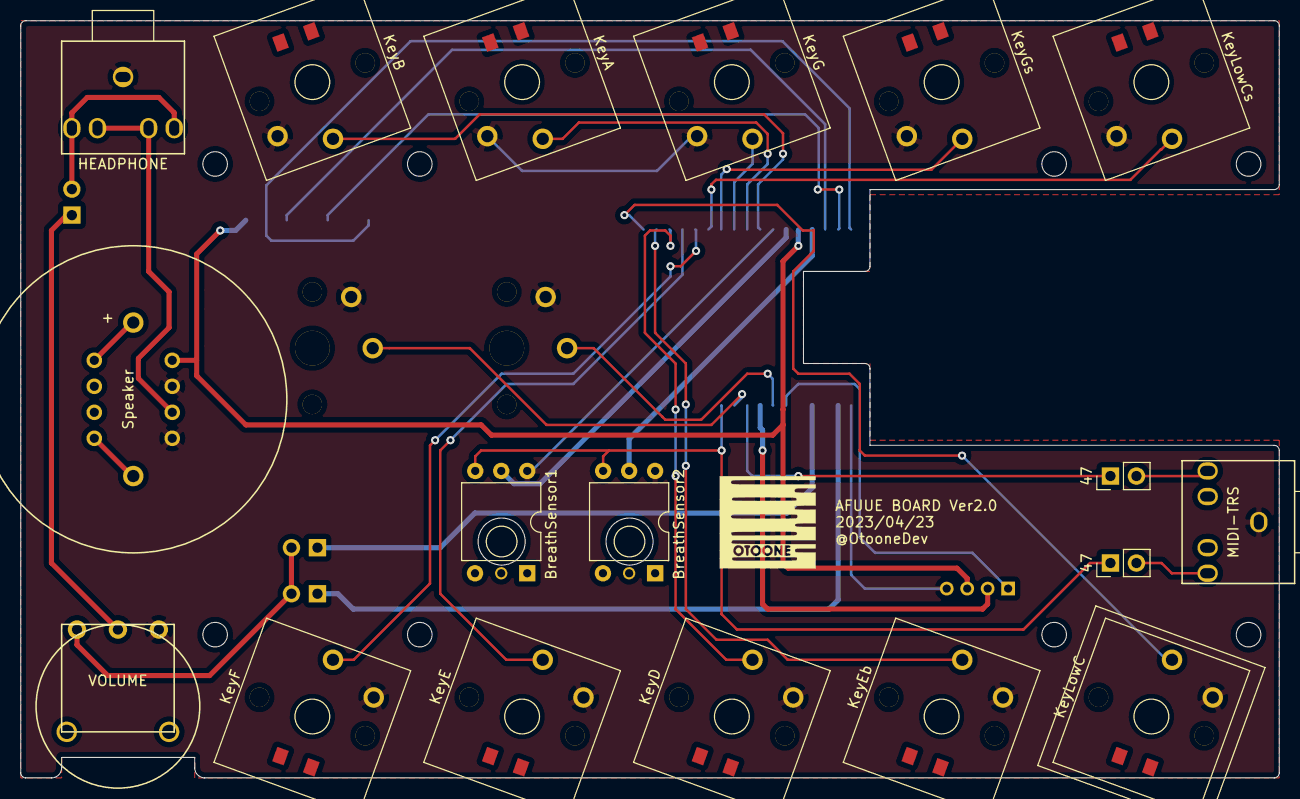
[picture p106: board afuue_project/KiCad/windsynth10/windsynth/windsynth.kicad_pcb from above]

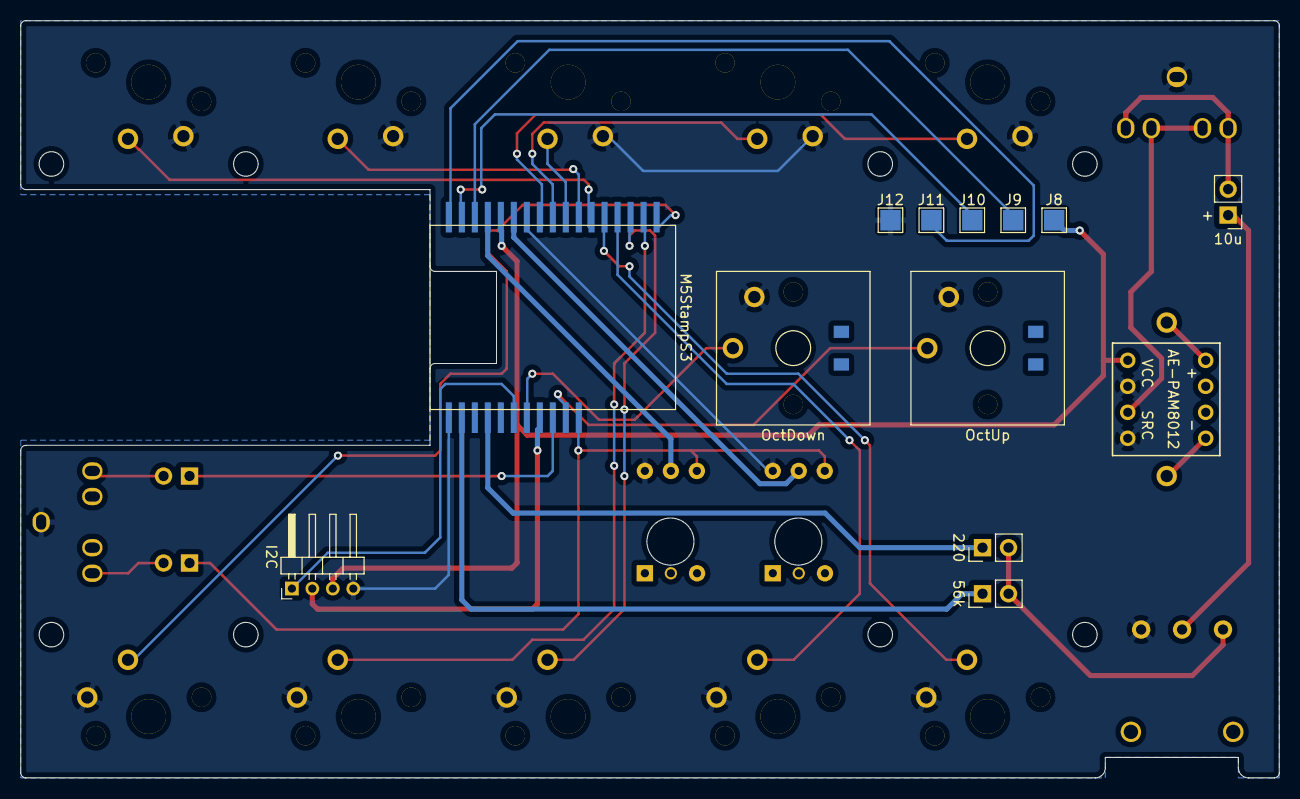
[picture p107: board afuue_project/KiCad/windsynth10/windsynth/windsynth.kicad_pcb from below]

Board: 2 copper layers, 123.0 x 74.0 mm, 31 parts (13 on the bottom side), 33 nets.

Parts:
10u: CP1_Small; PinHeader_1x02_P2.54mm_Vertical
47, 47#2: 47; PinHeader_1x02_P2.54mm_Vertical
56k: 56k; PinHeader_1x02_P2.54mm_Vertical
220: 220; PinHeader_1x02_P2.54mm_Vertical
AE-PAM8012: PAM8012; AE-PAM8012
BreathSensor1, BreathSensor2: BleathSensor; DIP-6_W7.62mm_Reverse
HEADPHONE: StereoMiniJack; PJ-307 AudioJack
I2C: I2C; PinHeader_1x04_P2.00mm_Horizontal
J8, J9, J10, J11, J12: Conn_01x01_Male; TestPoint_Pad_2.0x2.0mm
KeyA: SW_with_LED; KailhLowProfileSW
KeyB: SW_with_LED; KailhLowProfileSW
KeyD: SW_with_LED; KailhLowProfileSW
KeyE: SW_with_LED; KailhLowProfileSW
KeyEb: SW_with_LED; KailhLowProfileSW
KeyF: SW_with_LED; KailhLowProfileSW
KeyG: SW_with_LED; KailhLowProfileSW
KeyGs: SW_with_LED; KailhLowProfileSW
KeyLowC: SW_with_LED; KailhLowProfileSW
KeyLowCs: SW_with_LED; KailhLowProfileSW
M5StampS3: M5StampS3
MIDI-TRS: MIDI-TRS; PJ-307 AudioJack
OctDown: SW_with_LED; KailhLowProfileSW
OctUp: SW_with_LED; KailhLowProfileSW
Speaker: SpeakerOut; USGM30
VOLUME: R_POT; R1001-N16

Connections:
+3V3: 47#2.1, BreathSensor1.4, BreathSensor2.4, M5StampS3.28
+5V: AE-PAM8012.1, I2C.3, J8.1, M5StampS3.13
GND: AE-PAM8012.2, AE-PAM8012.4, BreathSensor1.6, BreathSensor2.6, HEADPHONE.1, I2C.4, J12.1, KeyA.2, KeyB.2, KeyD.2, KeyE.2, KeyEb.2, KeyF.2, KeyG.2, KeyGs.2, KeyLowC.2, KeyLowCs.2, M5StampS3.11, M5StampS3.18, MIDI-TRS.1, OctDown.2, OctUp.2, VOLUME.1
unnamed: 10u.1, VOLUME.2
unnamed: 10u.2, HEADPHONE.2, HEADPHONE.5
unnamed: BreathSensor1.5, M5StampS3.12
unnamed: BreathSensor2.5, M5StampS3.14
unnamed: AE-PAM8012.3, HEADPHONE.3, HEADPHONE.4
unnamed: 47.2, MIDI-TRS.2
unnamed: 47#2.2, MIDI-TRS.5
unnamed: AE-PAM8012.5, Speaker.1
unnamed: AE-PAM8012.8, Speaker.2
unnamed: I2C.1, M5StampS3.23
unnamed: I2C.2, M5StampS3.25
unnamed: J9.1, M5StampS3.15
unnamed: J10.1, M5StampS3.16
unnamed: J11.1, M5StampS3.17
unnamed: KeyA.1, M5StampS3.9
unnamed: KeyB.1, M5StampS3.10
unnamed: KeyD.1, M5StampS3.3
unnamed: KeyEb.1, M5StampS3.2
unnamed: KeyE.1, M5StampS3.4
unnamed: KeyF.1, M5StampS3.5
unnamed: KeyG.1, M5StampS3.8
unnamed: KeyGs.1, M5StampS3.7
unnamed: KeyLowC.1, M5StampS3.1
unnamed: KeyLowCs.1, M5StampS3.6
unnamed: M5StampS3.24, OctDown.1
unnamed: M5StampS3.27, OctUp.1
unnamed: 56k.1, M5StampS3.19
unnamed: 56k.2, 220.2, VOLUME.3
unnamed: 220.1, M5StampS3.21
unnamed: 47.1, M5StampS3.26
