otoone-dev/docs/afuue_project/KiCad/windsynth8b/windsynth/windsynth.kicad_pcb

## KiCad design afuue_project/KiCad/windsynth8b/windsynth/windsynth.kicad_pcb (2022-09-07, an earlier design)

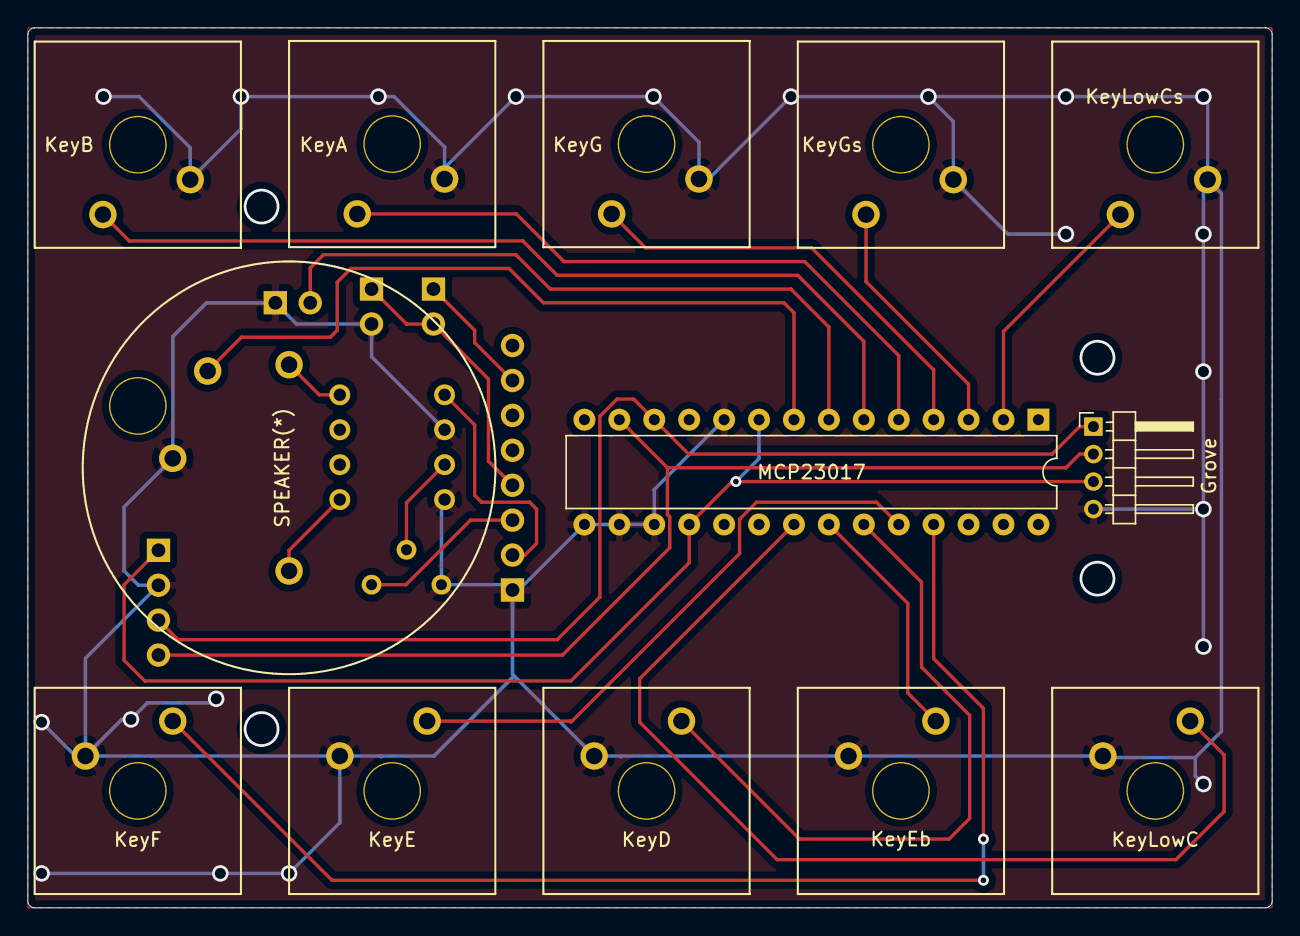
[picture p108: board afuue_project/KiCad/windsynth8b/windsynth/windsynth.kicad_pcb from above]

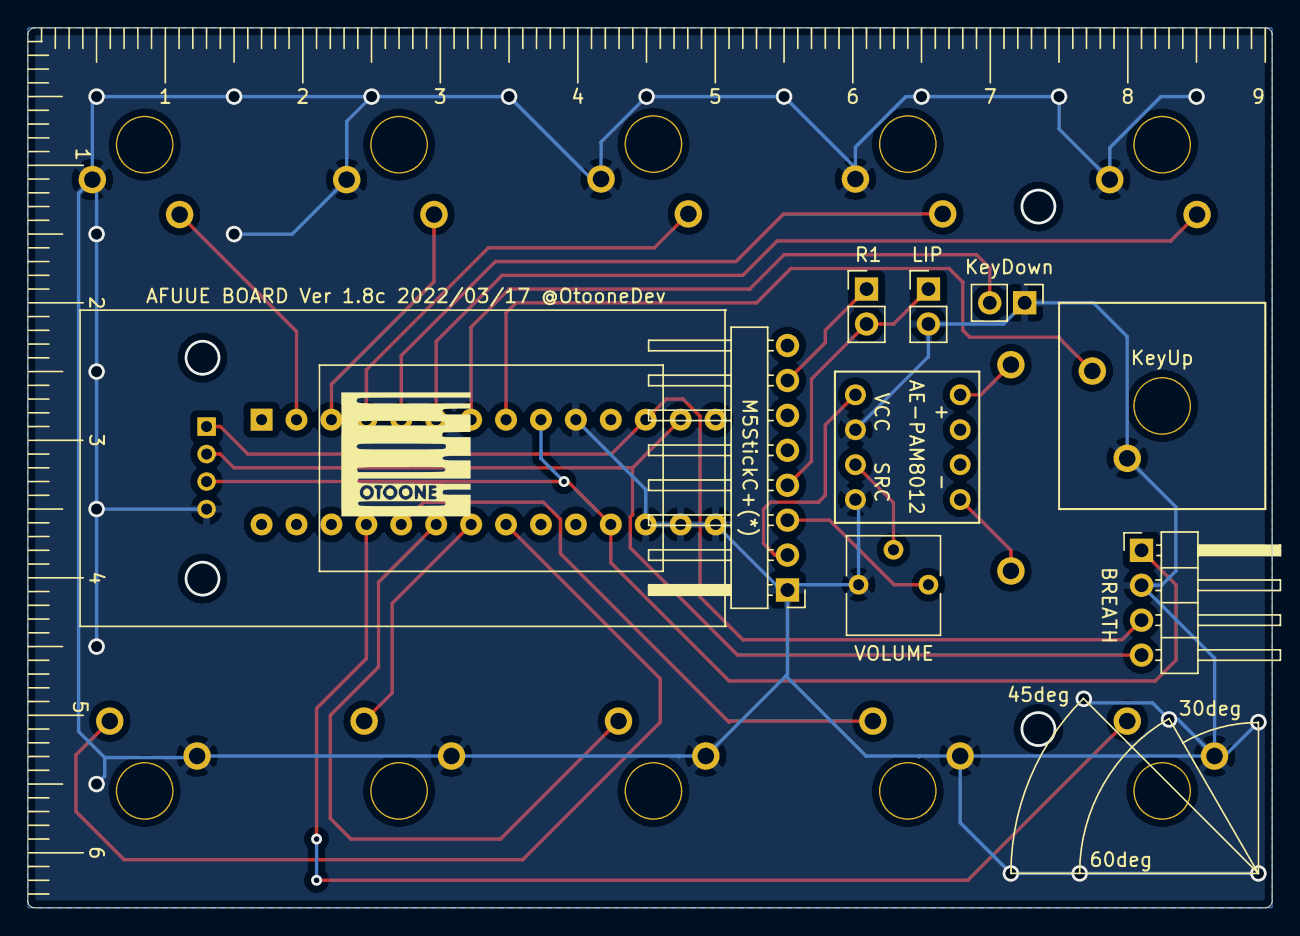
[picture p109: board afuue_project/KiCad/windsynth8b/windsynth/windsynth.kicad_pcb from below]

Board: 2 copper layers, 90.5 x 64.0 mm, 21 parts (8 on the bottom side), 23 nets.

Parts:
AE-PAM8012: Conn_02x04_Odd_Even; AE-PAM8012
BREATH: Conn_01x04; PinHeader_1x04_P2.54mm_Horizontal
Grove: Conn_01x04; PinHeader_1x04_P2.00mm_Horizontal
KeyA: SW_Push; CherryMX-Switch
KeyB: SW_Push; CherryMX-Switch
KeyD: SW_Push; CherryMX-Switch
KeyDown: SW_Push; PinHeader_1x02_P2.54mm_Vertical
KeyE: SW_Push; CherryMX-Switch
KeyEb: SW_Push; CherryMX-Switch
KeyF: SW_Push; CherryMX-Switch
KeyG: SW_Push; CherryMX-Switch
KeyGs: SW_Push; CherryMX-Switch
KeyLowC: SW_Push; CherryMX-Switch
KeyLowCs: SW_Push; CherryMX-Switch
KeyUp: SW_Push; CherryMX-Switch
LIP: Conn_01x02; PinHeader_1x02_P2.54mm_Vertical
M5StickC+(*): Conn_01x08; PinHeader_1x08_P2.54mm_Horizontal
MCP23017: MCP23017_SP; DIP-28_W7.62mm
R1: R; PinHeader_1x02_P2.54mm_Vertical
SPEAKER(*): Conn_01x02; USGM30
VOLUME: R_POT; Potentiometer_Vishay_T73YP_Vertical

Connections:
+5V: BREATH.1, Grove.3, MCP23017.9, MCP23017.18
GND: AE-PAM8012.2, AE-PAM8012.4, BREATH.2, Grove.4, KeyA.1, KeyB.1, KeyD.1, KeyDown.1, KeyE.1, KeyEb.1, KeyF.1, KeyG.1, KeyGs.1, KeyLowC.1, KeyLowCs.1, KeyUp.1, LIP.2, M5StickC+(*).1, MCP23017.10, MCP23017.15, MCP23017.16, MCP23017.17, VOLUME.3
unnamed: BREATH.3, Grove.1, MCP23017.12
unnamed: BREATH.4, Grove.2, MCP23017.13
unnamed: AE-PAM8012.1, M5StickC+(*).2
unnamed: M5StickC+(*).3, VOLUME.1
unnamed: LIP.1, M5StickC+(*).4, R1.2
unnamed: M5StickC+(*).7, R1.1
unnamed: AE-PAM8012.3, VOLUME.2
unnamed: AE-PAM8012.5, SPEAKER(*).1
unnamed: AE-PAM8012.8, SPEAKER(*).2
unnamed: KeyLowC.2, MCP23017.21
unnamed: KeyEb.2, MCP23017.22
unnamed: KeyD.2, MCP23017.23
unnamed: KeyE.2, MCP23017.24
unnamed: KeyF.2, MCP23017.25
unnamed: KeyLowCs.2, MCP23017.2
unnamed: KeyGs.2, MCP23017.3
unnamed: KeyG.2, MCP23017.4
unnamed: KeyA.2, MCP23017.5
unnamed: KeyB.2, MCP23017.6
unnamed: KeyDown.2, MCP23017.7
unnamed: KeyUp.2, MCP23017.8
