otoone-dev/docs/afuue_project/KiCad/windsynth7/windsynth/windsynth.kicad_pcb

## KiCad design afuue_project/KiCad/windsynth7/windsynth/windsynth.kicad_pcb (2021-12-04, an earlier design)

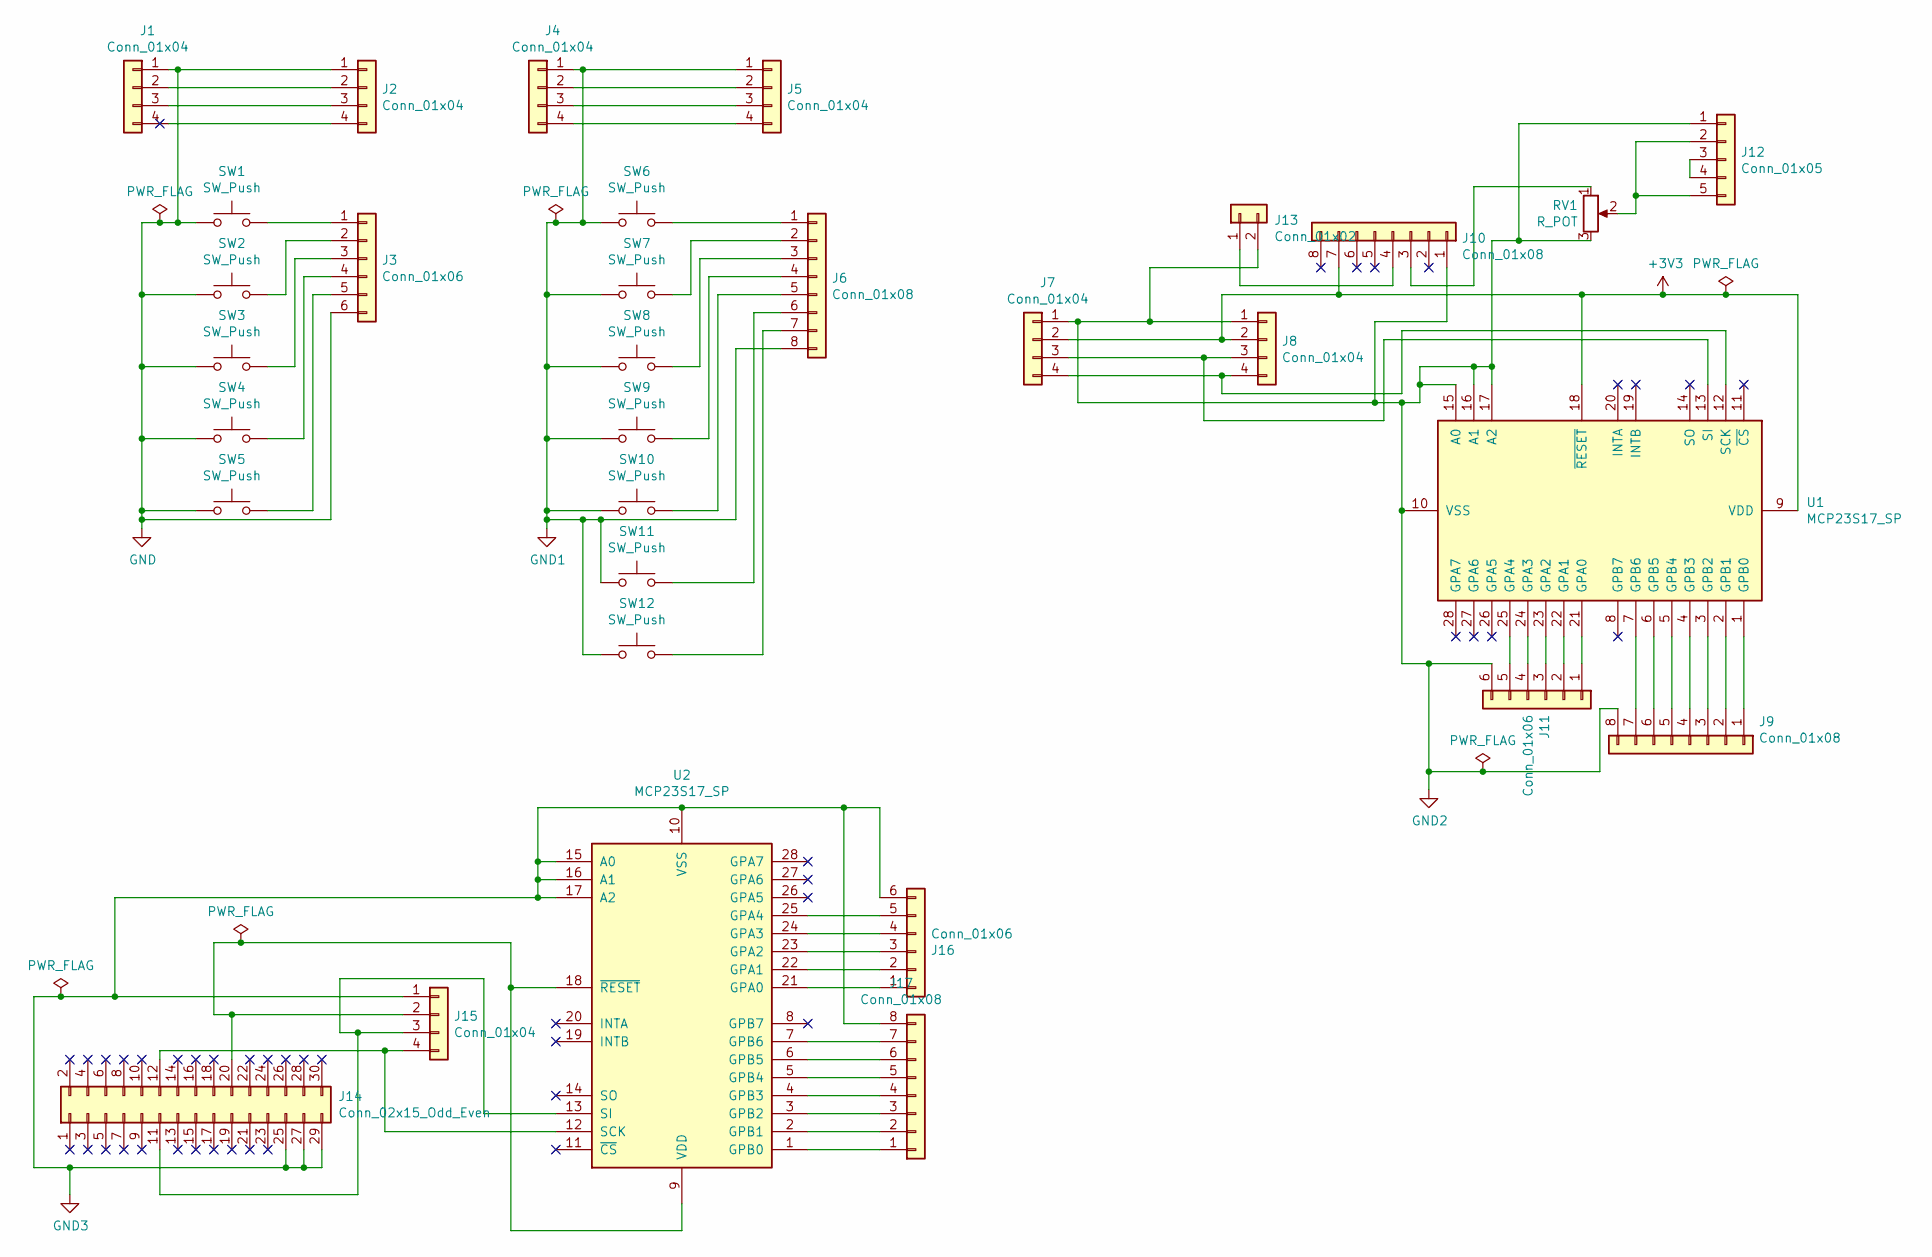
[picture p110: schematic windsynth.sch]

Parts:
J1, J8, J15: Conn_01x04; PinHeader_1x04_P2.00mm_Horizontal
J2, J4, J5, J7: Conn_01x04; PinHeader_1x04_P2.54mm_Vertical
J3, J11, J16: Conn_01x06; PinHeader_1x06_P2.54mm_Vertical
J6, J9, J17: Conn_01x08; PinHeader_1x08_P2.54mm_Vertical
J10: Conn_01x08; PinHeader_1x08_P2.54mm_Horizontal
J12: Conn_01x05; PJ-307 AudioJack
J13: Conn_01x02; PinHeader_1x02_P2.54mm_Vertical
J14: Conn_02x15_Odd_Even; PinHeader_2x15_P2.54mm_Vertical
RV1: R_POT; R1001-N16
SW1, SW2, SW3, SW4, SW5, SW6, SW7, SW8, SW9, SW10: SW_Push; CherryMX-Switch
SW11, SW12: SW_Push; PinHeader_1x02_P2.54mm_Vertical
U1, U2: MCP23S17_SP; DIP-28_W7.62mm

Connections:
+3V3: J7.2, J8.2, J10.7, U1.9 (VDD), U1.18 (~RESET~)
GND: J1.1, J2.1, J3.6, SW1.1, SW2.1, SW3.1, SW4.1, SW5.1
GND1: J4.1, J5.1, J6.8, SW6.1, SW7.1, SW8.1, SW9.1, SW10.1, SW11.1, SW12.1
GND2: J7.1, J8.1, J9.8, J10.1, J11.6, J12.1, J13.2, RV1.3, U1.10 (VSS), U1.15 (A0), U1.16 (A1), U1.17 (A2)
GND3: J14.25, J14.27, J14.29, J15.1, J16.6, J17.8, U2.10 (VSS), U2.15 (A0), U2.16 (A1), U2.17 (A2)
unnamed: J1.2, J2.2
unnamed: J1.3, J2.3
unnamed: J1.4, J2.4
unnamed: J3.1, SW1.2
unnamed: J3.2, SW2.2
unnamed: J3.3, SW3.2
unnamed: J3.4, SW4.2
unnamed: J3.5, SW5.2
unnamed: J4.2, J5.2
unnamed: J4.3, J5.3
unnamed: J4.4, J5.4
unnamed: J6.1, SW6.2
unnamed: J6.2, SW7.2
unnamed: J6.3, SW8.2
unnamed: J6.4, SW9.2
unnamed: J6.5, SW10.2
unnamed: J6.6, SW11.2
unnamed: J6.7, SW12.2
unnamed: J7.3, J8.3, U1.13 (SI)
unnamed: J7.4, J8.4, U1.12 (SCK)
unnamed: J9.1, U1.1 (GPB0)
unnamed: J9.2, U1.2 (GPB1)
unnamed: J9.3, U1.3 (GPB2)
unnamed: J9.4, U1.4 (GPB3)
unnamed: J9.5, U1.5 (GPB4)
unnamed: J9.6, U1.6 (GPB5)
unnamed: J9.7, U1.7 (GPB6)
unnamed: J10.3, RV1.1
unnamed: J10.4, J13.1
unnamed: J11.1, U1.21 (GPA0)
unnamed: J11.2, U1.22 (GPA1)
unnamed: J11.3, U1.23 (GPA2)
unnamed: J11.4, U1.24 (GPA3)
unnamed: J11.5, U1.25 (GPA4)
unnamed: J12.2, J12.5, RV1.2
unnamed: J12.3, J12.4
unnamed: J14.11, J15.3, U2.13 (SI)
unnamed: J14.12, J15.4, U2.12 (SCK)
unnamed: J14.20, J15.2, U2.9 (VDD), U2.18 (~RESET~)
unnamed: J16.1, U2.21 (GPA0)
unnamed: J16.2, U2.22 (GPA1)
unnamed: J16.3, U2.23 (GPA2)
unnamed: J16.4, U2.24 (GPA3)
unnamed: J16.5, U2.25 (GPA4)
unnamed: J17.1, U2.1 (GPB0)
unnamed: J17.2, U2.2 (GPB1)
unnamed: J17.3, U2.3 (GPB2)
unnamed: J17.4, U2.4 (GPB3)
unnamed: J17.5, U2.5 (GPB4)
unnamed: J17.6, U2.6 (GPB5)
unnamed: J17.7, U2.7 (GPB6)

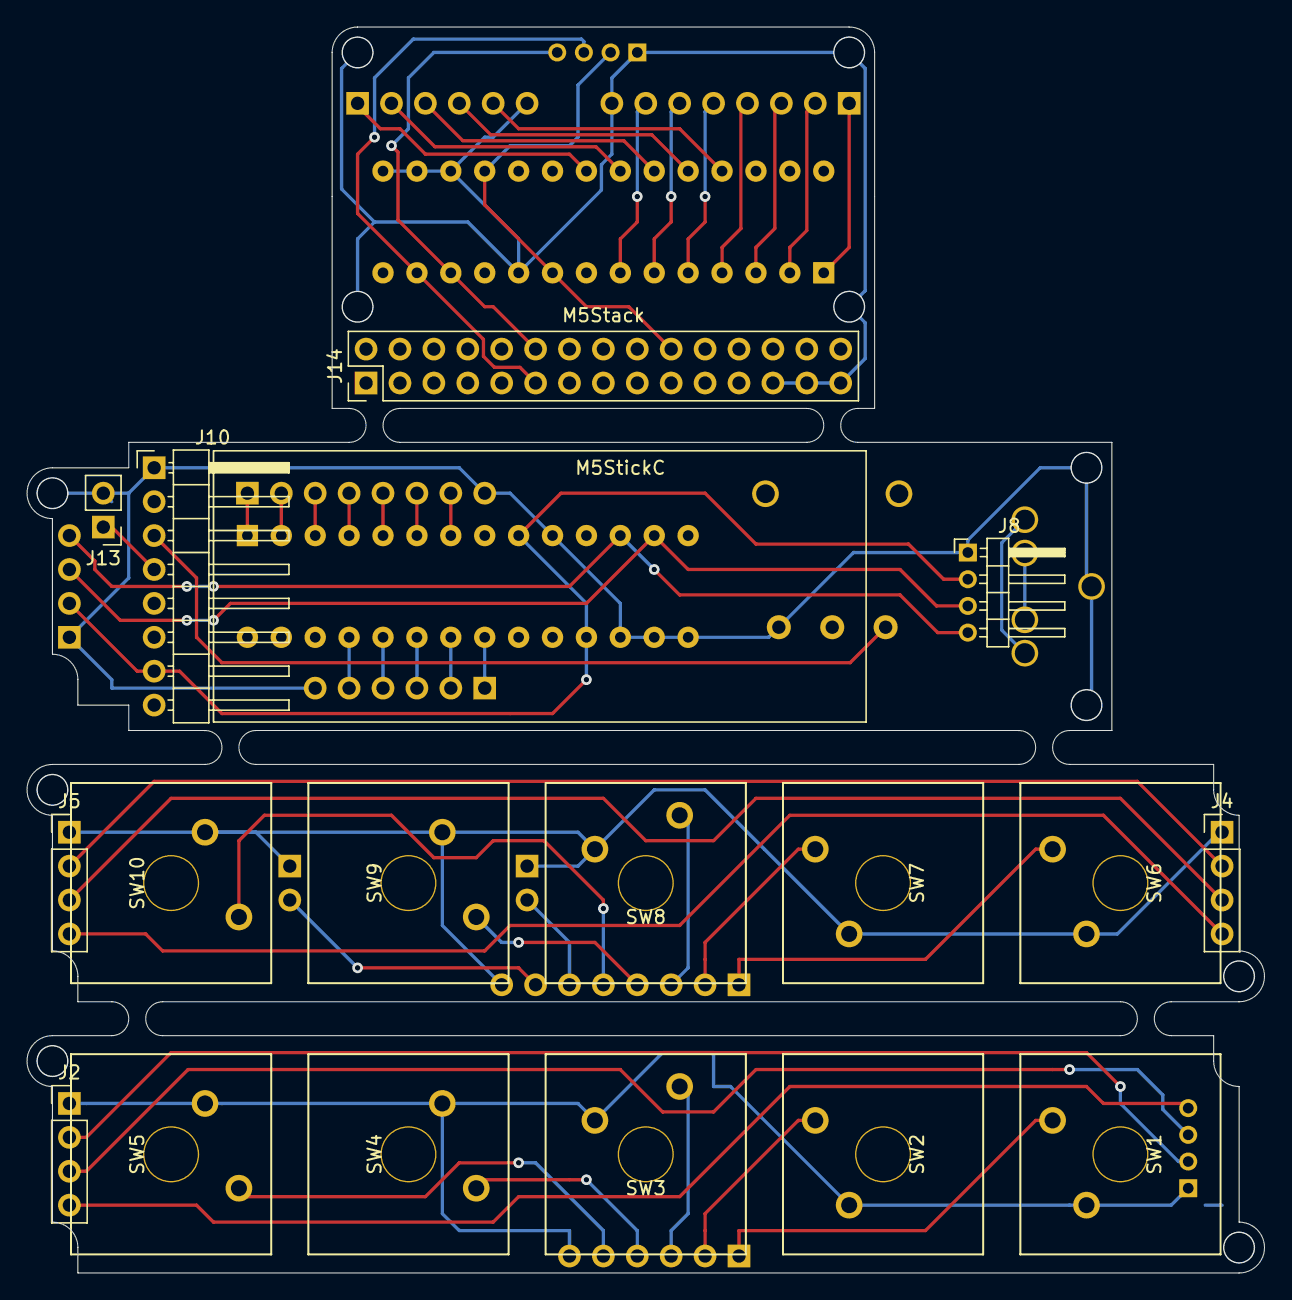
[picture p111: board afuue_project/KiCad/windsynth7/windsynth/windsynth.kicad_pcb from above]

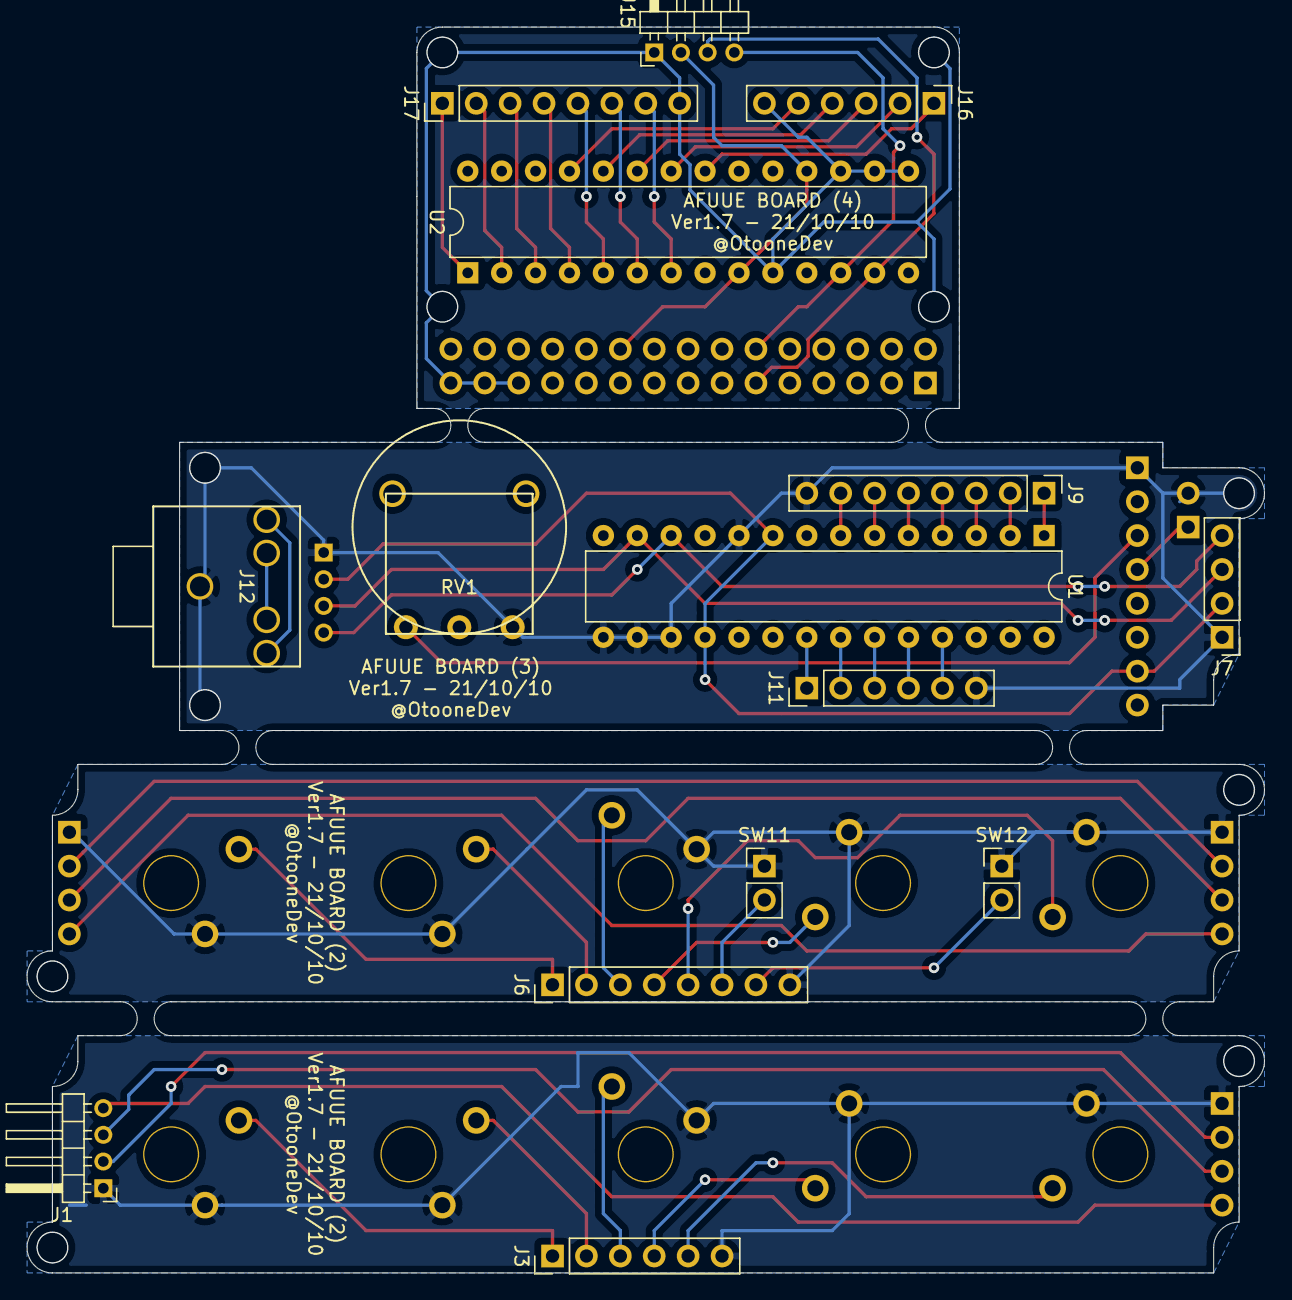
[picture p112: board afuue_project/KiCad/windsynth7/windsynth/windsynth.kicad_pcb from below]

Board: 2 copper layers, 92.7 x 93.3 mm, 32 parts (15 on the bottom side), 56 nets.
