otoone-dev/docs/afuue_project/KiCad/pc1245/pc1245/pc1245.kicad_pcb

## KiCad design afuue_project/KiCad/pc1245/pc1245/pc1245.kicad_pcb (2021-12-04)

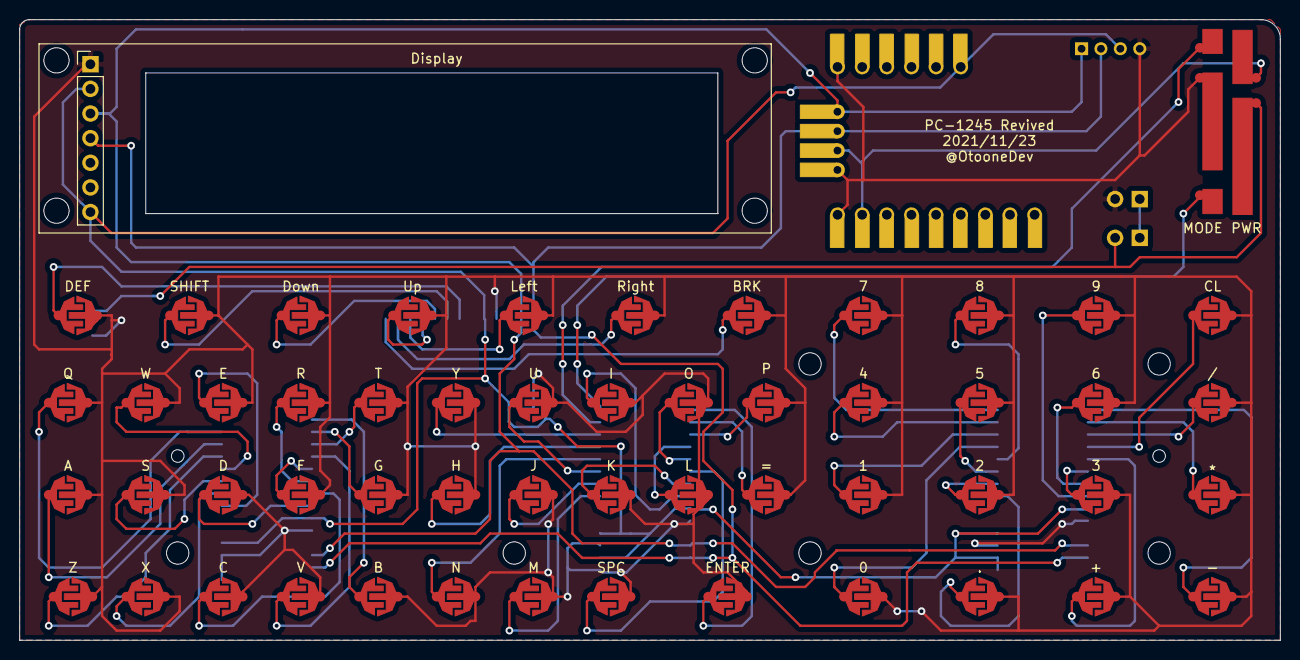
[picture p113: board pc1245.kicad_pcb from above]

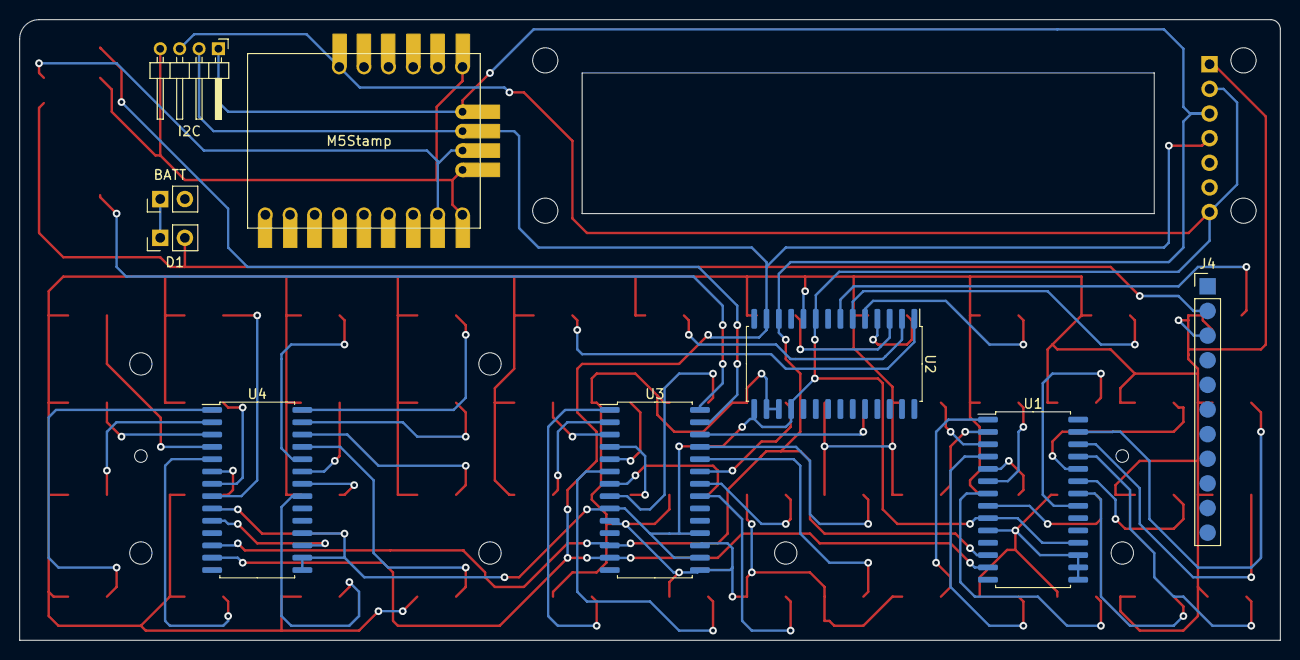
[picture p114: board pc1245.kicad_pcb from below]

Board: 2 copper layers, 130.0 x 64.0 mm, 64 parts (9 on the bottom side), 61 nets.

Parts:
0, 1, 2, 3, 4, 5, 6, 7, 8, 9, .: SW_Push; ContactPad_4mm
*: SW_Push; ContactPad_4mm
+: SW_Push; ContactPad_4mm
-: SW_Push; ContactPad_4mm
/: SW_Push; ContactPad_4mm
=: SW_Push; ContactPad_4mm
A: SW_Push; ContactPad_4mm
B: SW_Push; ContactPad_4mm
BATT: Conn_01x02; PinHeader_1x02_P2.54mm_Vertical
BRK: SW_Push; ContactPad_4mm
C: SW_Push; ContactPad_4mm
CL: SW_Push; ContactPad_4mm
D: SW_Push; ContactPad_4mm
D1: DIODE; PinHeader_1x02_P2.54mm_Vertical
DEF: SW_Push; ContactPad_4mm
Display: Conn_01x07; PinHeader_1x07_P2.54mm_Vertical
Down: SW_Push; ContactPad_4mm
E: SW_Push; ContactPad_4mm
ENTER: SW_Push; ContactPad_4mm
F: SW_Push; ContactPad_4mm
G: SW_Push; ContactPad_4mm
H: SW_Push; ContactPad_4mm
I: SW_Push; ContactPad_4mm
I2C: Conn_01x04; PinHeader_1x04_P2.00mm_Horizontal
J: SW_Push; ContactPad_4mm
J4: Conn_01x11; PinHeader_1x11_P2.54mm_Vertical
K: SW_Push; ContactPad_4mm
L: SW_Push; ContactPad_4mm
Left: SW_Push; ContactPad_4mm
M: SW_Push; ContactPad_4mm
M5Stamp: M5Stamp; M5StampPico
MODE: SW_SPDT; PC1245_ModeSlideSw
N: SW_Push; ContactPad_4mm
O: SW_Push; ContactPad_4mm
P: SW_Push; ContactPad_4mm
PWR: SW_SPST; PC1245_PowerSlideSw
Q: SW_Push; ContactPad_4mm
R: SW_Push; ContactPad_4mm
Right: SW_Push; ContactPad_4mm
S: SW_Push; ContactPad_4mm
SHIFT: SW_Push; ContactPad_4mm
SPC: SW_Push; ContactPad_4mm
T: SW_Push; ContactPad_4mm
U: SW_Push; ContactPad_4mm
U1, U2, U3, U4: MCP23017_SO; SOIC-28W_7.5x17.9mm_P1.27mm
Up: SW_Push; ContactPad_4mm
V: SW_Push; ContactPad_4mm
W: SW_Push; ContactPad_4mm
X: SW_Push; ContactPad_4mm
Y: SW_Push; ContactPad_4mm
Z: SW_Push; ContactPad_4mm

Connections:
+3V3: Display.2, Display.7, I2C.3, M5Stamp.19, U1.9, U1.18, U2.9, U2.15, U2.18, U3.9, U3.16, U3.18, U4.9, U4.15, U4.16, U4.18
+5V: M5Stamp.8, M5Stamp.11, PWR.1
-BATT: 0.2, 1.2, 2.2, 3.2, 4.2, 5.2, 6.2, 7.2, 8.2, 9.2, *.2, +.2, -.2, ..2, /.2, =.2, A.2, B.2, BATT.2, BRK.2, C.2, CL.2, D.2, DEF.2, Display.1, Down.2, E.2, ENTER.2, F.2, G.2, H.2, I.2, I2C.4, J.2, J4.3, K.2, L.2, Left.2, M.2, M5Stamp.9, M5Stamp.10, M5Stamp.14, MODE.2, N.2, O.2, P.2, Q.2, R.2, Right.2, S.2, SHIFT.2, SPC.2, T.2, U.2, U1.10, U1.15, U1.16, U1.17, U2.10, U2.16, U2.17, U3.10, U3.15, U3.17, U4.10, U4.17, Up.2, V.2, W.2, X.2, Y.2, Z.2
unnamed: BATT.1, D1.1
unnamed: D1.2, J4.2, PWR.2
unnamed: Display.3, I2C.1, M5Stamp.13, U1.12, U2.12, U3.12, U4.12
unnamed: Display.4, I2C.2, M5Stamp.12, U1.13, U2.13, U3.13, U4.13
unnamed: DEF.1, U2.7
unnamed: Q.1, U1.27
unnamed: A.1, U1.26
unnamed: U1.25, Z.1
unnamed: U1.24, W.1
unnamed: S.1, U1.23
unnamed: U1.22, X.1
unnamed: SHIFT.1, U2.6
unnamed: E.1, U1.21
unnamed: D.1, U1.8
unnamed: C.1, U1.7
unnamed: Down.1, U2.5
unnamed: R.1, U1.6
unnamed: F.1, U1.5
unnamed: U1.4, V.1
unnamed: T.1, U1.3
unnamed: G.1, U1.2
unnamed: B.1, U1.1
unnamed: U2.4, Up.1
unnamed: U3.26, Y.1
unnamed: H.1, U3.25
unnamed: N.1, U3.24
unnamed: Left.1, U2.3
unnamed: U.1, U3.23
unnamed: J.1, U3.22
unnamed: M.1, U3.21
unnamed: Right.1, U2.2
unnamed: I.1, U3.8
unnamed: K.1, U3.7
unnamed: SPC.1, U3.6
unnamed: O.1, U3.5
unnamed: L.1, U3.4
unnamed: ENTER.1, U3.1
unnamed: BRK.1, U2.1
unnamed: P.1, U3.3
unnamed: =.1, U3.2
unnamed: 7.1, U4.28
unnamed: 4.1, U4.27
unnamed: 1.1, U4.26
unnamed: 0.1, U4.25
unnamed: 8.1, U4.24
unnamed: 5.1, U4.23
unnamed: 2.1, U4.22
unnamed: ..1, U4.21
unnamed: 9.1, U4.8
unnamed: 6.1, U4.7
unnamed: 3.1, U4.6
unnamed: +.1, U4.5
unnamed: CL.1, U4.4
unnamed: /.1, U4.3
unnamed: *.1, U4.2
unnamed: -.1, U4.1
unnamed: MODE.1, U3.27
unnamed: MODE.3, U3.28
