otoone-dev/docs/afuue_project/KiCad/windsynth5_ver1.6/windsynyh5.kicad_pcb

## KiCad design afuue_project/KiCad/windsynth5_ver1.6/windsynyh5.kicad_pcb (2021-04-25)

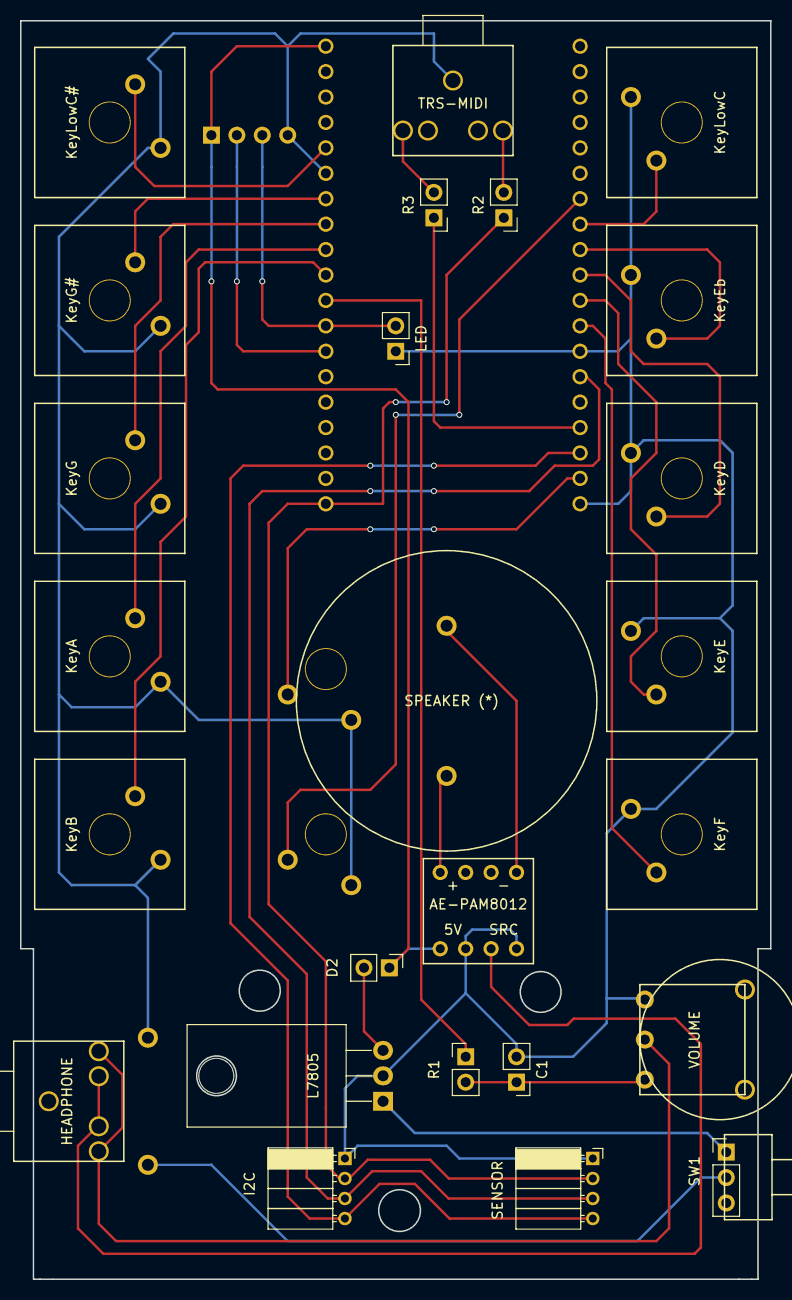
[picture p115: board afuue_project/KiCad/windsynth5_ver1.6/windsynyh5.kicad_pcb from above]

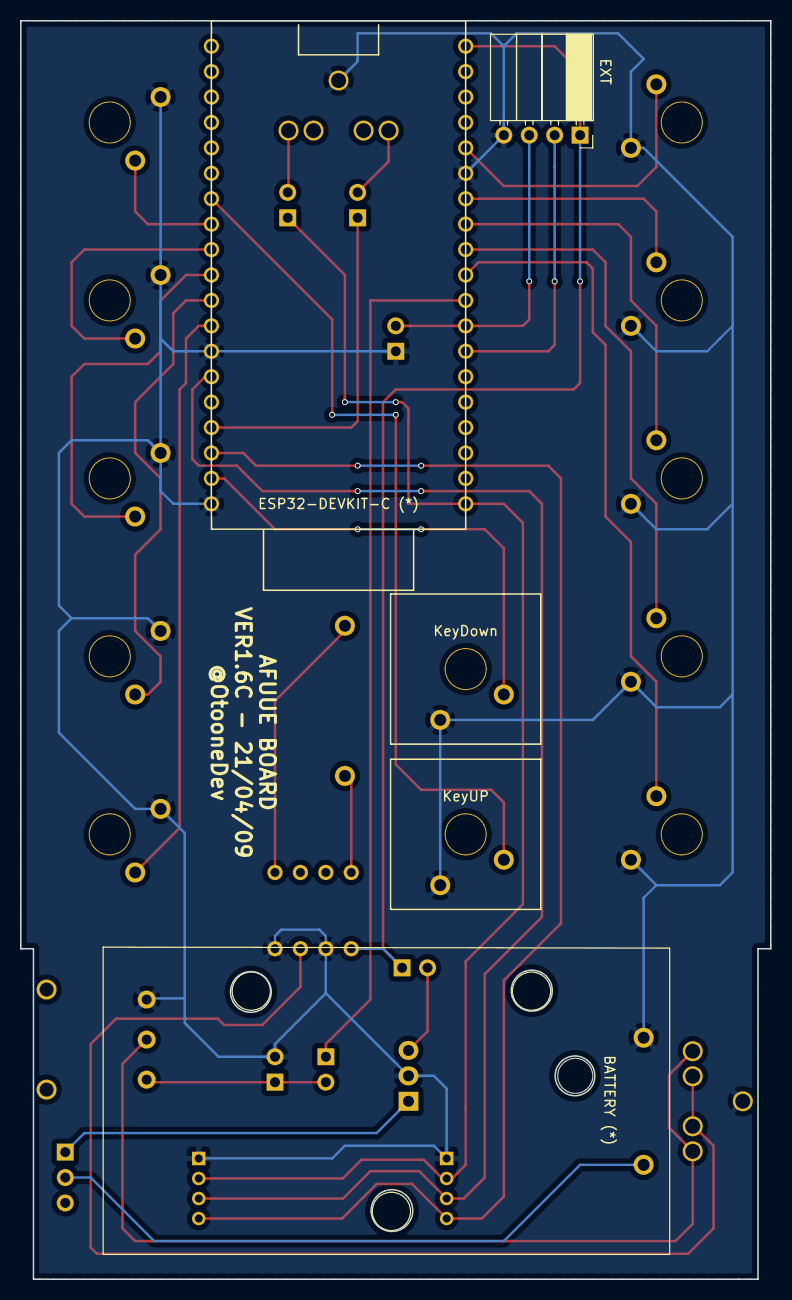
[picture p116: board afuue_project/KiCad/windsynth5_ver1.6/windsynyh5.kicad_pcb from below]

Board: 2 copper layers, 74.9 x 125.7 mm, 30 parts (5 on the bottom side), 31 nets.

Parts:
AE-PAM8012: AE-PAM8012
BATTERY (*): POWER; BH-9V-3P24
C1: C; Pin_Header_Straight_1x02_Pitch2.54mm
D2: 1N5822; PinHeader_1x02_P2.54mm_Vertical
ESP32-DEVKIT-C (*): ESP32-DEVKIT-C
EXT: EXT; Socket_Strip_Angled_1x04_Pitch2.54mm
HEADPHONE: HEADPHONE; PJ-307 AudioJack
I2C: I2C; Socket_Strip_Angled_1x04_Pitch2.00mm
KeyA: KeyA; CherryMX-Switch
KeyB: KeyB; CherryMX-Switch
KeyD: KeyD; CherryMX-Switch
KeyDown: KeyDown; CherryMX-Switch
KeyE: KeyE; CherryMX-Switch
KeyEb: KeyEb; CherryMX-Switch
KeyF: KeyF; CherryMX-Switch
KeyG: KeyG; CherryMX-Switch
KeyG#: KeyG#; CherryMX-Switch
KeyLowC: KeyLowC; CherryMX-Switch
KeyLowC#: KeyLowC#; CherryMX-Switch
KeyUP: KeyUp; CherryMX-Switch
L7805: L7805; TO-220-3_Horizontal_TabDown
LED: Led_Small; Pin_Header_Straight_1x02_Pitch2.54mm
R1: 510; Pin_Header_Straight_1x02_Pitch2.54mm
R2, R3: 47; Pin_Header_Straight_1x02_Pitch2.54mm
SENSOR: SENSOR; Socket_Strip_Angled_1x04_Pitch2.00mm
SPEAKER (*): SPEAKER; USGM30
SW1: SW_SPDT; PinHeader_1x03_P2.54mm_Vertical
TRS-MIDI: TRS MIDI; PJ-307 AudioJack
VOLUME: POT; R1001-N16

Connections:
+5V: AE-PAM8012.1, D2.1, ESP32-DEVKIT-C (*).19, EXT.1
+9V: L7805.1, SW1.1
GND: AE-PAM8012.2, AE-PAM8012.4, BATTERY (*).2, C1.2, ESP32-DEVKIT-C (*).14, ESP32-DEVKIT-C (*).32, ESP32-DEVKIT-C (*).38, EXT.4, HEADPHONE.1, I2C.1, KeyA.2, KeyB.2, KeyD.2, KeyDown.2, KeyE.2, KeyEb.2, KeyF.2, KeyG.2, KeyG#.2, KeyLowC.2, KeyLowC#.2, KeyUP.2, L7805.2, LED.1, SENSOR.1, TRS-MIDI.1, VOLUME.1
unnamed: C1.1, R1.2, VOLUME.3
unnamed: ESP32-DEVKIT-C (*).8, EXT.3, LED.2
unnamed: D2.2, L7805.3
unnamed: ESP32-DEVKIT-C (*).11, KeyA.1
unnamed: ESP32-DEVKIT-C (*).10, KeyB.1
unnamed: ESP32-DEVKIT-C (*).29, KeyD.1
unnamed: ESP32-DEVKIT-C (*).37, KeyDown.1
unnamed: ESP32-DEVKIT-C (*).30, KeyE.1
unnamed: ESP32-DEVKIT-C (*).28, KeyEb.1
unnamed: ESP32-DEVKIT-C (*).31, KeyF.1
unnamed: ESP32-DEVKIT-C (*).12, KeyG.1
unnamed: ESP32-DEVKIT-C (*).13, KeyG#.1
unnamed: ESP32-DEVKIT-C (*).27, KeyLowC.1
unnamed: ESP32-DEVKIT-C (*).15, KeyLowC#.1
unnamed: ESP32-DEVKIT-C (*).26, KeyUP.1
unnamed: ESP32-DEVKIT-C (*).1, I2C.2, R2.1, SENSOR.2
unnamed: ESP32-DEVKIT-C (*).33, I2C.3, SENSOR.3
unnamed: ESP32-DEVKIT-C (*).36, I2C.4, SENSOR.4
unnamed: AE-PAM8012.5, SPEAKER (*).1
unnamed: AE-PAM8012.8, SPEAKER (*).2
unnamed: HEADPHONE.2, HEADPHONE.5, VOLUME.2
unnamed: AE-PAM8012.3, HEADPHONE.3, HEADPHONE.4
unnamed: BATTERY (*).1, SW1.2
unnamed: ESP32-DEVKIT-C (*).7, EXT.2
unnamed: R3.2, TRS-MIDI.2
unnamed: R2.2, TRS-MIDI.5
unnamed: ESP32-DEVKIT-C (*).9, R1.1
unnamed: ESP32-DEVKIT-C (*).35, R3.1
