otoone-dev/docs/afuue_project/KiCad/windsynth5_ver1.4/windsynyh5.kicad_pcb

## KiCad design afuue_project/KiCad/windsynth5_ver1.4/windsynyh5.kicad_pcb (2020-06-01, an earlier design)

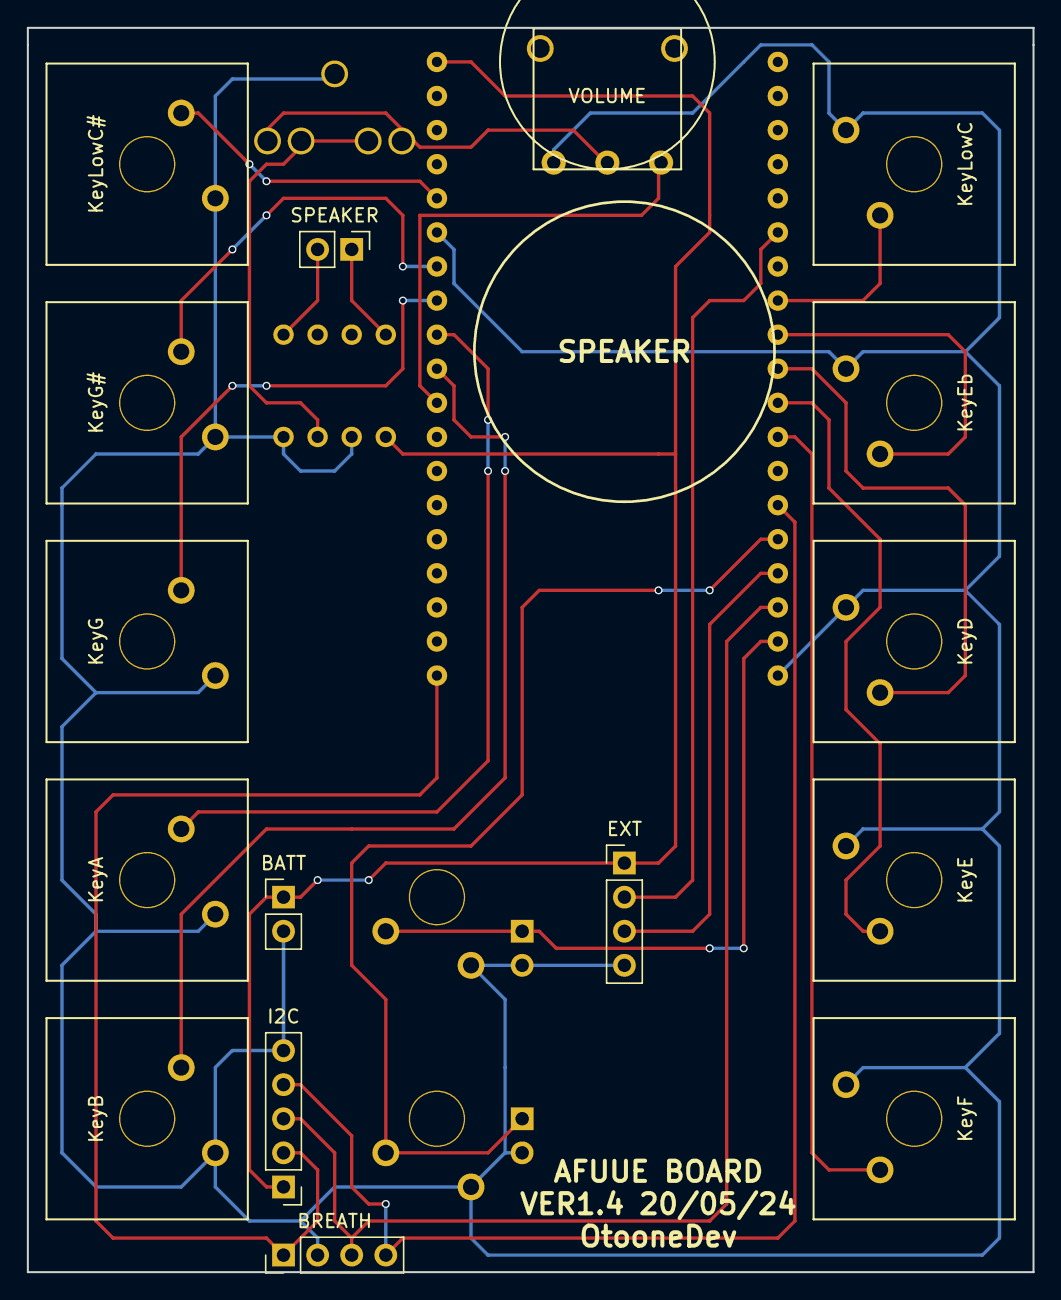
[picture p117: board afuue_project/KiCad/windsynth5_ver1.4/windsynyh5.kicad_pcb from above]

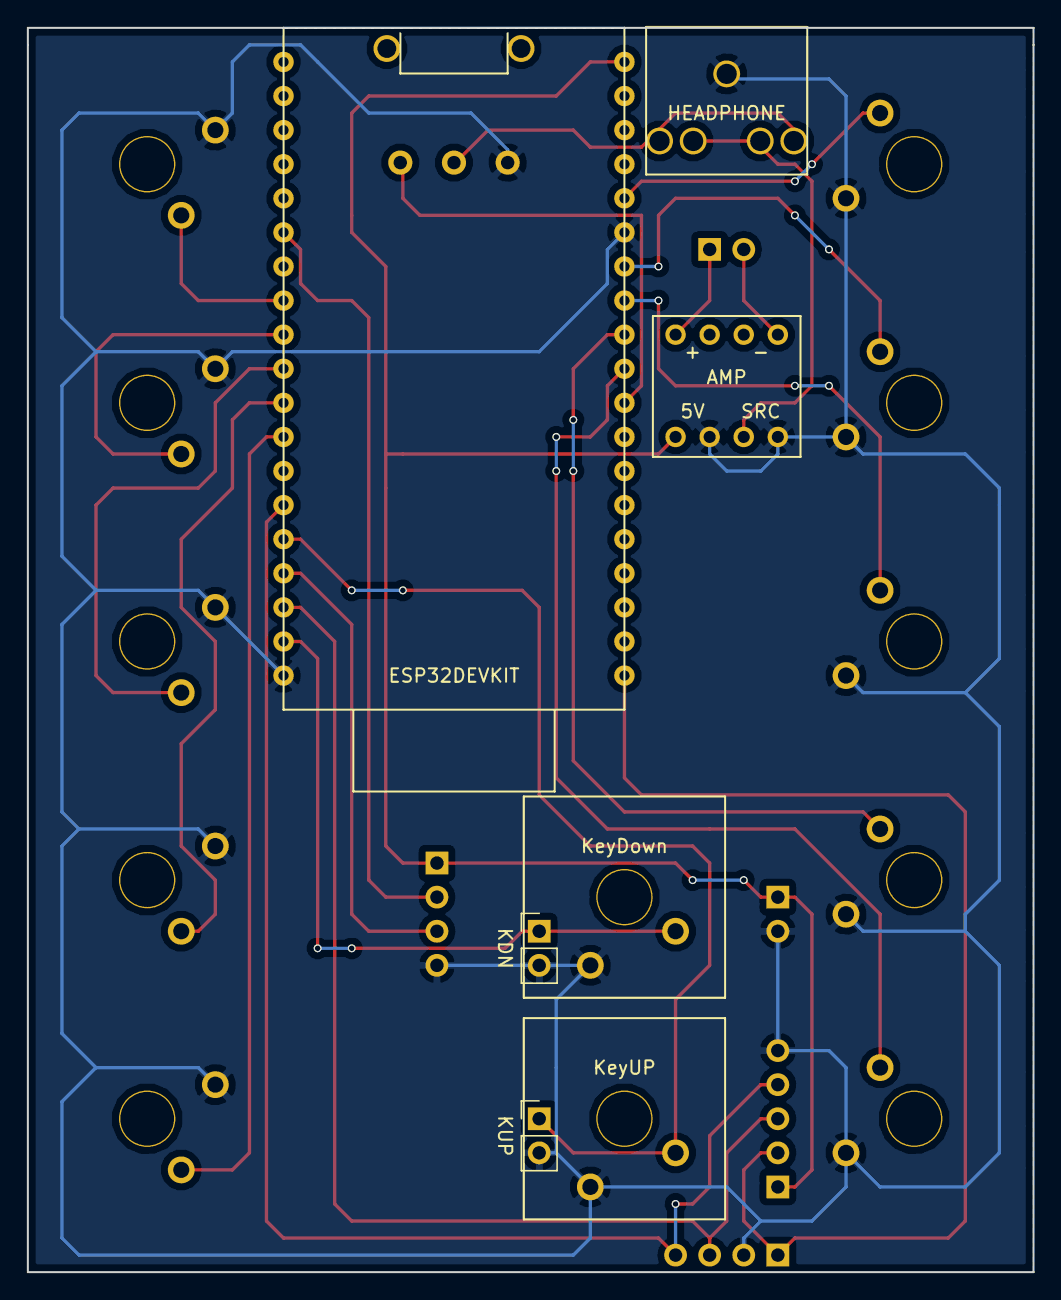
[picture p118: board afuue_project/KiCad/windsynth5_ver1.4/windsynyh5.kicad_pcb from below]

Board: 2 copper layers, 74.9 x 92.7 mm, 23 parts (7 on the bottom side), 24 nets.

Parts:
AMP: AE-PAM8012
BATT: EXT-POWER; Pin_Header_Straight_1x02_Pitch2.54mm
BREATH: SENSOR; Pin_Header_Straight_1x04_Pitch2.54mm
ESP32DEVKIT: ESP32-DEVKIT-C
EXT: EXT; Pin_Header_Straight_1x04_Pitch2.54mm
HEADPHONE: HEADPHONE; PJ-307 AudioJack
I2C: I2C; Pin_Header_Straight_1x05_Pitch2.54mm
KDN: KeyDown2; Pin_Header_Straight_1x02_Pitch2.54mm
KUP: KeyUp2; Pin_Header_Straight_1x02_Pitch2.54mm
KeyA: KeyA; CherryMX-Switch
KeyB: KeyB; CherryMX-Switch
KeyD: KeyD; CherryMX-Switch
KeyDown: KeyDown; CherryMX-Switch
KeyE: KeyE; CherryMX-Switch
KeyEb: KeyEb; CherryMX-Switch
KeyF: KeyF; CherryMX-Switch
KeyG: KeyG; CherryMX-Switch
KeyG#: KeyG#; CherryMX-Switch
KeyLowC: KeyLowC; CherryMX-Switch
KeyLowC#: KeyLowC#; CherryMX-Switch
KeyUP: KeyUp; CherryMX-Switch
SPEAKER: SPEAKER; Pin_Header_Straight_1x02_Pitch2.54mm
VOLUME: POT; R1001-N16

Connections:
+5V: AMP.1, BATT.1, ESP32DEVKIT.19, EXT.1, I2C.1
GND: AMP.2, AMP.4, BATT.2, BREATH.2, ESP32DEVKIT.14, ESP32DEVKIT.38, EXT.4, HEADPHONE.1, I2C.5, KDN.2, KUP.2, KeyA.2, KeyB.2, KeyD.2, KeyDown.2, KeyE.2, KeyEb.2, KeyF.2, KeyG.2, KeyG#.2, KeyLowC.2, KeyLowC#.2, KeyUP.2, VOLUME.1
unnamed: ESP32DEVKIT.11, KeyA.1
unnamed: ESP32DEVKIT.10, KeyB.1
unnamed: ESP32DEVKIT.29, KeyD.1
unnamed: ESP32DEVKIT.37, KDN.1, KeyDown.1
unnamed: ESP32DEVKIT.30, KeyE.1
unnamed: ESP32DEVKIT.28, KeyEb.1
unnamed: ESP32DEVKIT.31, KeyF.1
unnamed: ESP32DEVKIT.12, KeyG.1
unnamed: ESP32DEVKIT.13, KeyG#.1
unnamed: ESP32DEVKIT.27, KeyLowC.1
unnamed: ESP32DEVKIT.15, KeyLowC#.1
unnamed: ESP32DEVKIT.34, KUP.1, KeyUP.1
unnamed: BREATH.1, ESP32DEVKIT.1, I2C.2
unnamed: BREATH.3, ESP32DEVKIT.36, I2C.3
unnamed: BREATH.4, ESP32DEVKIT.33, I2C.4
unnamed: AMP.5, SPEAKER.1
unnamed: AMP.8, SPEAKER.2
unnamed: HEADPHONE.2, HEADPHONE.5, VOLUME.2
unnamed: AMP.3, HEADPHONE.3, HEADPHONE.4
unnamed: ESP32DEVKIT.25, EXT.2
unnamed: ESP32DEVKIT.35, EXT.3
unnamed: ESP32DEVKIT.9, VOLUME.3
