otoone-dev/docs/afuue_project/KiCad/test/test.kicad_pcb

## KiCad design afuue_project/KiCad/test/test.kicad_pcb (2019-05-09)

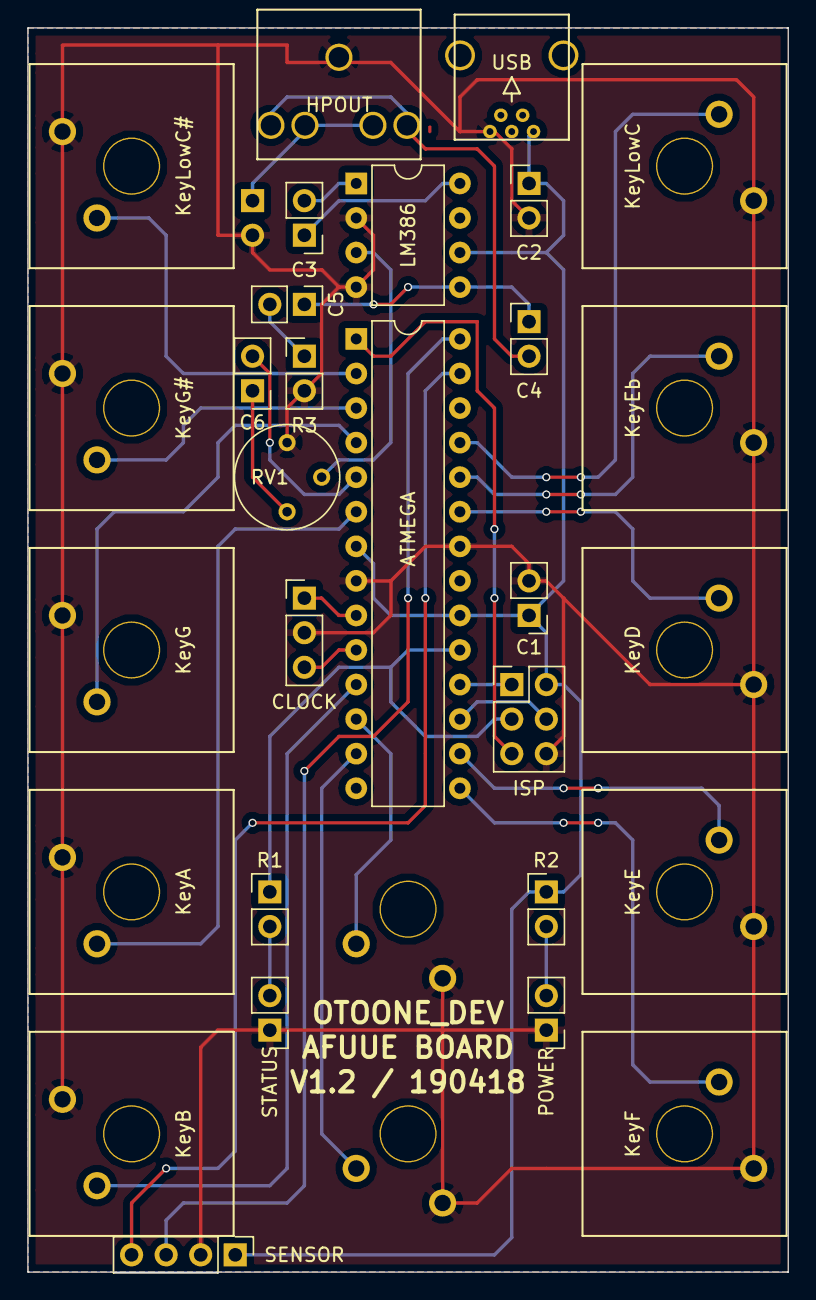
[picture p119: board test.kicad_pcb from above]

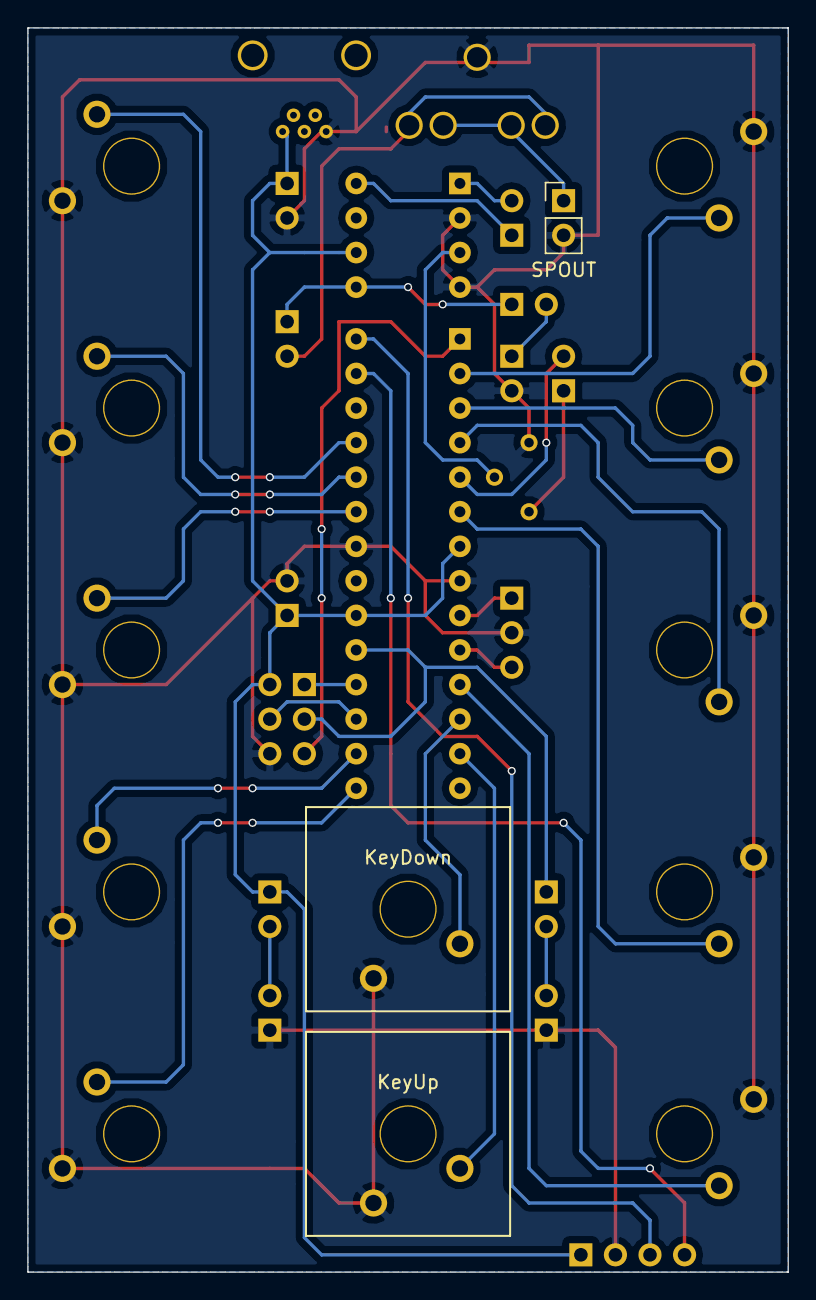
[picture p120: board test.kicad_pcb from below]

Board: 2 copper layers, 55.9 x 91.4 mm, 32 parts (3 on the bottom side), 33 nets.

Parts:
ATMEGA: ATMEGA328-P; DIP-28_W7.62mm
C1, C3, C5, C6: C; Pin_Header_Straight_1x02_Pitch2.54mm
C2, C4: CP1; Pin_Header_Straight_1x02_Pitch2.54mm
CLOCK: CLOCK; Pin_Header_Straight_1x03_Pitch2.54mm
HPOUT: HPOUT; PJ-307 AudioJack
ISP: ISP; Pin_Header_Straight_2x03_Pitch2.54mm
KeyA: KeyA; CherryMX-Switch
KeyB: KeyB; CherryMX-Switch
KeyD: KeyD; CherryMX-Switch
KeyDown: KeyOctDown; CherryMX-Switch
KeyE: KeyE; CherryMX-Switch
KeyEb: KeyEb; CherryMX-Switch
KeyF: KeyF; CherryMX-Switch
KeyG: KeyG; CherryMX-Switch
KeyG#: KeyG#; CherryMX-Switch
KeyLowC: KeyLowC; CherryMX-Switch
KeyLowC#: KeyLowC#; CherryMX-Switch
KeyUp: KeyOctUp; CherryMX-Switch
LM386: LM386; DIP-8_W7.62mm
POWER: LED; Pin_Header_Straight_1x02_Pitch2.54mm
R1, R2, R3: R; Pin_Header_Straight_1x02_Pitch2.54mm
RV1: POT; Potentiometer_Trimmer_Bourns_3339P_Horizontal
SENSOR: BMP180; Pin_Header_Straight_1x04_Pitch2.54mm
SPOUT: SPOUT; Pin_Header_Straight_1x02_Pitch2.54mm
STATUS: LED; Pin_Header_Straight_1x02_Pitch2.54mm
USB: miniUSB; miniUSB(USB32BJ)

Connections:
+5V: ATMEGA.7, ATMEGA.20, C1.1, C2.1, ISP.2, LM386.6, R2.1, SENSOR.1, USB.1
GND: ATMEGA.8, ATMEGA.22, C1.2, C2.2, CLOCK.2, HPOUT.1, ISP.6, KeyA.2, KeyB.2, KeyD.2, KeyDown.2, KeyE.2, KeyEb.2, KeyF.2, KeyG.2, KeyG#.2, KeyLowC.2, KeyLowC#.2, KeyUp.2, LM386.2, LM386.4, POWER.1, R3.2, RV1.1, SENSOR.2, SPOUT.2, STATUS.1, USB.5
unnamed: C3.1, LM386.8
unnamed: C3.2, LM386.1
unnamed: C4.1, C5.1, LM386.5
unnamed: C4.2, HPOUT.2, HPOUT.5
unnamed: C5.2, R3.1
unnamed: C6.1, RV1.3
unnamed: ATMEGA.5, C6.2
unnamed: ATMEGA.9, CLOCK.1
unnamed: ATMEGA.10, CLOCK.3
unnamed: HPOUT.3, HPOUT.4, SPOUT.1
unnamed: ATMEGA.1, ISP.5
unnamed: ATMEGA.2, KeyLowC#.1
unnamed: ATMEGA.3, KeyG#.1
unnamed: ATMEGA.4, KeyG.1
unnamed: ATMEGA.6, KeyA.1
unnamed: ATMEGA.11, KeyB.1
unnamed: ATMEGA.12, KeyDown.1
unnamed: ATMEGA.13, KeyUp.1
unnamed: ATMEGA.15, KeyF.1
unnamed: ATMEGA.16, KeyE.1
unnamed: ATMEGA.17, ISP.4
unnamed: ATMEGA.18, ISP.1
unnamed: ATMEGA.19, ISP.3, R1.1
unnamed: ATMEGA.23, KeyD.1
unnamed: ATMEGA.24, KeyEb.1
unnamed: ATMEGA.25, KeyLowC.1
unnamed: ATMEGA.27, SENSOR.4
unnamed: ATMEGA.28, SENSOR.3
unnamed: POWER.2, R2.2
unnamed: R1.2, STATUS.2
unnamed: LM386.3, RV1.2
