otoone-dev/docs/afuue_project/Arduino/WIndSynth5_esp32/WindSynth5_esp32.ino

#include <Wire.h>

#define BMP180_ADDR 0x77 // 7-bit address
#define BMP180_REG_CONTROL 0xF4
#define BMP180_REG_RESULT 0xF6
#define BMP180_COMMAND_TEMPERATURE 0x2E
#define BMP180_COMMAND_PRESSURE0 0x34
#define BMP180_COMMAND_PRESSURE1 0x74
#define BMP180_COMMAND_PRESSURE2 0xB4
#define BMP180_COMMAND_PRESSURE3 0xF4
#define TEMP_RATE (-0.55f)

static char _error;

hw_timer_t * timer = NULL;
volatile SemaphoreHandle_t timerSemaphore;
volatile int interruptCounter = 0;
portMUX_TYPE timerMux = portMUX_INITIALIZER_UNLOCKED;
int count = 0;

static uint8_t initCnt = 100;

static uint32_t defPressure = 0;
static uint32_t defTemperature = 0;

#define fs (40000.0)
static double ftt = 0.0;
volatile double fst = 0.0;
volatile double volReq = 0.0;
volatile double shift = 0.0;

static double vol = 0.0;
static double pitch = 0.0;

static int currentNote = 60;
static int baseNote = 0;
static byte toneNo = 0;

#define NOTE_BUFFER_SIZE (4)
static int noteBuffer[NOTE_BUFFER_SIZE];
static int notePos = 0;

//---------------------------------
char readBytes(unsigned char *values, char length)
// Read an array of bytes from device
// values: external array to hold data. Put starting register in values[0].
// length: number of bytes to read
{
  char x;

  Wire.beginTransmission(BMP180_ADDR);
  Wire.write(values[0]);
  _error = Wire.endTransmission();
  if (_error == 0)
  {
    Wire.requestFrom(BMP180_ADDR,length);
    while(Wire.available() != length) ; // wait until bytes are ready
    for(x=0;x<length;x++)
    {
      values[x] = Wire.read();
    }
    return(1);
  }
  return(0);
}

//---------------------------------
char readInt(char address, int16_t &value)
{
  unsigned char data[2];

  data[0] = address;
  if (readBytes(data,2))
  {
    value = (int16_t)((data[0]<<8)|data[1]);
    //if (*value & 0x8000) *value |= 0xFFFF0000; // sign extend if negative
    return(1);
  }
  value = 0;
  return(0);
}
char readUInt(char address, uint16_t &value) {
  unsigned char data[2];

  data[0] = address;
  if (readBytes(data,2))
  {
    value = (uint16_t)((data[0]<<8)|data[1]);
    //if (*value & 0x8000) *value |= 0xFFFF0000; // sign extend if negative
    return(1);
  }
  value = 0;
  return(0);
}

//---------------------------------
char writeBytes(unsigned char *values, char length)
{
  char x;
  
  Wire.beginTransmission(BMP180_ADDR);
  Wire.write(values,length);
  _error = Wire.endTransmission();
  if (_error == 0)
    return(1);
  else
    return(0);
}

//---------------------------------
uint16_t getPressure() {  // 16bit unsigned
  unsigned char wdata[2] = { BMP180_REG_CONTROL, BMP180_COMMAND_PRESSURE0 };
  if (writeBytes(wdata, 2)) {
    delay(5);
    unsigned char rdata[3] = { BMP180_REG_RESULT, 0, 0 };
    if (readBytes(rdata, 3)) {
      return (((uint16_t)rdata[0]) << 8) | (uint16_t)rdata[1];
    }
  }
  return 0;
}

//---------------------------------
int16_t getTemperature() {  // 16bit singed
  unsigned char wdata[2] = { BMP180_REG_CONTROL, BMP180_COMMAND_TEMPERATURE };
  if (writeBytes(wdata, 2)) {
    delay(5);
    unsigned char rdata[2] = { BMP180_REG_RESULT, 0 };
    if (readBytes(rdata, 2)) {
      return (int16_t)((((uint16_t)rdata[0]) << 8) | (uint16_t)rdata[1]);
    }
  }
  return 0;
}


//---------------------------------
int getNoteNumber() {
  bool keyLowC = digitalRead(16);
  bool keyEb = digitalRead(17);
  bool keyD = digitalRead(5);
  bool keyE = digitalRead(18);
  bool keyF = digitalRead(19);
  bool keyLowCs = digitalRead(13);
  bool keyGs =digitalRead(12);
  bool keyG = digitalRead(14);
  bool keyA = digitalRead(27);
  bool keyB = digitalRead(26);
  bool octDown = digitalRead(23);
  bool octUp = digitalRead(3);

  int bnote = 0;
  if (keyA == LOW) bnote = 1;
  if (keyB == LOW) bnote |= 2;   // 0x00:C#, 0x01:C, 0x02:B, (0x03:A)
  if (bnote == 3) bnote = 4;

  int note = baseNote - bnote;
  
  if ((bnote == 1) && (keyG == LOW)) note += 9;  // +12-3
  if (keyG == LOW) note -= 2;
  if (keyGs == LOW) note++;
  if (keyF == LOW) note -= 2;
  if (keyE == LOW) note--;
  if (keyD == LOW) note -= 2;
  if (keyEb == LOW) note++;
  if (keyLowC == LOW) note -=2;
  if (keyLowCs == LOW) note--;

  if (octDown == LOW) note -= 12;
  if (octUp == LOW) note += 12;
  
  return note;
}

//--------------------------
double CalcInvFrequency(double note) {
  return 440.0 * pow(2, (note - (69-12))/12);
}

//---------------------------------
void loop() {
  int32_t tmp = getTemperature() - defTemperature;
  uint32_t prsZero = 10 + defPressure + (uint32_t)(tmp * TEMP_RATE);
  uint32_t prs = getPressure();
  int32_t p = 0;
  if (prs > prsZero) p = (int32_t)(prs - prsZero);

  const int maxPressure = 400;
  if (p > maxPressure) p = maxPressure;
  double pp = p / (double)maxPressure;
  if (pp > 1.0) pp = 1.0;
  if (initCnt > 0) {
    initCnt--;
    pp = 0.2;
    currentNote = 69;
    ftt = CalcInvFrequency(currentNote + pitch);
  } else {
     int note = getNoteNumber();
     noteBuffer[notePos] = note;
     notePos = (notePos + 1) % NOTE_BUFFER_SIZE;
     bool updateFlag = true;
     for (int i = 1; i < NOTE_BUFFER_SIZE; i++) {
       if (noteBuffer[0] != noteBuffer[i]) {
         updateFlag = false;
         break;
       }
     }
     if (updateFlag) {
       if (currentNote != note) {
         vol *= 0.8;
       }
       currentNote = note;
     }
  }
  
  double ppReq = pp*pp;

#if 0
  {
  bool octDown = digitalRead(3);
  bool octUp = digitalRead(23);
    if ((octDown == false) && (octUp == false)) {
      ppReq = 1.0;
    }
  }
#endif
  if (ppReq > vol) {
    vol += (ppReq - vol) * 0.5;
  } else {
    vol += (ppReq - vol) * 0.9;
  }
  volReq = vol;

  //pitch = 0;
  //if (vol < 0.2) pitch = -(0.2-vol);
  if (vol < 0.01) shift = 0.0;
  else {
    if (shift < 1.0) shift += 0.1;
    else shift = 1.0;
  }

  double ft = CalcInvFrequency(currentNote + pitch);
  ftt += (ft - ftt) * 0.999;
  fst = (ftt / fs);
  ledcWrite(0, (uint8_t)(volReq * 255));

  //if (xSemaphoreTake(timerSemaphore, 0) == pdTRUE){
  if (interruptCounter > 0) {
    portENTER_CRITICAL(&timerMux);
    {
        interruptCounter--;
    }
    portEXIT_CRITICAL(&timerMux);
  }
#if 0
    char s[32];
    sprintf(s, "note %d", currentNote);
    Serial.println(s);
    delay(200);
#endif
    delay(1);
}

volatile double phase = 0.0;
//volatile double phase2 = 0.0;
//volatile double phase3 = 0.0;
#define REVERB_BUFFER_SIZE (9801)
#define REVERB_RATE (0.152)
volatile double reverbBuffer[REVERB_BUFFER_SIZE];
volatile int reverbPos = 0;

volatile short waveA[256];

volatile short wave[256];

const short waveWSynth[256] = {
    -11947,-14483,-17018,-19554,-22090,-24625,-26859,-27731,
    -28604,-29476,-30348,-31221,-31703,-31501,-31300,-31099,
    -30897,-30696,-30352,-29891,-29429,-28967,-28506,-28044,
    -27548,-27038,-26529,-26019,-25510,-25001,-24497,-23994,
    -23492,-22989,-22486,-21991,-21569,-21148,-20727,-20306,
    -19884,-19462,-19036,-18610,-18184,-17758,-17332,-16876,
    -16385,-15893,-15402,-14910,-14419,-13958,-13515,-13072,
    -12629,-12185,-11742,-11424,-11133,-10842,-10551,-10261,
    -9970,-9767,-9564,-9362,-9159,-8956,-8751,-8533,
    -8315,-8097,-7879,-7661,-7435,-7196,-6956,-6716,
    -6476,-6236,-5994,-5751,-5507,-5263,-5019,-4776,
    -4554,-4342,-4129,-3917,-3704,-3491,-3320,-3153,
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
  125,1146,1659,2426,3701,4722,6251,8541,10831,14899,17950,14145,11862,10595,8313,7807,
  6541,5527,4514,3755,3251,2492,2241,1735,1484,1233,981,728,603,477,225,227,
  102,-24,-22,-148,-273,-144,-17,-16,493,368,242,244,118,-8,-6,-4,
};

const short waveHamoA[256] = {
  -1669,-1304,-786,491,-606,1389,-1574,-2226,-2499,-2598,-1319,-3199,-6414,-4957,-3371,-5106,
  -6688,-7360,-8777,-12097,-12891,-14802,-15649,-16772,-17714,-16303,-14288,-9624,-9244,-10992,-6314,-6154,
  -6024,-4605,-4790,-3315,-4721,-5731,-3388,-2659,-3156,-1824,-2036,-1803,-310,-1315,-419,631,
  -34,-3787,-2586,-2176,40,-1340,1413,3485,2840,2899,1744,1482,2902,1837,4063,3716,
  5818,2196,2613,3151,5869,8958,8535,9545,10467,13178,12379,15469,19122,24203,22846,19777,
  18280,14012,14470,11005,11733,12025,11053,8393,7770,6518,4025,5937,6897,3258,4070,5521,
  6966,4367,6305,4148,1348,2327,1765,3280,2601,1025,60,1659,479,3565,-509,368,
  289,-1853,-1243,-1170,-526,3571,569,165,-367,-2262,247,-441,705,1547,1065,-3076,
  -1910,-1719,-2593,-2085,-1547,-1750,-2571,-4110,-1822,-3326,-4466,-2637,-7391,-4559,-5282,-3846,
  -1888,-6695,-6695,-5610,-7480,-6855,-10309,-9208,-10318,-11552,-13288,-15043,-16137,-15719,-16982,-17731,
  -22735,-24748,-21763,-25447,-27338,-25954,-24908,-23569,-22248,-19193,-16778,-17627,-15321,-12107,-10929,-10145,
  -8766,-10034,-11560,-7522,-8714,-4017,-3747,-5168,-6730,-5168,-5019,-5293,-5469,-6632,-4922,-4618,
  -3498,-5303,-3381,124,-856,-3549,-3757,-3722,-1204,63,-615,-3074,-2351,-3184,1713,546,
  1797,-1081,-1205,3511,4252,5219,4667,8142,9515,13053,12640,13582,11670,9882,9271,3870,
  3950,4897,5193,3772,2453,1736,3467,-529,-889,996,-1577,-901,1783,240,-1485,-2164,
  -91,-653,-591,147,1073,-2424,291,-1091,135,749,1848,985,1593,-918,410,-910,
};

//---------------------------------
double SawWave(double p) {
  return -1.0 + 2 * p;
}

double Voice(double p) {
  double v = 255*p;
  int t = (int)v;
  double f = (v - t);
  double w0 = (wave[t] * shift + waveA[t] * (1-shift));
  t = (t + 1) % 256;
  double w1 = (wave[t] * shift + waveA[t] * (1-shift));
  double w = (w1 * f) + (w0 * (1-f));
  return (w / 32767.0);
}

//---------------------------------
uint8_t CreateWave() {
    // double 演算で波形のフェーズを 0-255 で算出する
    phase += fst;
    if (phase >= 1.0) phase -= 1.0;

    // 波形を生成する
    double e = (127 * Voice(phase) * volReq) + reverbBuffer[reverbPos];// + phase2 * volReq2 + phase3 * volReq3;
    if ( (e < 0.2) && (e > -0.2) ) {
      e = 0.0;
    }
    reverbBuffer[reverbPos] = e * REVERB_RATE;
    reverbPos = (reverbPos + 1) % REVERB_BUFFER_SIZE;
    
    if (e < -127.0) e = -127.0;
    if (e > 127.0) e = 127.0;
  
    uint8_t dac = (uint8_t)(e + 127);
    return dac;
}
//---------------------------------
void IRAM_ATTR onTimer(){
  // Increment the counter and set the time of ISR
  portENTER_CRITICAL_ISR(&timerMux);
  {
    uint8_t dac = CreateWave();
    dacWrite(DAC1, dac);
    interruptCounter++;
  }
  portEXIT_CRITICAL_ISR(&timerMux);
  //xSemaphoreGiveFromISR(timerSemaphore, NULL);
}

//---------------------------------
void setup() {
  Serial.begin(115200);
  Serial.println("------");

  Wire.begin();
  Serial.println("wire begin");

  ledcSetup(0, 12800, 8);
  ledcAttachPin(A12, 0);

  ledcWrite(0, 255);
  delay(500);
  ledcWrite(0, 40);
  delay(500);

  const int portList[12] = { 13, 12, 14, 27, 26, 16, 17, 5,18, 19, 23, 3 };
  for (int i = 0; i < 12; i++) {
    pinMode(portList[i], INPUT_PULLUP);
  }
  baseNote = 49 + 12; // C (C#)
  bool keyLowC = digitalRead(16);
  bool keyEb = digitalRead(17);
  bool keyD = digitalRead(5);
  bool keyE = digitalRead(18);
  bool keyF = digitalRead(19);
  bool keyLowCs = digitalRead(13);
  bool keyGs =digitalRead(12);
  bool keyG = digitalRead(14);
  bool keyA = digitalRead(27);
  bool keyB = digitalRead(26);
  bool octDown = digitalRead(3);
  bool octUp = digitalRead(23);
  
  if ((octDown == LOW)&&(octUp == LOW)) {
    baseNote = 49 + 12 + 12; // Hi-C (Hi-C#)
  }
  else if (octDown == LOW) {
    baseNote = 47 + 12; // Bb (B)
  }
  else if (octUp == LOW) {
    baseNote = 52 + 12; // Eb (E)
  }
  if ((keyLowC == LOW) && (keyEb == HIGH)) {
    baseNote -= 12;
  } else if ((keyLowC == HIGH) && (keyEb == LOW)) {
    baseNote += 12;
  }
  if ((keyLowCs == HIGH) && (keyGs == HIGH) && (keyG == HIGH) && (keyA == HIGH) && (keyB == LOW)) {
    for (int i = 0; i < 256; i++) wave[i] = waveCla[i];
    for (int i = 0; i < 256; i++) waveA[i] = waveCla[i];
  }
  else if ((keyLowCs == HIGH) && (keyGs == HIGH) && (keyG == HIGH) && (keyA == LOW) && (keyB == HIGH)) {
    for (int i = 0; i < 256; i++) wave[i] = waveOboe[i];
    for (int i = 0; i < 256; i++) waveA[i] = waveOboeA[i];
  }
  else if ((keyLowCs == HIGH) && (keyGs == HIGH) && (keyG == LOW) && (keyA == HIGH) && (keyB == HIGH)) {
    for (int i = 0; i < 256; i++) wave[i] = waveHamo[i];
    for (int i = 0; i < 256; i++) waveA[i] = waveHamoA[i];
  }
  else if ((keyLowCs == HIGH) && (keyGs == LOW) && (keyG == HIGH) && (keyA == HIGH) && (keyB == HIGH)) {
    for (int i = 0; i < 256; i++) wave[i] = (i*235)-30000;
    for (int i = 0; i < 256; i++) waveA[i] = wave[i];
  }
  else if ((keyLowCs == LOW) && (keyGs == HIGH) && (keyG == HIGH) && (keyA == HIGH) && (keyB == HIGH)) {
    for (int i = 0; i < 256; i++) wave[i] = (i/128)*60000-30000;
    for (int i = 0; i < 256; i++) waveA[i] = wave[i];
  }
  else {
    for (int i = 0; i < 256; i++) wave[i] = waveWSynth[i];
    for (int i = 0; i < 256; i++) waveA[i] = waveWSynth[i];
  }


  
  Serial.println(baseNote);

  defPressure = getPressure();
  delay(100);
  defTemperature = getTemperature();

  ledcWrite(0, 255);
  delay(500);
  ledcWrite(0, 0);
  delay(500);

  for (int i = 0; i < REVERB_BUFFER_SIZE; i++) {
    reverbBuffer[i] = 0.0;
  }
  for (int i = 0; i < NOTE_BUFFER_SIZE; i++) {
    noteBuffer[i] = 1;
  }
    timerSemaphore = xSemaphoreCreateBinary();
  // Use 1st timer of 4 (counted from zero).
  // Set 80 divider for prescaler (see ESP32 Technical Reference Manual for more
  // info).
  timer = timerBegin(0, 80, true);  // 1us increment
  timerAttachInterrupt(timer, &onTimer, true);
  // Set alarm to call onTimer function every second (value in microseconds).
  // Repeat the alarm (third parameter)
  //timerAlarmWrite(timer, 300*1000, true);
  timerAlarmWrite(timer, 25, true); //40kHz
  timerAlarmEnable(timer);
  Serial.println("timer begin");

  Serial.println("setup done");
}
