otoone-dev/docs/arduino/M5AtomS3/atoms3_createwavetime/atoms3_createwavetime.ino

#include <M5Unified.h>
#include <cfloat>
#include <driver/adc.h>

const double sinTable[256] = {
0.000000,0.024541,0.049068,0.073565,0.098017,0.122411,0.146730,0.170962,0.195090,0.219101,0.242980,0.266713,0.290285,0.313682,0.336890,0.359895,
0.382683,0.405241,0.427555,0.449611,0.471397,0.492898,0.514103,0.534998,0.555570,0.575808,0.595699,0.615232,0.634393,0.653173,0.671559,0.689541,
0.707107,0.724247,0.740951,0.757209,0.773010,0.788346,0.803208,0.817585,0.831470,0.844854,0.857729,0.870087,0.881921,0.893224,0.903989,0.914210,
0.923880,0.932993,0.941544,0.949528,0.956940,0.963776,0.970031,0.975702,0.980785,0.985278,0.989177,0.992480,0.995185,0.997290,0.998795,0.999699,
1.000000,0.999699,0.998795,0.997290,0.995185,0.992480,0.989177,0.985278,0.980785,0.975702,0.970031,0.963776,0.956940,0.949528,0.941544,0.932993,
0.923880,0.914210,0.903989,0.893224,0.881921,0.870087,0.857729,0.844854,0.831470,0.817585,0.803208,0.788346,0.773010,0.757209,0.740951,0.724247,
0.707107,0.689541,0.671559,0.653173,0.634393,0.615232,0.595699,0.575808,0.555570,0.534997,0.514103,0.492898,0.471397,0.449611,0.427555,0.405241,
0.382683,0.359895,0.336890,0.313682,0.290285,0.266713,0.242980,0.219101,0.195090,0.170962,0.146730,0.122411,0.098017,0.073564,0.049067,0.024541,
-0.000000,-0.024541,-0.049068,-0.073565,-0.098017,-0.122411,-0.146730,-0.170962,-0.195090,-0.219101,-0.242980,-0.266713,-0.290285,-0.313682,-0.336890,-0.359895,
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
}

//---------------------------------
double InteropL(volatile const double* table, int tableCount, double p) {
  double v = (tableCount - DBL_MIN) *p;
  int t = (int)v;
  v -= t;
  double w0 = table[t];
  t = (t + 1) % tableCount;
  double w1 = table[t];
  return (w0 * (1.0 - v)) + (w1 * v);
}

//-------------------------------------
#define SAMPLING_RATE (25000.0f)
double LowPass(double value, double freq, double idq) {
	// フィルタ計算用のバッファ変数。
	static double in1  = 0.0;
	static double in2  = 0.0;
	static double out1 = 0.0;
	static double out2 = 0.0;

  //double lp = b0/a0 * value + b1/a0 * in1  + b2/a0 * in2 - a1/a0 * out1 - a2/a0 * out2;
  float lp = (lp_b0 * value + lp_b1 * in1  + lp_b2 * in2 - lp_a1 * out1 - lp_a2 * out2) / lp_a0;

  in2  = in1;
  in1  = value;
  out2 = out1;
  out1 = lp;
  return lp;
}

//-------------------------------------
uint16_t CreateWave() {
    // 波形を生成する
    phase += currentWavelengthTickCount;
    if (phase >= 1.0) phase -= 1.0;

    double g = InteropL(waveTable, 256, phase) / 32767.0;

    if (lowPassQ > 0.0) {
      g = LowPass(g, lowPassValue, lowPassIDQ);
    }

    double e = (32767.0 * g * requestedVolume) + delayBuffer[delayPos];;

    delayBuffer[delayPos] = e * 0.95;
    delayPos = (delayPos + 1) % DELAY_BUFFER_SIZE;

    if (e < -32700.0) e = -32700.0;
    else if (e > 32700.0) e = 32700.0;

    return (uint16_t)(e + 32767.0);
}

//--------------------------
float CalcFrequency(float note) {
  return 440.0f * pow(2.0f, (note - (69.0f - 12.0f)) / 12.0f);
}

//-------------------------------------
void loop() {
  // put your main code here, to run repeatedly:
  float wavelength = CalcFrequency(60.0f);
  currentWavelengthTickCount = (wavelength / SAMPLING_RATE);
      float omega = lowPassValue / SAMPLING_RATE;
      float alpha = InteropL(sinTable, 1024, omega) * lowPassIDQ;
      float cosv = InteropL(sinTable, 1024, omega + 0.25f);
      float one_minus_cosv = 1.0f - cosv;
      lp_a0 =  1.0f + alpha;
      lp_a1 = -2.0f * cosv;
      lp_a2 =  1.0f - alpha;
      lp_b0 = one_minus_cosv * 0.5f;
      lp_b1 = one_minus_cosv;
      lp_b2 = lp_b0;

  unsigned long t0 = micros();
  for (int i = 0; i < 100; i++) {
    //CreateWave();
    int ana = adc1_get_raw(ADC1_CHANNEL_0);
  }
  float td = static_cast<int>(micros() - t0) / 100.0f;

  canvas.fillScreen(BLACK);
  char s[32];
  sprintf(s, "%1.2f us", td);
  //sprintf(s, "%d", ana);
  canvas.drawString(s, 10, 10, 2);

  canvas.pushSprite(0, 0);

  delay(16);
}
