otoone-dev/docs/afuue_project/Arduino/AFUUE_v09_2pwm/afuue.cpp

#include "afuue.h"
#include "afuue_midi.h"

// タイマー割り込み用
portMUX_TYPE timerMux = portMUX_INITIALIZER_UNLOCKED;
#define QUEUE_LENGTH 1
TaskHandle_t taskHandle;

//---------------------------------
void Afuue::Initialize() {
#ifdef USE_SERIALOUTPUT
  Serial.begin(115200);
  SerialPrintLn("------");
#endif

#ifdef USE_MIDI
  SerialPrintLn("Initialize MIDI...");
  delay(100);
  menu.isUSBMidiMounted = afuueMidi.Initialize();
  if (menu.isUSBMidiMounted) {
    menu.isMidiEnabled = true;
  }
  SerialPrintLn("MIDI Initialize done.");
#endif

  SerialPrintLn("Initialize Key...");
  delay(100);
#ifdef HAS_DISPLAY
  M5.Lcd.setBrightness(255);
  M5.Lcd.setRotation(0);
  M5.Lcd.fillScreen(TFT_WHITE);
  pinMode(LEDPIN, OUTPUT);
  digitalWrite(LEDPIN, HIGH);
  delay(300);
  digitalWrite(LEDPIN, LOW);
  delay(300);
  digitalWrite(LEDPIN, HIGH);
  M5.Lcd.fillScreen(TFT_BLACK);
  M5.Lcd.setTextColor(TFT_WHITE, TFT_BLACK);
  M5.Lcd.setTextSize(1);
  M5.Lcd.setBrightness(127);
#endif // HAS_DISPLAY

#ifdef NEOPIXEL_PIN
  SetLedColor(10, 10, 10);
  delay(300);
  SetLedColor(0, 0, 0);
  delay(300);
#endif

#if defined(I2CPIN_SDA) || defined(I2CPIN_SCL)
  Wire.begin(I2CPIN_SDA, I2CPIN_SCL);
#else
  Wire.begin();
#endif
  SerialPrintLn("wire begin");

  int keyInitResult = key.Initialize();

  bool i2cError = false;
#ifdef HAS_DISPLAY
  M5.Lcd.fillScreen(TFT_BLACK);
#ifdef HAS_IOEXPANDER
  M5.Lcd.setCursor(10, 10);
  DrawCenterString("Check IOExpander...", 67, 80, 2);
  if (keyInitResult < 0) {
    char s[16];
    sprintf(s, "[ NG ] %d", keyInitResult);
    DrawCenterString(s, 67, 95, 2);
    i2cError = true;
  }
#endif
#endif
  SerialPrintLn("key begin");

  DrawCenterString("Check BrthSensor...", 67, 120, 2);
  int32_t sensorRet = sensors.Initialize();
  if (sensorRet != 0) {
    DrawCenterString("[ NG ]", 67, 135, 2);
    i2cError = true;
  }

  if (i2cError) {
    for(;;) {
#ifdef LEDPIN
      for (int i = 0; i < sensorRet; i++) {
        digitalWrite(LEDPIN, HIGH);
        delay(200);
        digitalWrite(LEDPIN, LOW);
        delay(200);
      }
      delay(1000);
#endif
#ifdef NEOPIXEL_PIN
      for (int i = 0; i < sensorRet; i++) {
        SetLedColor(60, 30, 0);
        delay(200);
        SetLedColor(10, 5, 0);
        delay(200);
      }
      delay(1000);
#endif
      delay(500);
    }
  }

  SerialPrintLn("pressure sensor begin");

  menu.Initialize();

  GetMenuParams();
  SerialPrintLn("menu begin");

  generator.Initialize(menu);
  SerialPrintLn("wave generator begin");

  SerialPrintLn("setup done");

#ifdef HAS_DISPLAY
  M5.Lcd.fillScreen(TFT_BLACK);
  menu.Display();
#endif
#if defined(LEDPIN) && (MAINUNIT == M5ATOM_S3)
  ledcSetup(5, 156250, 8);
  ledcAttachPin(LEDPIN, 5);
  ledcWrite(5, 0);
#endif

  if (!menu.isUSBMidiMounted) {
    xQueue = xQueueCreate(QUEUE_LENGTH, sizeof(int8_t));
    xTaskCreatePinnedToCore(CreateWaveTask, "createWaveTask", 16384, this, configMAX_PRIORITIES-1, &taskHandle, CORE0); // 波形生成は Core0 が専念

    timer = timerBegin(0, CLOCK_DIVIDER, true); // ISR は Core1 で波形生成のタイミングと PWM への更新だけ行う
    timerAttachInterrupt(timer, &OnTimer, false);
    timerAlarmWrite(timer, TIMER_ALARM, true);
    timerAlarmEnable(timer);
    SerialPrintLn("timer begin");
    menu.SetTimer(timer);
  }

  xTaskCreatePinnedToCore(UpdateTask, "UpdateTask", 2048, this, 2, NULL, CORE1);
  xTaskCreatePinnedToCore(MenuTask, "MenuTask", 4096, this, 1, NULL, CORE1);

  enablePlay = true;
}

//-------------------------------------
void Afuue::Loop() {
  // Arduino Runs On 設定で Core1 動作
  delay(5000);
}

//-------------------------------------
void Afuue::GetMenuParams() {

  waveInfo.ApplyFromWaveSettings(menu.currentWaveSettings);

  attackNoiseLevel = menu.waveData.GetWaveAttackNoiseLevel(menu.waveIndex);
  keySenseTimeMs = menu.keySense;
  generator.drumVolume = menu.drumVolume / 10.0f;
  sensors.breathSenseRate = menu.breathSense;
  sensors.breathZero = menu.breathZero;
  sensors.isLipSensorEnabled = menu.isLipSensorEnabled;
}

//-------------------------------------
void Afuue::Update(float td) {
  float reqVolume = generator.requestedVolume;
#ifdef USE_MIDI
  if (menu.isMidiEnabled) {
    afuueMidi.Update((int)currentNote, reqVolume, sensors.isLipSensorEnabled, sensors.bendNoteShift + volumeDropNoteShift);
  } else
#endif
  {
    // ノイズ
    if (reqVolume < 0.001f) {
      noteOnTimeMs = 0.0f;
      noteOnAccX = sensors.accx;
      noteOnAccY = sensors.accy;
      noteOnAccZ = sensors.accz;
    }
    else {
      noteOnTimeMs += td;
    }
    float n = (ATTACKNOISETIME_LENGTH - noteOnTimeMs) / ATTACKNOISETIME_LENGTH;
    if (n < 0.0f) n = 0.0f;
    if (n > 1.0f) n = 1.0f;
    generator.noiseVolume = n * attackNoiseLevel;

    generator.Tick(currentNote + sensors.bendNoteShift + volumeDropNoteShift, td);
  }
}

//-------------------------------------
void Afuue::Control(float td) {
  //キー、気圧センサー、加速度センサー
  sensors.UpdateAcc();
  sensors.Update();
  float blow = sensors.GetBlowPower();
  sensors.BendExec(td, blow, key.IsBendKeysDown());
  key.UpdateKeys(sensors.exKeys);

  float n = key.GetNoteNumber(waveInfo.baseNote);
  if (forcePlayTime > 0.0f) {
    generator.requestedVolume = 0.1f;
    forcePlayTime -= td;
  } else {
    generator.requestedVolume += (blow - generator.requestedVolume) * (1.0f - waveInfo.attackSoftness);
    if (targetNote != n) {
      keyTimeMs = 0.0f;
      startNote = currentNote;
      targetNote = n;
    }
  }
  if (generator.requestedVolume < 0.001f) {
    currentNote = targetNote;
    keyTimeMs = 1000.0f;
  }

  if (waveInfo.pitchDropPos > 0.0f && generator.requestedVolume < waveInfo.pitchDropPos) {
    // 音量によるピッチダウン
    volumeDropNoteShift = (1.0f-(generator.requestedVolume / waveInfo.pitchDropPos)) * waveInfo.pitchDropLevel;
  }
  else {
    volumeDropNoteShift = 0.0f;
  }

#ifdef HAS_IMU
  if (generator.drumVolume > 0.0f) {
    if (generator.drum_mode == 0 || generator.drum_mode == 2) {
      if (sensors.accx > 0.5f) {
        if (generator.drum_pos[1] <= 0.0f) {
          generator.drum_pos[1] = 1.0f;
          generator.drum_mode = 1;
        }
      }
    }
    if (generator.drum_mode == 0 || generator.drum_mode == 1) {
      if (sensors.accx < -0.5f) {
        if (generator.drum_pos[0] <= 0.0f) {
          generator.drum_pos[0] = 1.0f;
          generator.drum_mode = 2;
        }
      }
    }
    if (generator.drum_mode == 1) {
      if (-0.5f < sensors.accx && sensors.accx < -0.1f ) {
        generator.drum_mode = 0;
      }
    }
    if (generator.drum_mode == 2) {
      if (0.1f < sensors.accx && sensors.accx < 0.5f ) {
        generator.drum_mode = 0;
      }
    }
  }
#endif
  // キー押されてもしばらくは反応しない処理（ピロ音防止）
  if (keyTimeMs < 1000.0f) {
    keyTimeMs += td;
    if (keyTimeMs >= keySenseTimeMs) {
      keyTimeMs = 1000.0f;
      currentNote = targetNote;
    }
  }
}

//-------------------------------------
void Afuue::MenuExec() {
  key.UpdateMenuKeys(menu.isEnabled);

#ifdef HAS_DISPLAY
  bool result = menu.Update(key.GetKeyPush(), sensors.GetPressureValue(0));
  result |= menu.Update2R(&key);
#else
  bool result = menu.Update2R(&key);
#endif
  if (result) {
    menu.BeginPreferences(); {
      if (menu.factoryResetRequested) {
        //出荷時状態に戻す
        M5.Lcd.fillScreen(BLACK);
        menu.DrawString("FACTORY RESET", 10, 10);
        menu.ClearAllFlash(); // CLEAR ALL FLASH MEMORY
        delay(2000);
        ESP.restart();
      }
      generator.currentWaveTable = menu.waveData.GetWaveTable(menu.waveIndex);
      menu.SavePreferences();
    } menu.EndPreferences();
  } else {
    // menu mode or menu changed
    GetMenuParams();
    if (menu.forcePlayNote >= 0) {
      forcePlayTime = menu.forcePlayTime;
      currentNote = menu.forcePlayNote;
      menu.forcePlayNote = -1;
    }
  }
  menu.Display();
#if TOUCHPIN
  int touch = touchRead(TOUCHPIN);
  if (touch < 20) {
    SetLedColor(0, 0, 200);
    return;
  }
#endif

  int br = (int)(245 * generator.requestedVolume) + 10;
#if defined(NEOPIXEL_PIN)
  if (!menu.isLipSensorEnabled) {
    SetLedColor(0, br, 0);
  }
  else {
      float r = -sensors.bendNoteShift;
      SetLedColor((int)(br * (1 - r)), 0, (int)(br * r));
  }
#endif
#if defined(LEDPIN) && (MAINUNIT == M5ATOM_S3)
  int br2 = (int)(245 * pow(generator.requestedVolume,2));
  if (br2 < 1) br2 = 0;
  if (br2 > 244) br2 = 255;
  ledcWrite(5, br2);
#endif
}

//-------------------------------------
#if 0
void Afuue::SerialTask(void *pvParameters) {
  Afuue* system = reinterpret_cast<Afuue*>(pvParameters);
  KeySystem& key = system->GetKey();
  Sensors& sensors = system->GetSensors();

  while (1) {
    char s[32];
    sprintf(s, "%d,%d,%d,%d", key.GetKeyData(),(int)(sensors.accx*100), (int)(sensors.accy*100), (int)(sensors.accz*100));
    Serial.println(s);
    delay(50);
  }
}
#endif

//-------------------------------------
void Afuue::UpdateTask(void *pvParameters) {
  Afuue* system = reinterpret_cast<Afuue*>(pvParameters);

  unsigned long loopTime = micros();
  while (1) {
    unsigned long t0 = micros();
    float td = (t0 - loopTime)/1000.0f;
    loopTime = t0;

    system->Update(td);
    system->Control(td);
    
    unsigned long t1 = micros();
    int wait = 10;
    if (t1 > t0) {
      wait = 10-(int)((t1 - t0)/1000);
      if (wait < 1) wait = 1;
    }
    delay(wait);
  }
}

//-------------------------------------
void Afuue::MenuTask(void *pvParameters) {
  Afuue* system = reinterpret_cast<Afuue*>(pvParameters);
  while (1) {
    system->MenuExec();
    delay(50);
  }
}

//-------------------------------------
void Afuue::CreateWaveTask(void *pvParameters) {
  Afuue* system = reinterpret_cast<Afuue*>(pvParameters);
  WaveGenerator& generator = system->GetGenerator();
  while (1) {
    uint32_t data;
    xTaskNotifyWait(0, 0, &data, portMAX_DELAY);

    generator.CreateWave(system->IsEnablePlay() && !system->GetMenu().isMidiEnabled);
  }
}

//---------------------------------
void IRAM_ATTR Afuue::OnTimer() {
  portENTER_CRITICAL_ISR(&timerMux);
#ifdef SOUND_TWOPWM
  ledcWrite(0, waveOutL);
  ledcWrite(1, waveOutH);
#else
  dacWrite(DACPIN, waveOutH);
#endif

  BaseType_t higherPriorityTaskWoken = pdFALSE;
  xTaskNotifyFromISR(taskHandle, 0, eNoAction, &higherPriorityTaskWoken);
  portEXIT_CRITICAL_ISR(&timerMux);
}
