otoone-dev/docs/afuue_project/PlatformIO/AFUUE2_nsys/src/WaveTable.h

#pragma once
#include <vector>
#include <string>

const float waveAfuueCla[256] = {
    -0.08316f,-0.14099f,-0.19882f,-0.25040f,-0.28775f,-0.32510f,-0.34079f,-0.34265f,-0.34451f,-0.31738f,-0.28760f,-0.25647f,-0.22083f,-0.18515f,-0.15909f,-0.14169f,
    -0.12427f,-0.11746f,-0.11276f,-0.10748f,-0.09839f,-0.08929f,-0.07700f,-0.06067f,-0.04434f,-0.03433f,-0.02649f,-0.01953f,-0.02835f,-0.03717f,-0.04980f,-0.06927f,
    -0.08875f,-0.11050f,-0.13345f,-0.15637f,-0.16904f,-0.18134f,-0.18808f,-0.18005f,-0.17206f,-0.16101f,-0.14777f,-0.13452f,-0.12668f,-0.11954f,-0.11273f,-0.10730f,
    -0.10184f,-0.09790f,-0.09552f,-0.09314f,-0.08694f,-0.07983f,-0.07175f,-0.05533f,-0.03891f,-0.02380f,-0.01053f,0.00272f,0.01154f,0.01859f,0.02533f,0.01868f,
    0.01199f,-0.00497f,-0.04333f,-0.08170f,-0.13736f,-0.20306f,-0.26877f,-0.31879f,-0.36774f,-0.40237f,-0.39212f,-0.38190f,-0.35077f,-0.30234f,-0.25394f,-0.21469f,
    -0.17700f,-0.14276f,-0.12674f,-0.11072f,-0.10129f,-0.09958f,-0.09784f,-0.10742f,-0.12039f,-0.13470f,-0.16605f,-0.19736f,-0.23615f,-0.28720f,-0.33823f,-0.39224f,
    -0.44760f,-0.50299f,-0.55032f,-0.59756f,-0.64059f,-0.67352f,-0.70645f,-0.72128f,-0.72409f,-0.72687f,-0.70911f,-0.68915f,-0.67014f,-0.65442f,-0.63873f,-0.62924f,
    -0.62549f,-0.62177f,-0.62631f,-0.63266f,-0.63907f,-0.64584f,-0.65265f,-0.65240f,-0.64288f,-0.63336f,-0.60901f,-0.57935f,-0.54855f,-0.49203f,-0.43552f,-0.36896f,
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
    -0.560086f,-0.571576f,-0.583066f,-0.594556f,-0.606043f,-0.617532f,-0.629022f,-0.640509f,-0.651999f,-0.663489f,-0.674976f,-0.686465f,-0.697955f,-0.709445f,-0.720932f,-0.732422f,
};

struct WaveInfo {
    std::string name;
    const float* pWave;
    float attackSoftness;
    float portamento;
    float dropPos;
    float dropAmount;
    float lowPassP; // LowPass Position (ボリュームで変化する位置)
    float lowPassR; // LowPass Position 付近での傾き
    float lowPassQ; // 最大Q
    float lowPassN; // ノート切り替えでのフィルタ効果強さ
    float lfoPower;
    float lfoFreq;
    float lfoDelay;
    float noiseInitial;
    float noiseDecay;
    float noiseSustain;
    WaveInfo()
    {
        WaveInfo("", nullptr, 0.0f, 0.0f, 0.0f, 0.0f, 0.0f, 0.0f, 0.0f, 0.0f, 0.0f, 0.0f, 0.0f, 0.0f, 0.0f, 0.0f);
    }
    WaveInfo(const char* n, const float* w, float a, float m, float d, float v, float p, float r, float q, float lpn, float o, float f, float l, float ni, float nd, float ns)
    : name(n)
    , pWave(w)
    , attackSoftness(a)
    , portamento(m)
    , dropPos(d)
    , dropAmount(v)
    , lowPassP(p)
    , lowPassR(r)
    , lowPassQ(q)
    , lowPassN(lpn)
    , lfoPower(o)
    , lfoFreq(f)
    , lfoDelay(l)
    , noiseInitial(ni)
    , noiseDecay(nd)
    , noiseSustain(ns) {}
};

std::vector<WaveInfo> waveInfos = {
  { "SynthA",     waveSynthA2,     0.8f, 0.8f, 0.0f, 0.0f, 0.5f, 5.0f, 0.5f, 0.1f, 0.0f, 0.0f, 0.0f,  0.0f, 0.0f, 0.0f },
  { "SynthB",     waveSynthB2,     0.7f, 0.8f, 0.0f, 0.0f, 0.6f, 5.0f, 0.8f, 0.1f, 0.05f, 4.0f, 0.9f,  0.0f, 0.0f, 0.0f },
//   name         waveTable       attack porta dropP dropV LP_P  LP_R  LP_Q  LP_N  LFO  freq delay    NIni  NDy  Nsus
  { "A_Clarinet", waveAfuueCla,    0.7f, 0.7f, 0.0f, 0.0f, 0.5f, 5.0f, 0.6f, 0.1f, 0.0f, 0.0f, 0.0f,  0.0f, 0.0f, 0.0f },
  { "A_Recorder", waveAfuueCla,    0.7f, 0.7f, 0.8f, 0.6f, 0.5f, 5.0f, 0.8f, 0.1f, 0.0f, 0.0f, 0.0f,  0.0f, 0.0f, 0.0f },
  { "A_Brass",    waveAfuueBrass,  0.9f, 0.8f, 0.8f, 0.1f, 0.5f, 5.0f, 0.7f, 0.2f, 0.0f, 0.0f, 0.0f,  0.08f, 0.0f, 0.08f },
  { "A_Flute",    waveAfuueFlute,  0.3f, 0.7f, 0.8f, 0.1f, 0.5f, 5.0f, 0.5f, 0.1f, 0.0f, 0.0f, 0.0f,  0.2f, 0.15f, 0.1f },
  { "A_Violin",   waveAfuueViolin, 0.4f, 0.7f, 0.0f, 0.0f, 0.5f, 5.0f, 0.3f, 0.0f, 0.0f, 0.0f, 0.0f,  0.0f, 0.0f, 0.0f },
//   name         waveTable       attack porta dropP dropV LP_P  LP_R  LP_Q  LP_N  LFO  freq delay    NIni  NDy  Nsus
  { "P_Square",   wavePureSquare,  0.8f, 0.8f, 0.0f, 0.0f, 0.5f, 8.0f, 0.7f, 0.1f, 0.0f, 0.0f, 0.0f,  0.0f, 0.0f, 0.0f },
  { "P_Saw",      wavePureSaw,     0.8f, 0.5f, 0.0f, 0.0f, 0.5f, 5.0f, 1.2f, 0.3f, 0.07f, 4.0f, 1.2f,  0.0f, 0.0f, 0.0f },
  { "P_Triangle", wavePureTriangle,0.5f, 0.1f, 0.0f, 0.0f, 0.5f, 6.0f, 2.0f, 0.1f, 0.0f, 0.0f, 0.0f,  0.0f, 0.0f, 0.0f },
};
