otoone-dev/docs/arduino/M5StampS3/stamps3_tone_generator/wavedata.cpp

#include <cstddef>
#include "wavedata.h"

//---------------------------------
// 11.025kHz
const int snare_raw_len = 1211;
const float snare_raw[] = {
-359.0f,-378.0f,8.0f,196.0f,-212.0f,-273.0f,-126.0f,-120.0f,-62.0f,-25.0f,-19.0f,-156.0f,-149.0f,-110.0f,13.0f,-67.0f,-460.0f,-130.0f,247.0f,-79.0f,-20.0f,-40.0f,-312.0f,116.0f,263.0f,-67.0f,162.0f,33.0f,-487.0f,232.0f,200.0f,-643.0f,
-37.0f,-51.0f,-536.0f,127.0f,89.0f,-441.0f,-143.0f,-2.0f,-104.0f,73.0f,-155.0f,-189.0f,338.0f,-4.0f,-228.0f,235.0f,195.0f,-52.0f,-125.0f,204.0f,89.0f,-416.0f,-140.0f,199.0f,220.0f,-65.0f,151.0f,552.0f,-26.0f,283.0f,388.0f,-204.0f,
119.0f,53.0f,352.0f,563.0f,360.0f,369.0f,-485.0f,37.0f,604.0f,-38.0f,-54.0f,-219.0f,-62.0f,-11.0f,133.0f,435.0f,-198.0f,70.0f,-234.0f,-317.0f,542.0f,13.0f,385.0f,385.0f,-208.0f,224.0f,-211.0f,-268.0f,353.0f,758.0f,121.0f,-344.0f,
793.0f,603.0f,-46.0f,-91.0f,18.0f,479.0f,253.0f,497.0f,14.0f,-24.0f,237.0f,-798.0f,791.0f,1558.0f,859.0f,458.0f,-928.0f,205.0f,395.0f,502.0f,1373.0f,329.0f,608.0f,-859.0f,547.0f,646.0f,-487.0f,12959.0f,15413.0f,881.0f,-2156.0f,328.0f,
5317.0f,6411.0f,-2264.0f,-1366.0f,3358.0f,-460.0f,-1042.0f,2965.0f,-84.0f,-1374.0f,3241.0f,-3467.0f,-6539.0f,-1732.0f,-6349.0f,-1531.0f,2578.0f,-7706.0f,-6182.0f,-2791.0f,-7499.0f,-5342.0f,-3154.0f,-5047.0f,-4653.0f,-2859.0f,201.0f,3977.0f,3266.0f,493.0f,491.0f,-1610.0f,
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
  return waveLowPass[index*3+p];
}

const int waveTranspose[] = {
  0,
  0,

  0,
  0,
  0,
  0,
  -12,

  0,
  0,
  0,
};

int WaveData::GetWaveTranspose(int index) {
  return waveTranspose[index];
}

const int wavePortamento[] = {
  15,
  15,

  15,
  15,
  15,
  15,
  15,

  20,
  20,
  90,
};

int WaveData::GetWavePortamento(int index) {
  return wavePortamento[index];
}

const int waveAttackSoftness[] = {
  10,
  30,

  20,
  20,
  5,
  70,
  50,

  20,
  10,
  50,
};

int WaveData::GetWaveAttackSoftness(int index) {
  return waveAttackSoftness[index];
}

const float waveNoiseLevel[] = {
  0.0f,
  0.0f,

  0.0f,
  0.0f,
  0.0f,
  0.1f,
  0.0f,

  0.0f,
  0.0f,
  0.0f,
};

float WaveData::GetWaveNoiseLevel(int index) {
  return waveNoiseLevel[index];
}

const float waveAttackNoiseLevel[] = {
  0.5f,
  0.5f,

  0.5f,
  0.5f,
  0.5f,
  0.5f,
  0.0f,

  0.0f,
  0.0f,
  0.0f,
};

float WaveData::GetWaveAttackNoiseLevel(int index) {
  return waveAttackNoiseLevel[index];
}

const int wavePitchDropPos[] = {
  0,
  0,

  0,
  8,
  0,
  8,
  0,

  0,
  0,
  0,
};

int WaveData::GetWavePitchDropPos(int index) {
  return wavePitchDropPos[index];
}

const int wavePitchDropLevel[] = {
  0,
  0,

  0,
  6,
  0,
  1,
  0,

  0,
  0,
  0,
};

int WaveData::GetWavePitchDropLevel(int index) {
  return wavePitchDropLevel[index];
}

const float* WaveData::GetSinTable() const {
  return sinTable;
}

const float* WaveData::GetTanhTable() const {
  return tanhTable;
}

const int WaveData::GetDrumLength(int index) const {
  if (index == 0) {
    return snare_raw_len;
  }
  return kick_raw_len;
}

const float* WaveData::GetDrumData(int index) const {
  if (index == 0) {
    return snare_raw;
  }
  return kick_raw;
}
