otoone-dev/docs/(commit log)

2019-05-07 otooneページ追加
2019-05-09 組み立てマニュアルの準備
2019-05-09 afuue_project 追加
    [test.kicad_pcb, test.sch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]
2019-05-09 afuue_project に Model3D を追加
    [WindSynth4Body.stl, WindSynth4Keys.stl, WindSynth4Mini.stl, WindSynth4Mouth.stl, WindSynth4_Opt1.stl]
2019-05-09 otoone ページに情報追加
2019-05-09 タグ修正
2019-05-13 AFUUE 組み立て行程に写真追加
2019-05-13 ２音合成
2020-06-01 情報を５号機のものに更新
    [WindSynth5.stl, WindSynth5Keys.stl, WindSynth5_bd.stl, WindSynth5_mp.stl, WindSynth5_mpcv.stl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]
2020-06-01 画像追加忘れ
2020-06-01 動画を追加
2020-06-01 ブレスセンサーの 3D データと、モニタソフトの zip を配置
2020-06-01 Arduino のソースも追加
2020-06-03 ブレスセンサーのモニターにレンジとテスト範囲の設定と保存ができるように改造
2020-06-04 AFUUE の基板写真を追加
2020-08-01 運指の変更(Bb含めて全般)、MIDI 出力対応
2020-08-01 インストール方法のページを追加
2020-08-01 AFUUE ページに各部名称と運指を追加
2020-08-01 otoone ページから afuue へのリンクを追加
2020-08-01 ファイル名修正
2020-08-01 再度ファイル名修正
2020-08-05 マニュアルなどを追加
    [body.stl, keys.stl, keys_pla.stl, keys_tpu.stl, mouthpiece.stl, mp_cover.stl, mp_holecap.stl, パーツリスト.xls]
2020-08-05 マニュアルに日本語一部追加
2020-08-12 使用ツール説明用
    [mp_holecap_h2.stl, mp_holecap_h3.stl, mp_holecap_h4.stl]
2020-08-18 設定ツールの追加と、ツールとの通信対応など
    [mp_holecap.stl]
2020-08-18 exe と obj を削除
2020-08-19 説明更新
2020-08-19 説明追加
2020-09-01 ページの情報を修正
2020-09-05 KiCad データは ver.1.5 に向けて改造中。 AFUUE ソース、ツールともに下記の機能を追加、機能改善 ・ 通信同期 ・ ノイズ、ピッチを音量で可変 ・ メトロノーム ・ 和音
    [DisplayBase.stl, key_tpu_1.stl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]
2020-09-05 不要ファイルの削除
2020-09-10 名刺の画像追加
2020-09-10 和音の sus4 を 7th に変更
2020-09-10 HelpWindow 追加
2020-09-14 和音操作方法変更、MIDIコントロール追加、Preferences保存失敗を修正
2020-10-08 AFUUE page の改善、MakerFaireTokyo2020向けのポップ、次期基板への準備など
    [DisplayBase.stl, WindSynth4Body.stl, WindSynth4Keys.stl, WindSynth4Mini.stl, WindSynth4Mouth.stl, WindSynth4_Opt1.stl, keys_resin.stl, mouthpiece_w.stl]
2020-10-23 現状のものを一旦コミット（KORG NTS-1対応含む）
    [Functions.ods, keys_resin_base.stl, keys_resin_cover.stl, keys_silencer.stl, windsynyh5.kicad_pcb, windsynyh5.sch]
2020-11-03 基板発注したので
    [windsynyh5-B.Cu.gbl, windsynyh5-B.Mask.gbs, windsynyh5-B.Paste.gbp, windsynyh5-B.SilkS.gbo, windsynyh5-Edge.Cuts.gm1, windsynyh5-F.Cu.gtl, windsynyh5-F.Mask.gts, windsynyh5-F.Paste.gtp]
2021-03-27 電池内蔵版v06のソースやデータを追加
    [WindSynth4Body.stl, WindSynth4Keys.stl, WindSynth4Mini.stl, WindSynth4Mouth.stl, WindSynth4_Opt1.stl, WindSynth5.stl, WindSynth5Keys.stl, WindSynth5_bd.stl]
2021-03-27 v06 のソフトウェア(zip)を追加
2021-03-28 ページを更新
2021-04-03 v1.6 のマニュアル追加
    [パーツリスト.xls]
2021-04-25 v6向け更新
    [keys_resin.stl, keys_resin_base.stl, keys_resin_cover.stl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]
2021-05-07 ページなどを更新
2021-05-11 ３Ⅾデータを２つ追加
    [front_face.stl, mp_holecap.stl]
2021-12-04 pc-1245(2021/11/23版) SPI, I2C に問題がある
    [Logo.stl]
2021-12-04 PC1245 (2021/11/23版) SPI/I2C 回路に問題がある
    [pc1245-B_Cu.gbl, pc1245-B_Mask.gbs, pc1245-B_Paste.gbp, pc1245-B_SilkS.gbo, pc1245-Edge_Cuts.gm1, pc1245-F_Cu.gtl, pc1245-F_Mask.gts, pc1245-F_Paste.gtp]
2021-12-04 2021/10/10 版。 ALLPCB に発注したのは、この中の１枚だけ
    [windsynth-B_Cu.gbl, windsynth-B_Mask.gbs, windsynth-B_Paste.gbp, windsynth-B_SilkS.gbo, windsynth-Edge_Cuts.gm1, windsynth-F_Cu.gtl, windsynth-F_Mask.gts, windsynth-F_Paste.gtp]
2021-12-04 2021/12/03 版 M5StickC 版 9 キー AFUUE 基板
    [windsynth-B_Cu.gbl, windsynth-B_Mask.gbs, windsynth-B_Paste.gbp, windsynth-B_SilkS.gbo, windsynth-Edge_Cuts.gm1, windsynth-F_Cu.gtl, windsynth-F_Mask.gts, windsynth-F_Paste.gtp]
2022-05-10 Core2 向けドラム
    [windsynth.kicad_pcb]
2022-05-10 StickC 向け AFUUE
2022-05-10 AfuueEditor をとりあえず追加
2022-05-10 kicad library 追加
2022-05-10 kicad windsynth8 を windsynth8a にリネーム
    [windsynth-B_Cu.gbl, windsynth-B_Mask.gbs, windsynth-B_Paste.gbp, windsynth-B_SilkS.gbo, windsynth-Edge_Cuts.gm1, windsynth-F_Cu.gtl, windsynth-F_Mask.gts, windsynth-F_Paste.gtp]
2022-05-10 kicad windsynth8b を追加
    [windsynth-B_Cu.gbl, windsynth-B_Mask.gbs, windsynth-B_Paste.gbp, windsynth-B_SilkS.gbo, windsynth-Edge_Cuts.gm1, windsynth-F_Cu.gtl, windsynth-F_Mask.gts, windsynth-F_Paste.gtp]
2022-05-10 kicad windsynth7 を追加
    [windsynth-B_Cu.gbl, windsynth-B_Mask.gbs, windsynth-B_Paste.gbp, windsynth-B_SilkS.gbo, windsynth-Edge_Cuts.gm1, windsynth-F_Cu.gtl, windsynth-F_Mask.gts, windsynth-F_Paste.gtp]
2022-09-07 9号機の基板(Kailhロープロファイル&PCF8574T版)を発注したのでコミット
    [windsynth.kicad_pcb]
2022-09-07 傾きによる「がなり」などをテスト実装
2022-09-07 9号機の初期ソースをいったんコミット
2022-12-07 AFUUE2(v9)向け販売時ソース
2022-12-07 AFUUE2(v9)基板データ
    [face-B_Cu.gbr, face-B_Mask.gbr, face-B_Paste.gbr, face-B_SilkS.gbr, face-Edge_Cuts.gbr, face-F_Cu.gbr, face-F_Mask.gbr, face-F_Paste.gbr]
2022-12-07 AFUUE2(v9)用マニュアル
    [Manual.ods]
2022-12-07 AFUUE2(v9)用3Dモデルデータ
    [Afuue9_body.stl, Afuue9_face.stl, Afuue9_tubecover.stl]
2023-05-05 AFUUE_v09 ソースコードzip 追加など
    [windsynth.kicad_pcb]
2023-05-05 windsynth10 基板データ追加
    [face-B_Cu.gbr, face-B_Mask.gbr, face-B_Paste.gbr, face-B_SilkS.gbr, face-Edge_Cuts.gbr, face-F_Cu.gbr, face-F_Mask.gbr, face-F_Paste.gbr]
2023-05-05 ドキュメント更新
2023-07-13 AFUUE2 PWMx2 Version (1.9c)
2023-09-01 2PWM 版の AFUUE2 ソフトウェア
2024-01-08 arduino ソースを３つ追加
2024-01-08 arduino ソース１つ追加
2024-02-29 テスト波形が入っていたので修正
2024-03-02 ホームページを更新
2024-11-21 LPS33対応（アドレス違い＝センサー２個には未対応）
2025-01-01 波形生成テスト
2025-01-01 LowPassフィルタ追加
2025-01-02 ローパス計算を波形生成の外に
2025-01-02 ローパスの計算を波形生成の外に。波形シフトを無効に
2025-01-03 クリティカルセクション記述追加、ローパスパラメータ変更
2025-01-07 ローパス演算の高速化、三角関数テーブルを大きいものに変更
2025-01-12 高速化とメニューまわり調整
2025-01-16 アタックをプリセット化。M5StickCへのCanvas対応。
2025-01-20 Menu関係、キー操作関係、波形生成関係をソース分離中
2025-01-21 AFUUE2R で操作時に音が鳴らない不具合の修正
2025-01-26 気圧センサー読み取り部分を別ソースに分離
2025-01-29 リファクタリング
2025-02-03 リコーダー追加（音量でのピッチ変更）、リファクタリング
2025-02-04 AFUUE2, AFUUE2R ソースzip
2025-02-04 初期リリース版
    [Manual.ods]
2025-02-04 パラメータ微調整したもの
2025-02-04 パラメータ微調整
2025-02-04 マニュアルを更新
    [Manual.ods]
2025-02-05 ページ更新
2025-02-06 説明ページ追記
2025-02-06 HasDisplay とかの関数を廃止
2025-02-10 ドラムを追加
2025-02-15 ドラムモード更新
2025-02-27 ドラムの波形を変更
2025-02-27 AFUUE2R でオプション操作が効いてなかったのを修正、番号指定の音色変更に対応
2025-02-27 不具合修正、ドラム追加(AFUUE2のみ)、番号指定音色変更(AFUUE2Rのみ)
2025-02-27 AccDrum追加
    [Manual.ods]
2025-03-02 テストコード追加
    [partitions.csv]
2025-03-06 ルービックキューブ風の描画を追加
2025-03-21 AFUUE2R gen2 対応中
2025-06-12 テストコードを追加
2025-07-20 v10 lite manual
    [Manual.ods]
2025-09-02 AFUUE2R gen2 対応 (LPS33x2)
2025-09-15 LPS33 + MCP23017 の I2C 競合を解決
2025-09-18 処理時間の調整
2025-10-19 動作COREを変更
2025-11-19 音源ボード向けコード追加
2025-11-24 AFUUE2,AFUUE2R,tone_generator のソース追加
2025-12-14 とりあえず MIDI 受けて鳴るように
2025-12-16 音源にとりあえずメニューを追加（うまく動いてない）
2025-12-17 AFUUE_soundtest に AFUUE2 First 追加
2025-12-20 STAMPS3 と ATOMS3 の LED を追加
2025-12-28 AFUUE2R Lite 向け微修正
2025-12-30 PlatformIO環境追加 （AFUUE2R gen2 で I2C 以外のサンプル実装)
2025-12-30 PlatformIO版、I2CによるLPS33制御とATOMS3の画面制御を追加
2026-01-02 ソース分離、MCPWM 採用 MCPWM は LEDC より高速更新が可能。LEDC が 5us ほどかかってたところ MCPWM は 1us。
2026-01-02 負荷表示対応、MCPWM を 16bit に
2026-01-03 PlatformIO版をリングバッファに
2026-01-05 ノイズ対策の試行錯誤中 いろいろやったが、結局 M5AtomS3 だと M5.begin あたりを通るとノイズが発生する模様 M5AtomS3 Lite だとそれほどノイズ出ないかも
2026-01-06 波形生成を分離。波形テーブル音源とディレイを追加。
2026-01-06 フィルタ追加
2026-01-06 キーの反応を鈍化、波形生成調整
2026-01-08 気圧センサー(LPS33)２つの読み込みに対応、ベンド操作に対応
2026-01-08 LPS33初期化修正、M5AtomLite対応修正
2026-01-12 ソース整理
2026-01-14 ハードウェア切り替え対応中
2026-01-15 FastLEDをやめてNeopixelに変更
2026-01-15 サウンドプロセッサを外から注入する形に変更
2026-01-15 音色切り替えに簡易対応
2026-01-19 Menu追加中
2026-01-19 M5StickCでピエゾ
2026-01-23 キーによるメニュー操作に対応（音色切り替えとトランポーズのみ）
2026-01-25 AFUUE2R向けメニューを整備
2026-01-28 MIDI対応準備
2026-01-29 LFOテスト実装、LED不具合修正
2026-02-11 USBMIDIとりあえず動く
2026-02-12 SerialMIDI対応
2026-02-16 ベンド修正、MIDIのNoteOn/Off修正
2026-02-19 ロゴ追加、LFO調整
2026-02-22 MIDI修正、ディスプレイ修正
2026-02-22 MIDI修正、音源実装準備、define整理
2026-02-22 microsオーバーフローをmillisに修正
2026-02-24 v10 gen2 manual
    [Manual.ods]
2026-02-25 Preferences対応
2026-02-26 MIDIブレス出力切り替えを追加
2026-02-26 MIDIブレス出力設定にしたがってMIDI出力を切り替え
2026-02-26 ブレス感度修正＆保存
2026-02-27 ノイズ追加、アタック修正、LFO発動時間追加
2026-02-28 ローパスを音程切り替え時にも適用、他パラメータ微調整
